bradgrantham/other-m68k/emu/README.md

# other-m68k emulator

`m68k-emu` runs the board's ROM on a Musashi 68000 core with a model of the two CPLDs and the
peripherals: 1 MB RAM, the 1 MB ROM window (two SST39SF040 flash chips, in-system
programmable) with the reset overlay, the CPLD2 registers, the soft
switches, the 320x240 RGB332 framebuffer in an SDL2 window, the 68681 DUART (channel A is the
host's stdin/stdout: the BIOS's POST and banner, then whatever a program sends to `/dev/ttya`), the PS/2 keyboard, an SDHC card on the native 4-bit SD bus (spec rev 7), the 8-bit PDM audio shifter (spec rev 5)
and the NMI/reset buttons.
Addresses, bits and timing constants come from `generated/hw.h` / `generated/emu_map.h`; nothing
is hard-coded that the spec defines.

## Building and running

```
make -C emu            # emu/build/m68k-emu  (needs sdl2-config, host cc)
make -C emu test       # build emu/test/test.S with the m68k cross toolchain and run it headless
make -C emu clean
make emu / make run    # from the top level
```

```
m68k-emu --rom fw/build/flash.img [options]      # or --rom fw/build/rom.bin: BIOS only, C: unformatted

  --rom FILE          ROM window image (<= 1 MB, padded with 0xFF): flash.img = BIOS + C: volume    --sd FILE        SD card image, any multiple of 512 bytes (read/write)
  --rom-save FILE     write the flash contents to FILE at exit if a program/erase changed them (`make run` passes flash.img itself, so C: persists)
  --scale N           window scale (default 3, nearest-neighbour)    --pal            fit the PAL jumper (INTSTAT.PALJMP = 1)
  --fast              no real-time pacing (audio off)                --headless       no window, no audio (works without a display)
  --frames N          exit after N frames                            --trace          disassemble each instruction to stderr
  --trace-from ADDR   start tracing when PC first reaches ADDR       --break ADDR     dump registers and exit when PC reaches ADDR
  --serial-log FILE   copy of the serial (DUART channel A) output     --duart-b-log FILE  DUART channel B output (dropped otherwise)
  --type STR          type STR on the PS/2 keyboard (\n = Enter)     --type-delay N   ... starting after N frames (default 120)
  --serial-type STR   feed STR into the serial port (\n = CR)         --serial-type-delay N  ... after N frames (default 120)
  --joy LIST          hold joystick switches: up,down,left,right,fire       --paddle A,B|pad  paddles at A,B (0..1023) or from a game controller's triggers
  --sd-trace          log SD commands to stderr                      --exit-on-berr   exit with status 2 on the first bus error
  --sd-sdsc           emulate a byte-addressed SDSC card (CSD v1)
  --io-trace          log CPLD2 and DUART register accesses, soft switches and serial RX arrivals with cycle stamps
  --dump-regs-on-exit                                                --dump-mem ADDR LEN   hex dump at exit (repeatable)
  --text-dump FILE    the 40x30 console text decoded from page 0 at exit (- = stdout); the BIOS console is video only after the POST
  --no-audio          disable audio                                  --no-stdin       do not read serial RX from stdin
  --audio-wav FILE    write the rendered audio to a 48 kHz 16-bit mono WAV (also with --headless / --fast)
  --audio-edge-log FILE  log every audio pin edge as 'cycle level' (timing checks)
```

Numbers accept `0x` prefixes. Exit status: 0 normal (frame count reached, window closed,
breakpoint, Ctrl-C), 1 usage/file error, 2 `--exit-on-berr`, 3 CPU halted by a double bus fault
in headless mode.

**stdout carries only the serial output** (unbuffered), so `m68k-emu ... | tee log` or a
terminal program can be attached to it. Everything else (bus errors, SD trace, breakpoints,
dumps, the end-of-run summary) goes to stderr.

Keys in the window: **F11** = reset button (CPU and glue, overlay re-armed), **F12** or
**Pause** = NMI button (INTSTAT.NMIBTN while held, level 7 edge), every other key goes to the
PS/2 keyboard as scan code set 2 (letters, digits, punctuation, space, Enter, Backspace, Tab,
Escape, Shift/Ctrl/Alt/GUI, Caps Lock, arrows, F1-F10, Home/End/PgUp/PgDn/Insert/Delete, keypad).
F11/F12 never reach the keyboard. Window title shows the standard and LED0/LED1.

Serial RX comes from stdin (and from `--serial-type`): when stdin is a tty it is switched to a
raw-ish mode (no echo, no line editing, Ctrl-C still works) for the duration and restored at
exit; a pipe or file works too. Bytes arrive on the DUART's channel A at the console rate
(`SERIAL_BAUD`, one byte per ten bit times) whatever the firmware programmed, so, as on the real
board, bytes that arrive while the receiver is disabled are lost and a burst longer than the
3-byte FIFO plus the shift register sets OE. Piping input in at start-up therefore loses most of
it during the firmware's POST; `--io-trace` shows each arrival. If channel A is enabled at a
rate other than `SERIAL_BAUD` the emulator says so once on stderr (data still flows).

## Timing model

* One Musashi slice per scanline: `line_clocks` CPU clocks (764 NTSC / 768 PAL). The slice
  begins at the HSYNC leading edge, where CPLD1's V counter advances: INTSTAT.HSYNC is set
  there, and INTSTAT.VBLANK at the start of line `v_active + v_bottom` (243 NTSC, 270 PAL),
  the leading edge of VSYNC. The instruction that overruns the budget is charged to the next
  line, so a frame is exactly 764*262 = 200,168 (NTSC) or 768*312 = 239,616 (PAL) clocks and
  the cycle counter stays exact over any interval.
* Live pins in INTSTAT are computed from the position inside the slice: HSYNCPIN during the
  first `h_sync` clocks, DEPIN during `[h_sync + h_back, + h_active)` on active lines,
  VSYNCPIN on the `v_sync` lines.
* The soft switches (PAGE0/1, NTSC/PAL) are latched at the start of line 0 of the next frame,
  as CPLD1 reloads VA. Reset selects NTSC; `--pal` only fits the jumper (PALJMP); firmware
  picks the PAL table with SW_PAL.
* Interrupt priority is recomputed after every flag or enable change: the highest level among
  pending-and-enabled sources (VBLANK 1, PS2 2, DUART 3, HSYNC 4), 7 while the NMI button is
  held. The DUART source is level sensitive: level 3 is requested while the DUART's IRQ output
  ((ISR & IMR) != 0) is asserted and INTEN.DUART is set. All vectors are autovectors (CPLD1 asserts VPA on IACK). Musashi samples IPL only at
  the start of a slice and on SR writes, so a memory handler that changes the level ends the
  slice and the CPU sees it after the current instruction.
* The framebuffer is converted from the displayed page at the end of the last active line (239)
  and presented at the end of the frame, paced to 59.95 Hz (NTSC) or 50.08 Hz (PAL) unless
  `--fast`. `--headless` runs flat out with no SDL at all.
* Memory accesses cost Musashi's nominal cycle counts. The slot alignment penalty of RAM
  accesses on the real board (0 or 2 extra clocks, see `docs/architecture.md` section 2) is not
  modelled, so RAM-heavy code runs 10-25% faster in emulation than on hardware.

## Memory and bus behaviour

* RAM at `RAM_BASE`, ROM at `ROM_BASE` (padded to the 1 MB window with 0xFF; images larger than
  the window are rejected). The window is two SST39SF040 flash chips (`bus.c`, "flash"): a write
  in the ROM region (ROMWE) is fed to a per-byte-lane JEDEC command decoder: unlock
  (AA@5555, 55@2AAA in chip byte addresses, i.e. `FLASH_CMD1`/`FLASH_CMD2` as word writes), byte
  program (A0; bits can only be cleared), sector erase (80 AA 55, 30@sector; 4 KB per chip =
  `FLASH_SECTOR_BYTES` in the CPU view), chip erase (.. 10), software ID (90: `FLASH_MFR_ID`,
  `FLASH_DEV_ID` at chip addresses 0/1) and F0 (exit ID mode). Writes outside a sequence are
  ignored. After a program or erase the lane answers the next few reads with the status bits
  (DQ7 inverted, DQ6 toggling) and then the array data, so the firmware's polling is exercised;
  code fetched from a busy chip is garbage, as on hardware. `--rom-save FILE` writes the window
  back at exit when it was changed (the firmware's `flash` command is tested this way, see
  `fw/README.md`).
* Overlay: set at reset; while set, reads in the RAM region return ROM and writes are dropped.
  It clears at the end of any access whose address is in the ROM region, so the fetch of the
  first instruction at the reset PC clears it.
* IO region: the eight 16-bit registers repeat every 16 bytes (A1..A3 select). CPLD2 has no
  UDS/LDS, so byte accesses are undefined on hardware; here a byte read returns its half of
  the word (with the register's read side effects) and a byte write updates only that half of
  the emulator's shadow. INTEN, GPIO and AUDIO are write-only and read as 0. SDIO (spec rev 7)
  stores six open-drain drive bits for the card lines (1 = released) and reads back the line
  levels, the AND of the host's drive and the card's; offset 12 (the old USERIO) has no
  register (reads 0, writes ignored); ID reads `IO_ID_RESET`.
  32-bit accesses are two word accesses, high word first.
* SWITCHES region: a write at offsets 0/2/4/6 performs PAGE0/PAGE1/NTSC/PAL; reads return
  0xFFFF.
* DUART region: the 68681 is on D0..D7 with RS4..RS1 = A4..A1, so its registers are the odd
  bytes 0xF20001, 0xF20003, ... 0xF2001F, mirrored every 32 bytes through the region. Byte
  accesses at odd addresses are the real thing. A word access completes (DTACK comes from the
  chip) and behaves as the odd byte with 0xFF in the upper half; an even-byte access completes,
  reads 0xFF and reaches no register. Both are reported once on stderr (what the chip makes of
  them on hardware is undefined).
* Anything else raises BERR with the 68000's 7-word group-0 frame: access info word
  (R/W bit 4 = 1 for read, I/N bit 3, FC bits 2..0), fault address, IR, SR, PC. The emulator
  logs `bus error: read 400000 at PC=E00500 (FC=5, ...)` to stderr, at most 10 lines per
  emulated second. Addresses 0xFFFFF0..0xFFFFFF (the IACK pattern) never BERR. A bus error
  while the frame is being written halts the CPU (double fault); headless runs exit with
  status 3, a windowed run says so and waits for F11.
* The RESET instruction does not reset the glue (architecture.md section 6).

### Musashi patch

Stock Musashi always pushes the 68010 format-8 frame on a bus error. `musashi-berr-frame.patch`
(applied to `musashi/m68kcpu.h`) makes `m68ki_exception_bus_error()` push the 68000 frame via
`m68ki_stack_frame_buserr()` when the CPU type is 68000; `bus.c` fills `m68ki_aerr_address`,
`m68ki_aerr_write_mode` and `m68ki_aerr_fc` before calling `m68k_pulse_bus_error()`. The
function code comes from the zero-cost `M68K_SET_FC_CALLBACK` macro in `m68kconf.h`
(`emu_fc`). If Musashi is ever re-vendored, re-apply the patch.

## Peripherals

* **DUART** (`duart.c`): register-level MC68681. Per channel: MR1/MR2 behind the mode-register
  pointer (reset by the CR command), CSR, CR (enable/disable RX and TX, reset MR pointer, reset
  RX, reset TX, reset error status; break commands accepted and ignored), SR (RXRDY, FFULL,
  TXRDY, TXEMT, OE; PE/FE/RB always 0), a 3-byte receive FIFO with the shift register behind
  it (a fourth byte waits there, a fifth sets OE and replaces it), transmit holding + shift
  registers. Shared: ISR (TXRDYA/B, RXRDYA/B or FFULLA/B per MR1[6], CTR, IPC from the
  input-change detector; DBA/DBB always 0), IMR, IVR (stored, reset 0x0F), ACR, IP (the joystick
  port, see below), IPCR (delta bits per ACR[3:0], cleared by the read), OPCR, OPR set/reset
  (OP0 drives the paddle discharge). The
  counter/timer works in counter mode (START loads the preload and counts, terminal count sets
  CTR and rolls over, STOP stops and clears CTR, CUR/CLR read the count) and timer mode (runs
  continuously, CTR every 2*N source clocks, START restarts the phase, STOP only clears CTR)
  from the crystal (X1) or X1/16; the IP2 sources never tick; TxCA/TxCB 1X sources count at
  the channel's bit rate. Bit times come from the data-sheet CSR table (set 1 with ACR[7] = 0,
  set 2 with ACR[7] = 1; code 0xD from the timer; 0xE/0xF external = console rate) and the
  frame length from MR1/MR2, converted to CPU clocks. A byte written to TBA goes straight into
  the shift register if that is idle (TXRDY stays set, TXEMT clears) or waits in the holding
  register (TXRDY clears); it reaches stdout/`--serial-log` when its stop bit ends, and
  back-to-back bytes keep the line busy. Channel B transmits into `--duart-b-log` (or nowhere)
  and never receives. IRQ = (ISR & IMR) != 0 feeds INTSTAT.DUARTIRQ and the level-3 request.
  Reset per the data sheet: both channels disabled, IMR/ISR/OPR/OPCR 0, MR pointers at MR1.
  Not modelled: parity/framing/break detection, CTS/RTS, loopback and multidrop modes,
  1X/16X clock outputs on OP pins, the "do not access" test
  registers (they read 0xFF with a one-time warning).
* **Serial** (`serial.c`): the host side of channel A (stdout, `--serial-log`, stdin raw
  mode, `--serial-type` injection) and channel B's log file; no timing of its own. The BIOS
  mirrors only the POST and banner there, so `--text-dump` (video.c) decodes the 40x30
  console text from page 0 by matching 8x8 cells against the BIOS font.
* **PS/2** (`ps2.c`): make/break sequences queued and delivered one byte per 1 ms of emulated
  time, only while PS2RDY is clear (the register is a single holding latch). Host-to-device
  traffic on GPIO.PS2CLK/PS2DAT is not emulated; the lines read back as the GPIO drives them
  (pulled up when released).
* **SD card** (`sdcard.c`): a card on the native SD bus (not SPI), clocked by the host's
  writes to SDIO.CLK: it samples CMD and DAT0..3 on the rising edge and changes its own outputs
  after the falling edge, so a host that lowers CLK, reads SDIO, then raises CLK sees the card's
  bits at the right time. Every line is open drain: the card drives 0 or releases, and SDIO reads
  the AND of both sides. Commands are 48-bit frames with CRC7, which the card checks (bad CRC: no
  response, COM_CRC_ERROR in the next one; unknown command or wrong state: no response,
  ILLEGAL_COMMAND in the next one). Supported: CMD0 (no response), CMD2 (CID), CMD3 (RCA 0x1234,
  R6), CMD7, CMD8 (R7 echo), CMD9 (CSD v2 sized from the image, v1 with `--sd-sdsc`), CMD10,
  CMD12, CMD13, CMD16 (512 only), CMD17, CMD18, CMD24, CMD25, CMD55, ACMD6 (bus width 1 or 4),
  ACMD41 (busy on the first poll, ready on the second; an SDHC card needs CMD8 first and HCS set,
  as real cards do; OCR then has CCS), ACMD51 (SCR). Timing: response start bit 8 clocks after
  the command's end bit (Ncr), read data start bit 8 clocks after the response (Nac), CRC status
  token 2 clocks after a written block's end bit, then DAT0 busy for 16 clocks. Data blocks are
  512 bytes: 1 bit per clock on DAT0, or after ACMD6 a nibble per clock on DAT3..0 (DAT3 = MSB,
  high nibble of a byte first), each line followed by its own CRC16-CCITT and an end bit; a write
  reaches the image only when every CRC is right (token 010), otherwise token 101. Block
  addressing (SDHC) by default; `--sd-sdsc` makes a byte-addressed SDSC card. `--sd-trace` logs
  every command, state change and block transfer.
* **Audio** (`io.c`, `audio.c`): the AUDIO register (byte offset 10, write-only) loads an 8-bit
  rotating shift register whose bit 7 is the audio pin. It rotates left at each line start (the
  HSYNC leading edge) and then every 24 slots = 96 CPU clocks, 8 slots per line; the slot
  counter restarts at HSYNC, so the 8th timed rotation never happens and the HSYNC rotation
  takes its place. A write replaces the register at once (a rotation due in the same cycle is
  suppressed) and a line without a write repeats the previous byte, as on the CPLD. Note that
  the byte streams out bit 7 first only if it is written in the first slot (within 96 clocks of
  HSYNC); a write in slot k leaves the pattern rotated right by k at the next line start, which
  changes bit order but not density. The shifter is evaluated lazily in time order (rotations
  are applied up to each write, each line start and the end of each frame) and every change of
  bit 7 goes to the renderer as a cycle-stamped edge. The renderer runs the board's RC low-pass
  (`AUDIO_LP_R_OHM` / `AUDIO_LP_C_NF` from the spec, 1 k / 33 nF = 4.8 kHz) over the pin waveform
  exactly, integrates its output over 240 kHz sub-samples, low-passes at 20 kHz with a 95-tap
  windowed-sinc FIR (the anti-alias filter of the sound card the jack would feed) and decimates
  to 48 kHz mono, then a one-pole high-pass stands in for the DC-blocking capacitor. (Up to
  2026-10-22 it box-averaged the pin straight into 48 kHz samples, which let the 63 kHz idle
  tone and the sigma-delta noise above 24 kHz alias into the audio band at about -14 dB:
  the emulator hissed and whined even at idle, which the board does not.) The result is
  queued to SDL (not with `--headless`) and/or written to `--audio-wav FILE`, which works in every mode and receives
  every sample from cycle 0. GPIO bit 2 (the rev 4 audio bit) is stored but does nothing.

* **Joystick port** (spec rev 11): `joy.c` models the Atari port on the DUART's IP/OP pins.
  `--joy` holds switches (active low on IP0..IP4); a game controller, if SDL finds one when a
  window is open, drives them live (d-pad or left stick, any face button = fire). `--paddle A,B`
  puts paddles on the port: once the BIOS releases the discharge (OPR bit 0 set = OP0 low) the
  up and down lines fall A/1023 and B/1023 of `PADDLE_FULL_SCALE_US` (12 ms) later, and rise as
  soon as the capacitors are shorted again; `--paddle pad` takes the positions from the
  controller's triggers. The DUART model gained the input-change detector: the lines are
  compared on every tick (once per video line, so the emulated paddle resolution is about 64 us)
  and on every port read, `IPCR` returns the delta bits and clears them, `ISR.IPC` follows the
  ACR enables, and `OPR_SET`/`OPR_RESET` drive the discharge. Without `--paddle` the lines never
  fall, as with a real joystick.

## Test

`make -C emu test` assembles `test/test.S` (vectors with SSP = SYS_STACK_TOP and PC in ROM),
runs it with `--headless --fast --frames 120 --serial-type ABCDEF --serial-type-delay 1
--serial-log ... --dump-mem 0x800 96` plus an SD image whose block 0 carries a signature, and
`test/check.sh` verifies (57 checks of the ROM run, plus `test/sdtest`, a host-side unit test of the card model: CRC7 and CRC16, 1-bit and 4-bit reads and writes, the CRC status token and busy, bad-CRC and illegal commands, out-of-range and CMD18/CMD12; 50 checks): RAM pattern, ID register, the gradient fill runs, the
DUART init sequence from the spec (IVR 0x0F at reset, MR1A/MR2A read back through the pointer,
SRA = TXRDY+TXEMT after enable), "HELLO\n" sent by polling TXRDY appears on stdout and in the
serial log (and SRA reads 0 while a byte shifts with another in the holding register), a word
read of SRA gives 0xFF in the upper byte and one warning, six bytes injected while the interrupt
is masked leave SRA = RXRDY+FFULL+OE with A B C in the FIFO and F in the shift register (D and E
overrun), the IRQ pin shows in INTSTAT.DUARTIRQ but no interrupt is taken until INTEN.DUART is
set, then exactly one level-3 autovector interrupt drains B C F, reset-error-status clears OE,
counter mode (X1/16, preload 64) reaches terminal count under polling and STOP_CTR clears CTR
and leaves a rolled-over count, timer mode (preload 72, 625 us) delivers 40..100 CTR interrupts
during the three-frame VBLANK wait, VBLANK autovector interrupts are counted (and INTSTAT inside
the handler shows VSYNCPIN without DEPIN), lines per frame measured by counting HSYNC flags
between VBLANKs are 262/312/262 across SW_PAL and SW_NTSC, a read of 0x400000 produces exactly
one bus error whose frame carries fault address 0x400000 and access info 0x0015 (read,
supervisor data), the SD card (native bus, 1-bit) gives CMD0 no response, answers CMD8 with the R7 echo, ACMD41
twice (ready with CCS on the second poll), CMD2, CMD3 (RCA 0x1234), CMD7 and CMD17, and block 0
matches, stdout equals the serial log, the end-of-run summary counts 6 bytes
in with 2 overruns, and the total cycle count is a whole number of frames. The PDM shifter is
checked from `--audio-edge-log`: after one write of 0xB1 every line produces 4 edges, alternating,
three of the four gaps per line are exactly 96/192/288 clocks and the one spanning the line start
is a 1..3 slot run plus the line-start jitter; the `--audio-wav` file has a consistent RIFF header,
48 kHz, one sample per 250 clocks of the run, and is not silent.

## Layout

| file | contents |
|---|---|
| `main.c` | options, Musashi setup, per-line loop, pacing, SDL events, dumps |
| `bus.c/h` | decode, RAM/ROM, overlay, BERR frame, side-effect-free peeks, hex dump |
| `io.c/h` | CPLD2 registers, W1C flags, write-only shadows, PDM audio shifter, IPL, soft-switch latches, `--io-trace` |
| `video.c/h` | NTSC/PAL timing, live pins, RGB332 -> ARGB8888, SDL window |
| `duart.c/h` | MC68681 model: channels, FIFOs, ISR/IMR, counter/timer, bit timing |
| `serial.c/h` | DUART channel A host side: stdout, logs, stdin raw mode, `--serial-type` |
| `ps2.c/h` | scan code set 2 keyboard, `--type` |
| `sdcard.c/h` | native-bus SD card (1- and 4-bit data, CRC7/CRC16, state machine) |
| `audio.c/h` | audio pin renderer: edges -> 48 kHz, SDL queue, `--audio-wav`, `--audio-edge-log` |
| `m68kconf.h` | Musashi configuration (68000 only, INT_ACK, FC macro) |
| `musashi/` | vendored Musashi core (+ `musashi-berr-frame.patch`) |
| `test/` | self-test ROM, linker script, `check.sh` |
