bradgrantham/other-m68k/kicad/release/README.md

# other-m68k release snapshot

Generated by `make -C kicad board route fab release` from the commit that last touched this directory.

- `other-m68k.kicad_pro` + `*.kicad_sch`: the schematic (open the .kicad_pro in KiCad 9; libraries resolve via ../lib)
- `other-m68k.kicad_pcb`: the **routed** board (DRC clean, 0 unrouted)
- `other-m68k-schematic.pdf`, `other-m68k-placement.svg`, `other-m68k-routed.svg`: for review without KiCad
- `fab/`: what PCBWay gets: `other-m68k-gerbers.zip`, `other-m68k-pcbway-bom.csv`, `other-m68k-pcbway-centroid.csv`;
  plus `other-m68k-customer-parts.csv` (what we fit), `other-m68k-bom-check.txt`, generic/JLCPCB BOMs

See ../ORDER.md for the order parameters.
