bradgrantham/other-m68k/generated/HARDWARE.md

<!-- Generated from spec/board.json by tools/gen.py -- DO NOT EDIT; edit the spec and run `make gen`. -->
# other-m68k hardware reference

68000 SBC: 1 MB SRAM, 1 MB flash ROM window (256 KB BIOS image + 768 KB FAT12 volume), memory-mapped 320x240x8 composite and S-video colour framebuffer that time-slices the SRAM with the CPU, PS/2 keyboard, Atari joystick/paddle port on the DUART's I/O pins, bit-banged SD, 68681 DUART serial (two FTDI headers), 8-bit PDM audio (one byte per video line shifted out by CPLD2).

CPU clock 12.000 MHz from a 24 MHz oscillator; one slot = 4 CPU clocks.

## Memory map

| Region | Start | End | Size | Kind | Notes |
|---|---|---|---|---|---|
| RAM | 0x000000 | 0x0FFFFF | 1024 KB | ram | 1 MB SRAM. Time-sliced with the video fetch; CPU accesses are phase-aligned by DTACK (0 or 2 wait clocks). CPLD1 drives MA0..MA16 (CPU A1..A17 or the video counter); CPLD2 drives MA17..MA18 (CPU A18..A19 in the CPU half of a slot, the framebuffer pages' fixed bits 19..18 during the video fetch). At reset the ROM is overlaid here until the first access to the ROM region. |
| ROM | 0xE00000 | 0xEFFFFF | 1024 KB | rom | 1 MB flash window. The BIOS image occupies the first 256 KB (ROM_IMAGE_SIZE, checksum in its last word); the remaining 768 KB (FLASH_VOL_OFFSET..) hold a FAT12 volume that the BIOS mounts as drive C: (see "flash" volume_desc). Reads: zero wait states, not subject to slot alignment. Writes get DTACK and reach the chips (ROMWE), so the firmware can reprogram itself in place and write the volume with the JEDEC command sequence (see "flash"). Vectors at offset 0 (overlaid at 0x000000 at reset). |
| IO | 0xF00000 | 0xF0FFFF | 64 KB | io | CPLD2 peripheral registers. 16-bit word access only; address bits A4..A15 are not decoded, so the 16-byte register block repeats through the region. INTEN, GPIO and AUDIO are write-only (read as 0): the fitter budget does not allow read-back; software keeps shadows. SDIO reads back the six card lines. |
| SWITCHES | 0xF10000 | 0xF1FFFF | 64 KB | io | CPLD1 soft switches. Write-only; writing any value to the address performs the action. Reads return garbage. |
| DUART | 0xF20000 | 0xF2FFFF | 64 KB | io | 68681 DUART. Byte registers on D7..D0 at ODD addresses (A1..A4 -> RS1..RS4); A5..A15 ignored. Use odd-address byte accesses only: an even-byte or word cycle still selects the chip (undefined data; a read pops the FIFO into the wrong lane). DTACK comes from the DUART (open drain, shared with CPLD1); accesses are not slot aligned. |

BERR asserted (bus error exception) for any access outside the regions above, except the interrupt-acknowledge pattern A23..A4 all ones, which is autovectored via VPA.

## Flash ROM

SST39SF040-70-4C-PHE, one per byte lane (U4 = D15..D8 even bytes, U5 = D7..D0 odd bytes). Chip 512 KB, sectors 4096 bytes per chip (8192 bytes in the CPU's word view).

Both chips see the same command sequence because every command is issued as a WORD write with the byte repeated in both halves: chip byte address N is CPU address ROM_BASE + 2N, so the JEDEC unlock addresses 0x5555/0x2AAA become FLASH_CMD1 = ROM_BASE + 0xAAAA and FLASH_CMD2 = ROM_BASE + 0x5554. Program a word: 0xAAAA->CMD1, 0x5555->CMD2, 0xA0A0->CMD1, data->address, then poll until a read returns the data (each byte shows toggling DQ6 / inverted DQ7 while busy; at most 20 us). Erase the 8 KB (CPU view) sector holding address X: 0xAAAA->CMD1, 0x5555->CMD2, 0x8080->CMD1, 0xAAAA->CMD1, 0x5555->CMD2, 0x3030->X, poll until 0xFFFF (at most 25 ms). ID: 0xAAAA->CMD1, 0x5555->CMD2, 0x9090->CMD1; read ROM_BASE -> 0xBFBF, ROM_BASE+2 -> 0xB7B7; 0xF0F0 anywhere exits. Programming only clears bits: erase first. The chips cannot be read (code cannot run from them) while an operation is in progress, so the routine that issues commands runs from RAM with interrupts masked; the NMI button must not be pressed meanwhile. Only word writes are used; a byte write would present the same byte to both chips (the 68000 duplicates write data on both bus halves) and is not part of the protocol.

Drive C: is a FAT12 volume (512-byte sectors, 1536 of them, 4 KB clusters, two FATs, 224 root entries, data aligned to the 8 KB erase sector) in the window at ROM_BASE + FLASH_VOL_OFFSET. The BIOS reads it directly from the flash and writes it through an 8 KB erase-sector cache: a sector write loads the enclosing erase sector into RAM, patches it and, when the cache must move or the file is synced/closed, erases and reprograms the whole 8 KB from a RAM-resident routine with interrupts masked (about 100 ms by the data sheet: erase up to 25 ms plus 4096 word programs of up to 20 us; the emulator's model takes about 150 ms; the routine counts the VBLANK flags it sees meanwhile so the tick counter and the clock stay right, but serial receive bytes beyond the DUART's 3-byte FIFO are lost and audio repeats its last pattern). The volume lives in its own erase sectors, so the monitor's `flash` command, which rewrites only the first ROM_IMAGE_SIZE bytes, leaves it intact, and programming the chips in the TL866 from rom_even.bin/rom_odd.bin (built from fw/build/flash.img = BIOS image + volume image) installs both. The emulator's --rom-save keeps writes across runs. The monitor's `format C:` recreates an empty volume.

| Constant | Value |
|---|---|
| FLASH_CHIP_SIZE | 0x080000UL |
| FLASH_SECTOR_BYTES | 0x002000UL |
| FLASH_VOL_OFFSET | 0x040000UL |
| FLASH_VOL_SIZE | 0x0C0000UL |
| FLASH_CMD1 | 0xE0AAAAUL |
| FLASH_CMD2 | 0xE05554UL |
| FLASH_MFR_ID | 0xBF |
| FLASH_DEV_ID | 0xB7 |
| FLASH_T_BYTE_PROGRAM_US | 20 |
| FLASH_T_SECTOR_ERASE_MS | 25 |
| FLASH_T_CHIP_ERASE_MS | 100 |

## RAM layout

| Area | Start | End | Size | Purpose |
|---|---|---|---|---|
| VECTORS | 0x000000 | 0x0003FF | 1024 bytes | Exception vector table (RAM after overlay clears). |
| SYSDATA | 0x000400 | 0x007FFF | 31744 bytes | BIOS .data/.bss (31 KB: file tables for two volumes, the 8 KB flash erase-sector cache, the flash RAM routine, the script stack); supervisor stack grows down from the top (0x008000). |
| USER | 0x008000 | 0x0DA7FF | 862208 bytes | User program load region (ELF link address 0x008000). User stack grows down from the top (0x0DA800). Extends to 0x0ED400 if page 1 of the framebuffer is not used. |
| FB1 | 0x0DA800 | 0x0ED3FF | 76800 bytes | Framebuffer page 1 (optional double buffer). |
| FB0 | 0x0ED400 | 0x0FFFFF | 76800 bytes | Framebuffer page 0 (default, displayed after reset). |

## Video

320x240, 8 bpp RGB332. bits 7..5 red, 4..2 green, 1..0 blue. Byte at the even (upper, D15..D8) address is the left pixel of the word.

Pages: page 0 at 0x0ED400, page 1 at 0x0DA800

Encoder: AD724 (RGB in, composite out). Standard (NTSC/PAL) fixed by two pull resistors (STND, PALJMP) plus the matching subcarrier crystal; the CPLD timing table is selected by soft switch; jumper state readable in INTSTAT.PALJMP. Board rev C2 also brings the AD724's LUMA and CRMA outputs, each through 220 uF and 75 ohm like the composite output, to an S-video mini-DIN 4 (J10: 1 GND, 2 GND, 3 Y, 4 C); the three outputs are driven at once.

| Standard | Line clocks | H active/front/sync/back | Lines | V active/bottom/sync/top | Rates |
|---|---|---|---|---|---|
| NTSC | 764 | 640/16/56/52 | 262 | 240/3/3/16 | 15.707 kHz, 59.95 Hz |
| PAL | 768 | 640/16/56/56 | 312 | 240/30/3/39 | 15.625 kHz, 50.08 Hz |

All horizontal quantities are CPU clocks and are multiples of the 4-clock slot, so the active region never jitters against the slot grid. Video fetches one 16-bit word (two pixels) per slot during the active region.

Horizontal count 0 = first active pixel; vertical count 0 = first active line. The VBLANK interrupt flag sets at the leading edge of vertical sync (line v_active + v_bottom), not at the end of active video.

## IO registers (base 0xF00000, 16-bit)

CPLD2 peripheral registers. 16-bit word access only; address bits A4..A15 are not decoded, so the 16-byte register block repeats through the region. INTEN, GPIO and AUDIO are write-only (read as 0): the fitter budget does not allow read-back; software keeps shadows. SDIO reads back the six card lines.

### INTSTAT @ 0xF00000 (RW)

Interrupt and pin status. Reading returns flags and live pin levels; bits not listed read 0. Writing 1 to a clearable bit clears it.

| Bit | Name | Description |
|---|---|---|
| 0 | VBLANK | Set at the leading edge of vertical sync (3 lines after the last active line on NTSC). W1C. |
| 1 | HSYNC | Set at start of each horizontal sync. W1C. |
| 2 | PS2RDY | PS/2 byte received; cleared by reading PS2DATA. |
| 3 | DUARTIRQ | Live level of the DUART IRQ pin, inverted (1 = DUART requesting). Read the DUART ISR for the cause. |
| 5 | PS2ERR | PS/2 framing/parity error on last byte. W1C. |
| 7 | NMIBTN | Live level of the NMI/break pushbutton (1 = pressed). |
| 9 | PS2CLK | Live level of PS/2 clock line. |
| 10 | PS2DAT | Live level of PS/2 data line. |
| 12 | PALJMP | 1 = board built for PAL (PALJMP pulled high); rev B pulls it low (NTSC). |
| 13 | VSYNCPIN | Live vertical sync (1 during vsync lines). |
| 14 | DEPIN | Live display enable (1 during active video). |
| 15 | HSYNCPIN | Live horizontal sync (1 during sync). |

### INTEN @ 0xF00002 (W) reset 0x0000

Interrupt enables (write-only, reads 0). A pending flag with its enable set drives IPL at the level listed in interrupts[].

| Bit | Name | Description |
|---|---|---|
| 0 | VBLANK | Enable level-1 interrupt on VBLANK flag. |
| 1 | HSYNC | Enable level-4 interrupt on HSYNC flag. |
| 2 | PS2 | Enable level-2 interrupt on PS2RDY. |
| 3 | DUART | Enable level-3 interrupt while the DUART IRQ pin is asserted. |

### SDIO @ 0xF00004 (RW) reset 0x003F

SD card lines, native 4-bit SD bus bit-banged by the CPU (revision 7). Each bit is an open-drain driver: writing 0 drives the line low, writing 1 releases it to the 10 k pull-up (3.3 V). Reading returns the LEVEL of each line in the same bit position (the card drives CMD during responses and DAT0..3 during reads), so no shadow is needed: read-modify-write works, but the usual loop writes a precomputed word per clock phase. The card samples CMD/DAT on the rising edge of CLK and drives them after the falling edge; the CPU drives CLK low (bit 1 = 0), sets CMD/DAT, then releases CLK (bit 1 = 1). Reset 0x003F: everything released, bus idle with CLK high. SPI mode is no longer wired: CMD has no divider and the card's responses come back on CMD.

| Bit | Name | Description |
|---|---|---|
| 0 | DAT3 | DAT3 (the SPI-mode CS pin). Data line in 4-bit mode; drive low = 0, release = 1. |
| 1 | CLK | Card clock, host driven: 0 drives low, 1 releases high. Idle high. |
| 2 | CMD | Command line, bidirectional: host commands (with CRC7), card responses. |
| 3 | DAT0 | Data line 0 (the only data line in 1-bit mode; busy signal after a write). |
| 4 | DAT1 | Data line 1. |
| 5 | DAT2 | Data line 2. |

### GPIO @ 0xF00006 (W) reset 0x0003

Misc outputs (write-only, reads 0). PS/2 lines are open-drain: 1 releases the line (read it via INTSTAT), 0 pulls it low. Bit 2 is unused since revision 5 (audio moved to the AUDIO register) and must be written 0.

| Bit | Name | Description |
|---|---|---|
| 0 | PS2CLK | PS/2 clock drive (1 = release). |
| 1 | PS2DAT | PS/2 data drive (1 = release). |
| 3 | LED0 | Diagnostic LED 0 (1 = on). |
| 4 | LED1 | Diagnostic LED 1 (1 = on). |

### PS2DATA @ 0xF00008 (R)

Last PS/2 byte received (bits 7..0). Reading clears INTSTAT.PS2RDY.

| Bit | Name | Description |
|---|---|---|
| 7..0 | DATA | Received scan code byte. |

### AUDIO @ 0xF0000A (W) reset 0x0000

PDM audio shifter (write-only, reads 0). The low byte is loaded into an 8-bit rotating shift register whose bit 7 drives the audio pin. CPLD2 rotates it left one place at the leading edge of HSYNC and then every 24 bus slots (192 CLK24 cycles = 96 CPU clocks), i.e. 8 bits per video line, bit 7 first, ~126 kHz PDM; the rotation is resynchronised to HSYNC so it never drifts. Because the register rotates rather than shifting in zeros, a line without a write repeats the previous byte. Write once per line from the HSYNC interrupt, as early in the line as possible; the write replaces the register immediately. The bit pattern is a pulse-density code: the fraction of 1 bits sets the output level (0x00 silence/low, 0xAA or 0x55 mid-level, 0xFF high). The BIOS encodes 8-bit unsigned samples into patterns with a first-order sigma-delta table (the SDK's pdm_encode; the BIOS streams them with audio_start/audio_next/audio_last); a program may also write patterns directly. Writing 0x00 or 0xFF for whole lines and toggling between them gives the old 1-bit behaviour.

| Bit | Name | Description |
|---|---|---|
| 7..0 | PATTERN | PDM bit pattern, bit 7 is shifted out first. |

### ID @ 0xF0000E (R) reset 0x6802

Board/glue identification: 0x68 in the upper byte, CPLD2 logic revision in the lower byte (2 = DUART board).

| Bit | Name | Description |
|---|---|---|
| 7..0 | REV | Glue logic revision. |
| 15..8 | MAGIC | Always 0x68. |

## SWITCHES registers (base 0xF10000, 16-bit)

### PAGE0 @ 0xF10000 (W)

Display framebuffer page 0 (0x0ED400) starting next frame.

### PAGE1 @ 0xF10002 (W)

Display framebuffer page 1 (0x0DA800) starting next frame.

### NTSC @ 0xF10004 (W)

Select NTSC (262-line) timing table. Default at reset.

### PAL @ 0xF10006 (W)

Select PAL (312-line) timing table.

## DUART registers (base 0xF20000, 8-bit, byte access at odd addresses)

MC68681 registers; one name per direction where read and write differ at the same offset. Offsets 5 and 21 must not be READ (factory test locations: CRA/CRB are write-only). Even-address bytes and word accesses in this region do hit the chip (DUARTCS is asserted for any cycle in the region) with undefined data: do not use them.

### MRA @ 0xF20001 (RW)

Mode register: first access after reset or a 'reset MR pointer' command is MR1 (bits: 1..0 bits per char 00=5..11=8, 2 parity mode, 4..3 parity type, 5 error mode, 6 RX interrupt select, 7 RX RTS control), the next is MR2 (bits: 3..0 stop bits (0x7 = 1 stop), 4 CTS enable TX, 5 RTS control, 7..6 channel mode 00 = normal).

### SRA @ 0xF20003 (R)

Status register A.

| Bit | Name | Description |
|---|---|---|
| 0 | RXRDY | Receiver ready: a character is in the FIFO. |
| 1 | FFULL | Receiver FIFO full (3 characters). |
| 2 | TXRDY | Transmitter ready to accept a character. |
| 3 | TXEMT | Transmitter empty. |
| 4 | OE | Overrun error. |
| 5 | PE | Parity error (of the character at the FIFO top). |
| 6 | FE | Framing error. |
| 7 | RB | Received break. |

### CSRA @ 0xF20003 (W)

Clock select: bits 7..4 receiver, 3..0 transmitter baud code from the data-sheet table (set 1, ACR[7]=0: 0xC = 38.4k, 0xB = 9600, 0x8 = 2400; set 2 swaps some rows, e.g. 0xC = 19.2k).

### CRA @ 0xF20005 (W)

Command register: bits 1..0 RX enable/disable (01 enable, 10 disable), 3..2 TX enable/disable, 7..4 misc command (0001 reset MR pointer, 0010 reset RX, 0011 reset TX, 0100 reset error status, 0101 reset break-change interrupt).

### RBA @ 0xF20007 (R)

Receiver buffer A (FIFO top); reading pops the FIFO.

### TBA @ 0xF20007 (W)

Transmitter buffer A.

### IPCR @ 0xF20009 (R)

Input port change register: bits 3..0 the current levels of IP3..IP0, bits 7..4 set when that input changed since the last read (reading clears them and ISR.IPC). Change detection on an input is enabled by its ACR bit 3..0.

| Bit | Name | Description |
|---|---|---|
| 0 | IP0 | level of IP0 |
| 1 | IP1 | level of IP1 |
| 2 | IP2 | level of IP2 |
| 3 | IP3 | level of IP3 |
| 4 | DIP0 | IP0 changed since the last read |
| 5 | DIP1 | IP1 changed since the last read |
| 6 | DIP2 | IP2 changed since the last read |
| 7 | DIP3 | IP3 changed since the last read |

### ACR @ 0xF20009 (W)

Auxiliary control: bit 7 baud-rate set (0 = set 1, used here: 0xC = 38.4k), bits 6..4 counter/timer mode and source, bits 3..0 IP change interrupt enables.

| Bit | Name | Description |
|---|---|---|
| 0 | IPC0_EN | interrupt (ISR.IPC) on a change of IP0 |
| 1 | IPC1_EN | interrupt (ISR.IPC) on a change of IP1 |
| 2 | IPC2_EN | interrupt (ISR.IPC) on a change of IP2 |
| 3 | IPC3_EN | interrupt (ISR.IPC) on a change of IP3 |
| 4 | CT_MODE0 | counter/timer mode and source, bits 6..4: 000 counter IP2, 001 counter TxCA, 010 counter TxCB, 011 counter X1/16, 100 timer IP2, 101 timer IP2/16, 110 timer X1, 111 timer X1/16 |
| 5 | CT_MODE1 | see CT_MODE0 |
| 6 | CT_MODE2 | see CT_MODE0 |
| 7 | BRG_SET | baud-rate generator set (0 = set 1, used: 0xC = 38.4k) |

### ISR @ 0xF2000B (R)

Interrupt status register.

| Bit | Name | Description |
|---|---|---|
| 0 | TXRDYA | TxRDY A |
| 1 | RXRDYA | RxRDY/FFULL A |
| 2 | DBA | Change in break A |
| 3 | CTR | Counter/timer ready |
| 4 | TXRDYB | TxRDY B |
| 5 | RXRDYB | RxRDY/FFULL B |
| 6 | DBB | Change in break B |
| 7 | IPC | Input port change |

### IMR @ 0xF2000B (W)

Interrupt mask register (same bits as ISR).

| Bit | Name | Description |
|---|---|---|
| 0 | TXRDYA | TxRDY A |
| 1 | RXRDYA | RxRDY/FFULL A |
| 2 | DBA | Change in break A |
| 3 | CTR | Counter/timer ready |
| 4 | TXRDYB | TxRDY B |
| 5 | RXRDYB | RxRDY/FFULL B |
| 6 | DBB | Change in break B |
| 7 | IPC | Input port change |

### CUR @ 0xF2000D (R)

Counter upper byte.

### CTUR @ 0xF2000D (W)

Counter/timer upper preset.

### CLR @ 0xF2000F (R)

Counter lower byte.

### CTLR @ 0xF2000F (W)

Counter/timer lower preset.

### MRB @ 0xF20011 (RW)

Mode register: first access after reset or a 'reset MR pointer' command is MR1B (bits: 1..0 bits per char 00=5..11=8, 2 parity mode, 4..3 parity type, 5 error mode, 6 RX interrupt select, 7 RX RTS control), the next is MR2B (bits: 3..0 stop bits (0x7 = 1 stop), 4 CTS enable TX, 5 RTS control, 7..6 channel mode 00 = normal).

### SRB @ 0xF20013 (R)

Status register B.

| Bit | Name | Description |
|---|---|---|
| 0 | RXRDY | Receiver ready: a character is in the FIFO. |
| 1 | FFULL | Receiver FIFO full (3 characters). |
| 2 | TXRDY | Transmitter ready to accept a character. |
| 3 | TXEMT | Transmitter empty. |
| 4 | OE | Overrun error. |
| 5 | PE | Parity error (of the character at the FIFO top). |
| 6 | FE | Framing error. |
| 7 | RB | Received break. |

### CSRB @ 0xF20013 (W)

Clock select: bits 7..4 receiver, 3..0 transmitter baud code from the data-sheet table (set 1, ACR[7]=0: 0xC = 38.4k, 0xB = 9600, 0x8 = 2400; set 2 swaps some rows, e.g. 0xC = 19.2k).

### CRB @ 0xF20015 (W)

Command register: bits 1..0 RX enable/disable (01 enable, 10 disable), 3..2 TX enable/disable, 7..4 misc command (0001 reset MR pointer, 0010 reset RX, 0011 reset TX, 0100 reset error status, 0101 reset break-change interrupt).

### RBB @ 0xF20017 (R)

Receiver buffer B.

### TBB @ 0xF20017 (W)

Transmitter buffer B.

### IVR @ 0xF20019 (RW)

Interrupt vector register. Unused: IACK is tied high and interrupts are autovectored.

### IP @ 0xF2001B (R)

Input port IP0..IP5 (unlatched; bits 6 and 7 read 1). On this board the pins carry the joystick port (see "joystick"): a pressed switch reads 0.

| Bit | Name | Description |
|---|---|---|
| 0 | IP0 | joystick up / paddle A end-of-charge (Schmitt output through a diode) |
| 1 | IP1 | joystick down / paddle B end-of-charge |
| 2 | IP2 | joystick left / paddle button |
| 3 | IP3 | joystick right / paddle button |
| 4 | IP4 | joystick fire |
| 5 | IP5 | spare, pulled up |

### OPCR @ 0xF2001B (W)

Output port configuration register.

### START_CTR @ 0xF2001D (R)

Address-triggered command: start counter/timer.

### OPR_SET @ 0xF2001D (W)

Output port register: set the bits written as 1. The OP pins carry the complement of the register bits (reset: register 0, pins high). OP0 drives the paddle discharge transistors: bit 0 set = pin low = transistors off = the paddle capacitors charge; bit 0 clear = discharging (the reset state). OP1 goes to serial header J11 pin 6 (RTS) for the mouse adapter's power control; the other OP pins are unconnected.

### STOP_CTR @ 0xF2001F (R)

Address-triggered command: stop counter/timer.

### OPR_RESET @ 0xF2001F (W)

Output port register: clear the bits written as 1.

## Interrupts

autovector (VPA asserted by CPLD1 on every IACK; the DUART's IACK pin is tied inactive); vector = 24 + level

| Level | Name | Vector | Source | Description |
|---|---|---|---|---|
| 1 | VBLANK | 25 (0x064) | INTSTAT.VBLANK & INTEN.VBLANK | Leading edge of vertical sync, ~60 Hz (NTSC) / 50 Hz (PAL). |
| 2 | PS2 | 26 (0x068) | INTSTAT.PS2RDY & INTEN.PS2 | PS/2 byte available. |
| 3 | DUART | 27 (0x06C) | DUART IRQ pin & INTEN.DUART | 68681 interrupt (receiver ready, transmitter ready, counter/timer, ...): read the DUART ISR. Level sensitive; the DUART IACK pin is tied high, so this is autovectored like the others. |
| 4 | HSYNC | 28 (0x070) | INTSTAT.HSYNC & INTEN.HSYNC | Line tick, 15.7 kHz; audio sample timer. |
| 7 | NMI | 31 (0x07C) | pushbutton | Break into monitor. Edge-triggered by the 68000. |

## Peripherals

**serial**: device: MC68681 DUART channel A on the FTDI header J2 (serial A); channel B on the identical FTDI header J11 (serial B, board rev C2; rev B/C1 brought it to the expansion header); baud: 38400; format: 8N1; xtal_hz: 3686400; csr: 0xCC; acr_brg_set: 0; mr1: 0x13; mr2: 0x07; cr_commands: OrderedDict({'RESET_MR': '0x10', 'RESET_RX': '0x20', 'RESET_TX': '0x30', 'RESET_ERR': '0x40', 'RESET_BRK': '0x50', 'ENABLE': '0x05'}); init: MR1A=0x13 (8 bits, no parity), MR2A=0x07 (1 stop), ACR=0x00 (baud-rate set 1), CSRA=0xCC (38.4k RX and TX), CRA=0x05 (enable RX+TX); IMR bit 1 (RXRDYA) for receive interrupts; note: 38400 is the highest rate in the 68681's fixed tables: CSR code 0xC is 38.4k in set 1 (ACR[7]=0) and 19.2k in set 2 (ACR[7]=1), data sheet Table 4-5. The counter/timer or an external 16x clock could give more but are not used.; connector: two 6-pin FTDI headers, J2 channel A and J11 channel B (GND, CTS, VCC, TXD, RXD, RTS); on J11 (board rev C3) pin 3 carries 5 V through a 200 mA polyfuse and a Schottky diode to power a device such as the serial-mouse MAX232 adapter (the diode keeps a 5 V FTDI cable from back-feeding the board), and pin 6 (RTS) is DUART OP1, so firmware can switch a mouse's RTS/DTR power and provoke its identification byte; J2 keeps only GND, TXD and RXD; 5V TTL levels, FT232H inputs are 5V tolerant; CTS/RTS not connected; console: Channel A carries the power-on self test report and the BIOS banner. After the banner the BIOS releases it: console output (monitor, exceptions, putchar/puts/write to fd 1 and 2) goes to the video console only and console input (getchar/pollchar, read from fd 0) comes from the PS/2 keyboard only. The receive interrupt keeps filling the 512-byte ring, which serial_getc and reads of /dev/ttya drain; the BIOS itself never touches the port again except for the monitor's `srec` command while it runs, and the `flash` command's RAM routine, which reports its progress and result there because the ROM holding the video console code is being rewritten.; devices: `/dev/ttya` (DUART channel A as a byte stream: open(O_RDONLY/O_WRONLY/O_RDWR; O_CREAT, O_TRUNC and O_APPEND are ignored) needs no card. write sends raw bytes (no newline translation, blocks on the transmitter). read blocks for the first byte and then returns what else is already in the receive ring, up to len. lseek is E_INVAL. Unknown /dev/ names are E_NOENT. An operating system personality that wants a serial terminal opens this and uses it as its console; the BIOS's own console stays on video.)

**ps2**: rx: hardware 11-bit frame receiver in CPLD2 (start, 8 data, odd parity, stop) -> PS2DATA + PS2RDY; tx: software bit-bang via GPIO.PS2CLK/PS2DAT open-drain bits; connector: 6-pin mini-DIN, 5V

**sd**: mode: Native SD bus (not SPI), 4-bit data, bit-banged through SDIO. All six lines (CLK, CMD, DAT0..3) are open-drain from the 5 V CPLD2 with 10 k pull-ups to 3.3 V; the CPU drives a line low or releases it and reads every line back from SDIO. Commands carry CRC7 (48-bit frames on CMD, responses R1/R2/R3/R6/R7 read back on CMD). Data blocks are 512 bytes sent as 1024 nibbles on DAT3..0 (MSB nibble first), start bit (all four lines low), then 16 CRC16-CCITT bits per line, end bit; the BIOS ignores the CRC on reads and computes the four CRC16s on writes. Initialisation: 74+ clocks, CMD0, CMD8 (SDHC), ACMD41 until ready (HCS set), CMD2 (CID), CMD3 (RCA), CMD7 (select), ACMD6 (4-bit bus), CMD16 512 (SDSC); block I/O with CMD17 / CMD24 (single block), busy on DAT0 after a write. Speed: two clock pulses per byte of data (a nibble per pulse) instead of eight in SPI mode.; connector: microSD push-push socket; power: 3.3V LDO; CLK, CMD, DAT0..3 open-drain from CPLD2 (drive low / release) with 10 k pull-ups to 3.3 V; no level dividers.; filesystem: Drive D:. FAT12/16/32 via FatFs (long file names on, see "filesystem"). A FAT32 volume needs >= 65525 clusters: use cards/images of 64 MB or more for FAT32 (smaller ones are FAT16, also fine). The socket has no card-detect line: the card is treated as fixed media; removing it while powered is unsupported (an open file loses its data and the FAT may be left inconsistent).

**filesystem**: drives: Two FatFs volumes with DOS-style letters: C: is the 768 KB FAT12 volume in the flash (always present, see flash.volume_desc), D: is the SD card. Each has its own current directory and there is a current drive, C: after reset. Both are mounted lazily on first use; a card error drops D: and the next access re-initialises it.; paths: A path is [X:][/]dir/.../name. Without a drive letter it refers to the current drive; without a leading slash it is relative to that drive's current directory. "X:" alone names that drive's current directory. Names are VFAT long file names of up to 63 characters (ASCII; case preserved, matched case-insensitively), 8.3 aliases included; a longer or malformed name is E_NAMETOOLONG. Subdirectories, rename, delete and mkdir work on both volumes. Paths that start with /dev/ are devices (serial.devices), not files.; timestamps: Files carry FAT modification dates from the BIOS clock (see "clock"); readdir reports them as dirent.mtime, seconds since 1970-01-01 00:00 local time, 0 when the volume stored none.; search_path: A monitor command word that is not built in is looked up as NAME, NAME.ELF, then NAME.CMD, in the current directory, then C:/, then D:/ (DOS: current directory first, then the path). A word with a drive or directory in it is tried as given, plus .ELF and .CMD. So `D:` then `bmpview foo.bmp` runs C:/BMPVIEW.ELF on D:'s FOO.BMP.; scripts: A .CMD file is a script: its lines are executed as if typed (comments start with # or ;, `echo` prints). A line that runs a program resumes the script when the program exits, so scripts chain programs. ESC aborts a script between lines. C:/AUTOEXEC.CMD runs at boot unless ESC is pressed during the POST.; clock: The BIOS keeps a wall clock as seconds since 1970-01-01 00:00 (local time, no zone) advanced from the VBLANK interrupt using the exact frame length (200,168 or 239,616 CPU clocks). There is no battery: it reads 0 until set with the monitor's `date` command (or sys_set_time), typically from AUTOEXEC.CMD; files written before that get the fixed date 2026-01-01 00:00.

**audio**: enabled: True; lowpass_r_ohm: 1000; lowpass_c_nf: 33; lowpass_desc: First-order RC after the PDM pin (R 1 k, C 33 nF since board rev C1: 4.8 kHz corner; rev B4 had 10 nF). The emulator models exactly this RC on the pin waveform before it samples the result at 48 kHz, so what it plays and writes to --audio-wav is what the jack carries before the divider; without the filter the 63 kHz idle tone and the sigma-delta noise above 24 kHz would alias into the audio band.; desc: AUDIO register -> 8-bit rotating PDM shifter in CPLD2 (8 bits per video line, ~126 kHz) -> 1 k / 33 nF RC low-pass (board rev C1; rev B4 has 10 nF) -> 10 k : 2.2 k divider -> 10 uF DC-blocking cap -> 3.5mm jack. Sampled audio: the program hands the BIOS buffers of PDM pattern bytes (audio_start / audio_next / audio_last, AUDIO_NBUF buffers of up to AUDIO_BUF_MAX bytes, producer/consumer, optionally blocking so the program is paced to the line rate); the BIOS HSYNC interrupt writes one byte per line (15.7 kHz NTSC, 15.6 kHz PAL) and does no other per-sample work. Encoding 8-bit unsigned samples (128 = silence) into patterns is the program's job, normally through the SDK's pdm_init/pdm_encode (first-order sigma-delta, 8-bit accumulator x 7-bit sample table built in RAM). The pattern of a line is repeated by the hardware if no new byte arrives. Beeps: write 0x00/0xFF patterns at the tone rate. Idle level: the mid pattern 0xAA (50 % density) so starting and stopping playback does not click.

**joystick**: connector: J12, DE-9 male (board rev C3), Atari pinout: 1 up, 2 down, 3 left, 4 right, 5 paddle B pot, 6 fire, 7 +5 V (200 mA polyfuse), 8 GND, 9 paddle A pot. Shell to GND. Atari paddle buttons: paddle A's on pin 4 (right), paddle B's on pin 3 (left).; ip_up: 0; ip_down: 1; ip_left: 2; ip_right: 3; ip_fire: 4; ip_spare: 5; op_discharge: 0; pot_c_nf: 15; pot_full_scale_us: 12000; acr_paddles: 0x73; desc: The five switches go through 1 k series resistors to DUART inputs IP0..IP4, which the board already pulls up with 10 k, so a pressed switch reads 0 (sys_joystick inverts and masks them). Paddles: each 1 M pot (pins 9 and 5) charges, through a 1 k series resistor that limits the current when the pot sits at its end stop, a 15 nF capacitor to ground; a 74HC14 Schmitt inverter watches each capacitor and its output pulls the up (paddle A) or down (paddle B) line low through a Schottky diode once the capacitor passes the threshold, so the two lines double as the paddle end-of-charge signals (a joystick never has pots, so its up/down lines are never pulled by the gates; paddles never have the up/down switches). Both capacitors are shorted by a dual NPN driven from OP0 through 4.7 k; OP0 high (the reset state, OPR bit 0 clear) discharges, low releases. Measuring: the BIOS runs the DUART counter/timer in timer mode from X1/16 (230.4 kHz, free-running 16 bits from 0xFFFF, 284 ms wrap) and enables change-of-state interrupts on IP0 and IP1 (ACR = 0x73, IMR.IPC); every VBLANK interrupt it shorts the capacitors; the lines of the paddles that had charged rise, and when the DUART (which samples its inputs at 38.4 kHz) reports that rise through the change interrupt, the level-3 handler releases the capacitors and notes the counter, so the release happens only after the DUART has registered the step and the following fall is always seen, however fast a paddle at zero charges; when a line falls the handler reads IPCR and the counter and stores the elapsed count. If no line rose during a frame (no paddle charged last frame, or none is plugged in) the next VBLANK handler releases directly. IMR is written only when measuring starts and stops. sys_paddles reports each paddle scaled so that 1023 = pot_full_scale_us (12 ms, 2764 counts), clamped, with a valid bit when the line fell during the frame (a paddle at the end stop or no paddle leaves it clear). Paddle measuring is off until the first sys_paddles call and off again at program exit, which also returns the counter/timer and ACR to the serial defaults. The DUART samples its inputs at 38.4 kHz, so a fall is detected 26..52 us after it happens, which together with the interrupt latency behind the level-4 line handler bounds the resolution at about 8 bits. A joystick held up or down while paddles are being measured keeps that line low, so it reads as no paddle (valid clear, 1023) except in the frame the switch closes. Cost (measured in the emulator): about 430 CPU clocks a frame with no paddle plugged in (0.2 %), about 3,500 with two paddles (1.8 %: the rise and the two falls each cost a level-3 interrupt with its DUART register accesses).

**power**: input: USB-C receptacle, 5V only (5.1k CC pull-downs); rails: 5V, 3.3V (SD card only)

**reset**: supervisor: open-drain voltage supervisor + pushbutton -> SYSRESET; diodes to 68000 RESET and HALT; SYSRESET also resets both CPLDs. The RESET instruction does not reset the glue (so the ROM overlay is not re-armed by software).

## System calls

TRAP #15 with the call number in D0.W. Integer args in D1..D3, pointer args in A0..A1 in the order listed. Result in D0.L. All other registers preserved.

| # | Name | Prototype | Description |
|---|---|---|---|
| 0 | exit | `void sys_exit(int code)` | Terminate the program and return to the monitor. |
| 1 | putchar | `int sys_putchar(int c)` | Write a character to the video console. |
| 2 | getchar | `int sys_getchar(void)` | Blocking read of one character from the keyboard. |
| 3 | pollchar | `int sys_pollchar(void)` | Non-blocking keyboard read; -1 if no character is available. |
| 4 | puts | `int sys_puts(const char * s)` | Write a NUL-terminated string to the video console (no newline added). |
| 5 | serial_putc | `int sys_serial_putc(int c)` | Write a byte to serial port A (free for programs after the POST; see also /dev/ttya). |
| 6 | serial_getc | `int sys_serial_getc(void)` | Non-blocking read from serial port A's receive ring; -1 if none. |
| 7 | ticks | `uint32_t sys_ticks(void)` | Frames since boot (VBLANK counter, ~60 Hz). |
| 8 | wait_vblank | `void sys_wait_vblank(void)` | Block until the next vertical blanking interval. |
| 9 | video_info | `int sys_video_info(struct video_info * info)` | Fill in framebuffer geometry, page addresses and current page. |
| 10 | video_set_page | `int sys_video_set_page(int page)` | Select displayed framebuffer page (0 or 1); takes effect at next frame. |
| 11 | open | `int sys_open(int flags, const char * path)` | Open a file (path syntax and names: "filesystem"; O_* flags from the ABI; O_CREAT/O_TRUNC/O_APPEND values differ from newlib's, the SDK shim translates). Returns fd >= 3 or a negative error; fds 0..2 are the console. Paths starting with /dev/ open a device instead (serial.devices); /dev/ttya needs no card. |
| 12 | close | `int sys_close(int fd)` | Close a file. |
| 13 | read | `int sys_read(int fd, unsigned len, void * buf)` | Read up to len bytes. Returns count or negative error. fd 0 is the keyboard (blocks for the first byte, then returns what is queued); /dev/ttya behaves the same on the serial ring. The destination must be in user RAM, or inside a BIOS audio buffer the program currently holds (audio_start/audio_next) so a file can stream straight into it. |
| 14 | write | `int sys_write(int fd, unsigned len, const void * buf)` | Write len bytes. Returns count or negative error. fd 1 and 2 are the video console; a /dev/ttya descriptor sends raw bytes to serial port A. |
| 15 | lseek | `int sys_lseek(int fd, int offset, int whence)` | Reposition; returns new offset or negative error. |
| 16 | opendir | `int sys_opendir(const char * path)` | Open a directory ("" or "." is the current directory); returns handle or negative error. |
| 17 | readdir | `int sys_readdir(int handle, struct dirent * ent)` | Next entry; 1 if filled, 0 at end, negative error. dirent.name is the long name (the 8.3 name if there is no long one), mtime the modification time (seconds since 1970, 0 if none). |
| 18 | closedir | `int sys_closedir(int handle)` | Close a directory handle. |
| 19 | sd_read_block | `int sys_sd_read_block(uint32_t lba, void * buf)` | Raw 512-byte block read. |
| 20 | sd_write_block | `int sys_sd_write_block(uint32_t lba, const void * buf)` | Raw 512-byte block write. |
| 21 | set_irq_handler | `void * sys_set_irq_handler(int level, void * handler)` | Install a user interrupt handler for level 1..4 (called from the BIOS ISR in supervisor mode at that interrupt's own priority, so higher levels can still interrupt it); returns the previous one. NULL restores default. |
| 22 | mem_info | `int sys_mem_info(struct mem_info * info)` | Report the user RAM region available to the program. |
| 23 | con_set_cursor | `int sys_con_set_cursor(int x, int y)` | Move the console text cursor. |
| 24 | con_clear | `int sys_con_clear(void)` | Clear the console. |
| 25 | con_info | `int sys_con_info(struct con_info * info)` | Console columns, rows, cursor position. |
| 26 | exec | `int sys_exec(const char * path, const char * args)` | Load and run another ELF executable (path syntax as for open; no search path) with argument string `args` (passed as given: no wildcard expansion; words split on blanks, double quotes group). Returns a negative error only if the file cannot be opened or does not fit user RAM, before any user memory is overwritten; otherwise the new program replaces the caller and its exit returns to the monitor. |
| 27 | key_event | `int sys_key_event(void)` | Next raw keyboard event: bit 8 = release, bits 7..0 = PS/2 set-2 scan code (E0-prefixed codes have bit 9 set); -1 if none. |
| 28 | sleep_ms | `void sys_sleep_ms(uint32_t ms)` | Delay for approximately ms milliseconds. |
| 29 | set_audio_cb | `int sys_set_audio_cb(void * cb)` | Install a function called from the HSYNC interrupt once per video line (15.7 kHz NTSC) in supervisor mode; it takes over the AUDIO register (the buffer stream of audio_start/next/last is not serviced while a callback is installed, and audio_start fails while one is) and should write one PDM pattern per call. NULL disables. |
| 30 | audio_start | `uint8_t * sys_audio_start(unsigned bufsize)` | Begin streaming PDM pattern bytes to the AUDIO register, one byte per video line (15.7 kHz NTSC, 15.6 kHz PAL). The BIOS owns AUDIO_NBUF buffers of AUDIO_BUF_MAX bytes; bufsize (1..AUDIO_BUF_MAX) is how many bytes of each the program will fill and the hardware will play. Resets the stream (anything queued is dropped, the output goes to the idle pattern) and returns the first buffer to fill. Non-blocking. Returns NULL if bufsize is out of range or an audio callback is installed. The bytes are raw hardware patterns: encode samples with the SDK's pdm_encode (first-order sigma-delta) or write patterns directly. Playback starts at the first audio_next. The buffer is BIOS RAM below user RAM; sys_read may still write into it while the stream is open. |
| 31 | audio_next | `uint8_t * sys_audio_next(const uint8_t * filled, int block)` | Hand the BIOS a buffer the program has filled (one obtained from audio_start or a previous audio_next) and get the next buffer to fill. Buffers play in the order handed in; the HSYNC interrupt is enabled while any are queued. If no buffer is free: block != 0 waits (interrupts enabled) until the one being played finishes, which paces the program to the audio rate; block == 0 returns NULL at once and the program retries later (the handed buffer is still accepted). filled == NULL hands nothing in and only tries to obtain a free buffer. Returns NULL also when the stream is not started, or when filled is not one of the BIOS buffers. |
| 32 | audio_last | `int sys_audio_last(const uint8_t * filled, int block)` | Hand in the final buffer (filled may be NULL for none) and end the stream. block != 0 waits until everything queued has played; block == 0 returns at once and the queued buffers finish playing on their own. When the last byte has played the handler writes the idle pattern 0xAA and disables the HSYNC interrupt, so idle audio costs no CPU. Returns 0, or E_INVAL if the stream was not started. Exiting the program stops the stream at once instead: queued buffers are dropped, the idle pattern is written and the interrupt is disabled. |
| 33 | unlink | `int sys_unlink(const char * path)` | Delete a file or an empty directory. E_NOENT if missing, E_EXIST if the directory is not empty, E_ACCES if the entry is read-only. |
| 34 | rename | `int sys_rename(const char * old, const char * new)` | Rename or move a file or directory within one volume: `new` is resolved against the current directory of the volume `old` is on (a drive letter in `new` is ignored), so give a directory in `new` to move the entry and a bare name to rename it in place when that volume's current directory is the one it lives in. E_EXIST if `new` exists. |
| 35 | mkdir | `int sys_mkdir(const char * path)` | Create a directory. E_EXIST if the name is taken. |
| 36 | chdir | `int sys_chdir(const char * path)` | Change the current directory of a volume, or with a bare "X:" the current drive (DOS semantics: `chdir("D:/GAMES")` sets D:'s directory without switching to it). The setting is global and survives program exit. |
| 37 | getcwd | `int sys_getcwd(unsigned len, char * buf)` | Current drive and directory as "X:/dir/sub" into buf (len bytes, NUL included). Returns the length, E_INVAL if len is 0 or it does not fit, E_NODEV if the current volume is not mounted. |
| 38 | time | `uint32_t sys_time(void)` | BIOS clock: seconds since 1970-01-01 00:00 local time; 0 if it has not been set since power-on ("filesystem" clock). |
| 39 | set_time | `int sys_set_time(uint32_t secs)` | Set the BIOS clock (seconds since 1970-01-01 00:00 local time). Used by the monitor's `date` command; a program may set it too. |
| 40 | joystick | `int sys_joystick(void)` | Joystick switches as a bit mask (JOY_UP, JOY_DOWN, JOY_LEFT, JOY_RIGHT, JOY_FIRE; 1 = pressed), read directly from the DUART input port. With paddles plugged in, left and right are the paddle buttons and up/down are the pot lines (meaningless). |
| 41 | paddles | `int sys_paddles(struct paddles * p)` | Paddle positions: a and b are 0..PADDLE_FULL (1023 = the nominal 12 ms full scale), valid has PADDLE_A_VALID/PADDLE_B_VALID for the lines that fell during the measured frame (clear: no paddle, or at the end stop; the value is then 1023), frame is the ticks value of the measurement. The first call switches measuring on (that call returns valid 0; data follows a frame later); p == NULL switches it off and leaves the capacitors discharged so up/down read as a joystick again. Off at program exit. |

### ABI constants

| Name | Value |
|---|---|
| O_RDONLY | 0 |
| O_WRONLY | 1 |
| O_RDWR | 2 |
| O_CREAT | 256 |
| O_TRUNC | 512 |
| O_APPEND | 1024 |
| SEEK_SET | 0 |
| SEEK_CUR | 1 |
| SEEK_END | 2 |
| ATTR_DIR | 1 |
| ATTR_READONLY | 2 |
| ATTR_HIDDEN | 4 |
| VIDEO_STD_NTSC | 0 |
| VIDEO_STD_PAL | 1 |
| E_NOENT | -2 |
| E_ACCES | -13 |
| E_FAULT | -14 |
| E_IO | -5 |
| E_NOEXEC | -8 |
| E_BADF | -9 |
| E_NOMEM | -12 |
| E_EXIST | -17 |
| E_NOTDIR | -20 |
| E_NODEV | -19 |
| E_ISDIR | -21 |
| E_INVAL | -22 |
| E_NFILE | -23 |
| E_NOSPC | -28 |
| E_ROFS | -30 |
| E_NAMETOOLONG | -36 |
| E_NOSYS | -38 |
| KEY_RELEASE | 256 |
| KEY_EXTENDED | 512 |
| AUDIO_BUF_MAX | 512 |
| AUDIO_NBUF | 3 |
| JOY_UP | 1 |
| JOY_DOWN | 2 |
| JOY_LEFT | 4 |
| JOY_RIGHT | 8 |
| JOY_FIRE | 16 |
| PADDLE_FULL | 1023 |
| PADDLE_A_VALID | 1 |
| PADDLE_B_VALID | 2 |

### ABI structures

`struct video_info { uint32_t width; uint32_t height; uint32_t bpp; uint32_t bytes_per_line; uint32_t page_addr[2]; uint32_t current_page; uint32_t standard; }`

`struct mem_info { uint32_t user_start; uint32_t user_end; uint32_t user_end_without_fb1; }`

`struct con_info { uint32_t cols; uint32_t rows; uint32_t cursor_x; uint32_t cursor_y; }`

`struct dirent { char name[64]; uint32_t size; uint32_t attr; uint32_t mtime; }`

`struct paddles { uint32_t a; uint32_t b; uint32_t valid; uint32_t frame; }`

## Glue logic

**CPLD1** (ATF1508AS-7JX84): MMU: CPU clock divider, address decode, ROM overlay, flash read/write strobes, DTACK/BERR/VPA, SRAM address mux and strobes, video address counter, H/V timing, soft switches, DUART chip select (DTACK released during DUART cycles)

* inputs: CLK24, SYSRESET, A1..A23, AS, UDS, LDS, RW
* outputs: CPUCLK, MA0..MA16, DTACK, BERR, VPA, RAMOE, WEU, WEL, ROMOE, ROMWE, IOCS, BUFEN, LATCH, DE, HSYNC, VSYNC, DUARTCS

**CPLD2** (ATF1508AS-7JX84): I/O and shifter: video word latch and RGB332 pixel output, interrupt controller (incl. DUART IRQ), PS/2 receiver, 4-bit SD card lines (open drain, read back), GPIO bits, 8-bit PDM audio shifter, registers, upper SRAM address bits MA17..MA18 (CPU A18..A19 in the CPU half of each slot, the framebuffer page bits during the video fetch)

* inputs: CLK24, SYSRESET, A1..A3, A18, A19, IOCS, RW, LATCH, DE, HSYNC, VSYNC, PALJMP, NMIBTN, DUART_IRQ
* bidir: D0..D15 (SRAM-side bus), PS2_CLK, PS2_DAT, SD_CLK, SD_CMD, SD_DAT0..SD_DAT3
* outputs: IPL0, IPL1, IPL2, R2, R1, R0, G2, G1, G0, B1, B0, AUDIO, LED0, LED1, MA17, MA18

2x 74AHCT245 between the CPU data bus (CPU, flash, DUART on D0..D7) and the SRAM-side data bus (SRAMs, CPLD2). Enabled only during the CPU half of each slot for RAM and IO cycles; direction from R/W.

DTACK is an open-drain bus with a 4.7k pull-up: CPLD1 drives it low (and high again) for RAM, ROM, IO and SWITCHES cycles and releases it (high-Z) whenever AS is low in the DUART region; the DUART's open-drain DTACK answers those cycles. The DUART IRQ (open drain, pull-up) is an input of CPLD2; its IACK pin is tied high.
