bradgrantham/other-m68k/kicad/release/fab/other-m68k-bom-check.txt

assembled: 161 placements, 51 BOM lines; assembler-supplied chips inserted into sockets: 0; fitted by us: 9

Part numbers written from memory, not yet checked against a distributor listing:

Assembled parts without an MPN: none
Assembled parts without an LCSC number (JLCPCB matches basic passives itself): 52
  C37, C38, C39, C46, C47, C51, D3, D4, D5, F1, F2, F3, FB1, J1, J2, J3, J4, J5, J6, J7, J9, J10, J11, J12, R24, R25, R26, R27, R28, R29, R30, R31, R32, R33, R34, R38, R39, R40, RN1, RN2, RN3, RN4, RN5, RN6, SW1, SW2, U8, U9, U13, X1, Y1, Y2
