bradgrantham/other-m68k/kicad/release/fab/other-m68k-bom.csv

Refs | Value | Footprint | Qty | DNP | Manufacturer | MPN | LCSC | Assembly | Socket MPN | Description | Note | Socket Note
C1,C2,C4-C18,C20-C27,C29,C30,C33-C35,C40,C42,C48-C50 | 100nF | Capacitor_SMD:C_0603_1608Metric | 35 |  | Samsung | CL10B104KB8NNNC | C1591 | pcba |  | 100 nF 50 V X7R 0603
C3,C19,C28,C32,C41,C43,C52 | 10uF | Capacitor_SMD:C_0805_2012Metric | 7 |  | Samsung | CL21A106KAYNNNE | C15850 | pcba |  | 10 uF 25 V X5R 0805
C31 | 33nF | Capacitor_SMD:C_0603_1608Metric | 1 |  | Samsung | CL10B333KB8NFNC | C307488 | pcba |  | 33 nF 50 V X7R 0603
C36 | 10pF | Capacitor_SMD:C_0603_1608Metric | 1 |  | Samsung | CL10C100JB8NNNC | C32949 | pcba |  | 10 pF 50 V C0G 0603
C37-C39 | 220uF | Capacitor_THT:CP_Radial_D6.3mm_P2.50mm | 3 |  | Rubycon | 16ZLH220MEFC6.3X11 |  | pcba |  | 220 uF 16 V electrolytic, 6.3 mm dia, 2.5 mm pitch
C44 | 15pF | Capacitor_SMD:C_0603_1608Metric | 1 |  | Samsung | CL10C150JB8NNNC | C1644 | pcba |  | 15 pF 50 V C0G 0603
C45 | DNP (0-5pF) | Capacitor_SMD:C_0603_1608Metric | 1 | DNP |  |  |  | dnp |  | not fitted (crystal trim)
C46,C47 | 15nF | Capacitor_SMD:C_0603_1608Metric | 2 |  | Samsung | CL10B153KB8NNNC |  | pcba |  | 15 nF 50 V X7R 0603; any 0603 X7R 15 nF 50 V is acceptable | Avnet/Future stock the Samsung part
C51 | 100uF | Capacitor_THT:CP_Radial_D6.3mm_P2.50mm | 1 |  | Rubycon | 35ZLH100MEFC6.3X11 |  | pcba |  | 100 uF 35 V electrolytic, 6.3 mm dia, 2.5 mm pitch | 35 V part chosen for the can size: the 16 V ZLH 100 uF is a 5 mm can
C53,C54 | 1uF | Capacitor_SMD:C_0603_1608Metric | 2 |  | Samsung | CL10A105KB8NNNC | C15849 | pcba |  | 1 uF 50 V X5R 0603
D1,D2 | 1N4148W | Diode_SMD:D_SOD-123 | 2 |  | Diodes Inc | 1N4148W-7-F | C81598 | pcba |  | 1N4148W SOD-123
D3,D4 | LED green | LED_SMD:LED_0805_2012Metric | 2 |  | Lite-On | LTST-C171GKT |  | pcba |  | green LED 0805, 2.1 V
D5 | LED red (power) | LED_SMD:LED_0805_2012Metric | 1 |  | Lite-On | LTST-C171KRKT |  | pcba |  | red LED 0805, 2.0 V
D6-D8 | BAT54W | Package_TO_SOT_SMD:SOT-323_SC-70 | 3 |  | Nexperia | BAT54W,115 | C8657 | pcba |  | Schottky diode 30 V 200 mA, SOT-323 | DigiKey/Mouser/LCSC stocked
F1 | 2A | Fuse:Fuse_1206_3216Metric | 1 |  | Littelfuse | 1206L200PR |  | pcba |  | PTC resettable fuse 2 A hold / 3.5 A trip, 6 V, 1206
F2,F3 | 200mA | Fuse:Fuse_1206_3216Metric | 2 |  | Littelfuse | 1206L020YR |  | pcba |  | PTC resettable fuse 0.2 A hold / 0.42 A trip, 24 V, 1206 | DigiKey/Element14
FB1 | 600R@100MHz | Inductor_SMD:L_0603_1608Metric | 1 |  | Murata | BLM18PG601SN1D |  | pcba |  | ferrite bead 600 ohm @ 100 MHz 0603
H1-H4 | M3 | MountingHole:MountingHole_3.2mm_M3_Pad | 4 | DNP |  |  |  | dnp |  | mounting hole
J1 | USB-C power | Connector_USB:USB_C_Receptacle_GCT_USB4125-xx-x_6P_TopMnt_Horizontal | 1 |  | GCT | USB4125-GF-A-0190 |  | pcba |  | USB-C receptacle, 6 pin, power only, right angle | DigiKey/Farnell/Future list it; stock varies
J2 | FTDI (GND CTS VCC TXD RXD RTS) | Connector_PinHeader_2.54mm:PinHeader_1x06_P2.54mm_Vertical | 1 |  | Sullins | PRPC006SAAN-RC |  | pcba |  | pin header 1x6 2.54 mm
J3 | PS/2 | other-m68k:MiniDIN-6_CUI_MD-60SM_Horizontal | 1 |  | CUI Devices | MD-60SM |  | pcba |  | mini-DIN 6 jack, right angle
J4 | microSD DM3AT-SF-PEJM5 | Connector_Card:microSD_HC_Hirose_DM3AT-SF-PEJM5 | 1 |  | Hirose | DM3AT-SF-PEJM5 |  | pcba |  | microSD socket, push-push, card detect
J5 | RCA composite | other-m68k:RCA_CUI_RCJ-041_Horizontal | 1 |  | CUI Devices | RCJ-041 |  | pcba |  | RCA jack, right angle, yellow
J6 | 3.5mm audio | Connector_Audio:Jack_3.5mm_CUI_SJ1-3523N_Horizontal | 1 |  | CUI Devices | SJ1-3523N |  | pcba |  | 3.5 mm stereo jack, right angle
J7 | JTAG (ByteBlaster) | Connector_PinHeader_2.54mm:PinHeader_2x05_P2.54mm_Vertical | 1 |  | Sullins | PRPC005DAAN-RC |  | pcba |  | pin header 2x5 2.54 mm
J9 | Logic analyzer (gusmanb 2x15) | Connector_PinHeader_2.54mm:PinHeader_2x15_P2.54mm_Vertical | 1 |  | Sullins | PRPC015DAAN-RC |  | pcba |  | pin header 2x15 2.54 mm (logic analyzer channels)
J10 | S-video | other-m68k:MiniDIN-4_CUI_MD-40SM_Horizontal | 1 |  | CUI Devices | MD-40SM |  | pcba |  | mini-DIN 4 jack (S-video), right angle
J11 | FTDI B (GND CTS VCC TXD RXD RTS) | Connector_PinHeader_2.54mm:PinHeader_1x06_P2.54mm_Vertical | 1 |  | Sullins | PRPC006SAAN-RC |  | pcba |  | pin header 1x6 2.54 mm
J12 | Joystick (Atari DE-9) | Connector_Dsub:DSUB-9_Pins_Horizontal_P2.77x2.84mm_EdgePinOffset7.70mm_Housed_MountingHolesOffset9.12mm | 1 |  | Amphenol ICC | L717SDE09PA4CH4F |  | pcba |  | DE-9 male (plug), right angle, housed, 4-40 boardlocks, .318 in (8.08 mm) backset; any L717SDE09PA4CH4x is the same connector | The .318 in backset is KiCad's EdgePinOffset7.70/MountingHolesOffset9.12 footprint. DigiKey stocks it as L717SDE09PA4CH4FA610, Farnell as L717SDE09PA4CH4F
Q1 | MMDT3904 | Package_TO_SOT_SMD:SOT-363_SC-70-6 | 1 |  | Diodes Incorporated | MMDT3904-7-F | C8706 | pcba |  | dual NPN, SOT-363
R1-R5,R9,R10,R14,R41,R55,R56 | 4.7k | Resistor_SMD:R_0603_1608Metric | 11 |  | Yageo | RC0603FR-074K7L | C23162 | pcba |  | 4.7 k 1% 0603
R6-R8,R11,R15-R20,R22,R35-R37,R42-R47,R57 | 10k | Resistor_SMD:R_0603_1608Metric | 21 |  | Yageo | RC0603FR-0710KL | C25804 | pcba |  | 10 k 1% 0603
R12,R13,R21,R48-R54,R60 | 1k | Resistor_SMD:R_0603_1608Metric | 11 |  | Yageo | RC0603FR-071KL | C21190 | pcba |  | 1 k 1% 0603
R23 | 2.2k | Resistor_SMD:R_0603_1608Metric | 1 |  | Yageo | RC0603FR-072K2L | C4190 | pcba |  | 2.2 k 1% 0603
R24,R28 | 787 1% | Resistor_SMD:R_0603_1608Metric | 2 |  | Yageo | RC0603FR-07787RL |  | pcba |  | 787 ohm 1% 0603 (DAC)
R25,R29 | 1.58k 1% | Resistor_SMD:R_0603_1608Metric | 2 |  | Yageo | RC0603FR-071K58L |  | pcba |  | 1.58 k 1% 0603 (DAC)
R26,R30 | 3.16k 1% | Resistor_SMD:R_0603_1608Metric | 2 |  | Yageo | RC0603FR-073K16L |  | pcba |  | 3.16 k 1% 0603 (DAC)
R27,R31,R34,R38-R40 | 75 | Resistor_SMD:R_0603_1608Metric | 6 |  | Yageo | RC0603FR-0775RL |  | pcba |  | 75 ohm 1% 0603
R32 | 681 1% | Resistor_SMD:R_0603_1608Metric | 1 |  | Yageo | RC0603FR-07681RL |  | pcba |  | 681 ohm 1% 0603 (DAC)
R33 | 1.37k 1% | Resistor_SMD:R_0603_1608Metric | 1 |  | Yageo | RC0603FR-071K37L |  | pcba |  | 1.37 k 1% 0603 (DAC)
R58,R59 | 5.1k | Resistor_SMD:R_0603_1608Metric | 2 |  | Yageo | RC0603FR-075K1L | C23186 | pcba |  | 5.1 k 1% 0603 (USB-C CC pull-downs)
RN1-RN6 | 4x100 | Resistor_SMD:R_Array_Convex_4x0603 | 6 |  | Yageo | YC164-JR-07100RL |  | pcba |  | 4 x 100 ohm resistor array, 4x0603 convex (1206 size); alt Panasonic EXB-38V101JV
SW1 | RESET | Button_Switch_THT:SW_PUSH_6mm | 1 |  | Omron | B3F-1000 |  | pcba |  | tactile switch 6 mm THT
SW2 | NMI | Button_Switch_THT:SW_PUSH_6mm | 1 |  | Omron | B3F-1000 |  | pcba |  | tactile switch 6 mm THT
TP1 | VIDEO | TestPoint:TestPoint_Pad_D1.5mm | 1 | DNP |  |  |  | dnp |  | test pad, composite video
TP2 | +3V3 | TestPoint:TestPoint_Pad_D1.5mm | 1 | DNP |  |  |  | dnp |  | test pad, +3.3 V
TP3 | VCC | TestPoint:TestPoint_Pad_D1.5mm | 1 | DNP |  |  |  | dnp |  | test pad, +5 V
TP4 | GND | TestPoint:TestPoint_Pad_D1.5mm | 1 | DNP |  |  |  | dnp |  | test pad, GND
U1 | MC68000P12 | Package_DIP:DIP-64_W22.86mm_Socket | 1 |  | Motorola | MC68000P12 |  | socket | DIP-64 socket, 0.9 in rows, dual-wipe | 68000 CPU 12 MHz DIP-64 |  | Named generically so the assembler looks for a stamped socket first. PCBWay quoted the Mill-Max at $38 (2026-10); DigiKey sells it for about $15. No stamped 0.9 in DIP-64 found at DigiKey/Mouser
U2 | AS6C4008-55PCN (upper, D15..D8) | Package_DIP:DIP-32_W15.24mm_Socket | 1 |  | Alliance Memory | AS6C4008-55PCN |  | socket | A 32-LC-TT | 512K x 8 SRAM 55 ns DIP-32, 2.7-5.5 V (upper byte, D15..D8) |  | RS 674-2463; A 32-LC-TR is the same socket at DigiKey
U3 | AS6C4008-55PCN (lower, D7..D0) | Package_DIP:DIP-32_W15.24mm_Socket | 1 |  | Alliance Memory | AS6C4008-55PCN |  | socket | A 32-LC-TT | 512K x 8 SRAM 55 ns DIP-32, 2.7-5.5 V (lower byte, D7..D0) |  | RS 674-2463; A 32-LC-TR is the same socket at DigiKey
U4 | SST39SF040-70 (even, D15..D8) | Package_DIP:DIP-32_W15.24mm_Socket | 1 |  | Microchip | SST39SF040-70-4C-PHE |  | socket | A 32-LC-TT | 512K x 8 flash DIP-32 (even byte, D15..D8) |  | RS 674-2463; A 32-LC-TR is the same socket at DigiKey
U5 | SST39SF040-70 (odd, D7..D0) | Package_DIP:DIP-32_W15.24mm_Socket | 1 |  | Microchip | SST39SF040-70-4C-PHE |  | socket | A 32-LC-TT | 512K x 8 flash DIP-32 (odd byte, D7..D0) |  | RS 674-2463; A 32-LC-TR is the same socket at DigiKey
U6 | ATF1508AS-7JX84 (MMU) | Package_LCC:PLCC-84_THT-Socket | 1 |  | Microchip | ATF1508AS-7JX84 |  | socket | A-CCS-084-Z-T | CPLD PLCC-84 (MMU) |  | DigiKey 5023770 / AE11110-ND, RS 674-2555. Replaces the Preci-dip PCBWay could not source (2026-10)
U7 | ATF1508AS-7JX84 (I/O) | Package_LCC:PLCC-84_THT-Socket | 1 |  | Microchip | ATF1508AS-7JX84 |  | socket | A-CCS-084-Z-T | CPLD PLCC-84 (I/O) |  | DigiKey 5023770 / AE11110-ND, RS 674-2555. Replaces the Preci-dip PCBWay could not source (2026-10)
U8 | 74AHCT245 (hi) | Package_SO:SOIC-20W_7.5x12.8mm_P1.27mm | 1 |  | Texas Instruments | SN74AHCT245DW |  | pcba |  | octal bus transceiver SOIC-20 wide
U9 | 74AHCT245 (lo) | Package_SO:SOIC-20W_7.5x12.8mm_P1.27mm | 1 |  | Texas Instruments | SN74AHCT245DW |  | pcba |  | octal bus transceiver SOIC-20 wide
U10 | MC68681P | Package_DIP:DIP-40_W15.24mm_Socket | 1 |  | Motorola | MC68681P |  | socket | A 40-LC-TT | DUART DIP-40 |  | Same family as the DIP-32 sockets; A 40-LC-TR at DigiKey. Replaces the Mill-Max PCBWay quoted at $22
U11 | AD724JR | Package_SO:SOIC-16W_7.5x10.3mm_P1.27mm | 1 |  | Analog Devices | AD724JRZ |  | customer |  | RGB to NTSC/PAL encoder, SOIC-16W | Not in the assembly BOM: we buy and hand-solder it. LAST TIME BUY, DigiKey LTB 2027-07-29, about $25 there against $77 quoted by PCBWay (2026-10); buy spares for the bare boards
U12 | AP2112K-3.3 | Package_TO_SOT_SMD:SOT-23-5 | 1 |  | Diodes Inc | AP2112K-3.3TRG1 | C51118 | pcba |  | 3.3 V 600 mA LDO SOT-23-5
U13 | MCP130T-450I/TT | Package_TO_SOT_SMD:SOT-23 | 1 |  | Microchip | MCP130T-450I/TT |  | pcba |  | 4.50 V reset supervisor, open drain, SOT-23
U14 | 74HC14 | Package_SO:SOIC-14_3.9x8.7mm_P1.27mm | 1 |  | Nexperia | 74HC14D,653 | C5612 | pcba |  | hex Schmitt inverter, SOIC-14
X1 | 24MHz | Oscillator:Oscillator_DIP-8 | 1 |  | ECS | ECS-2200B-240 |  | pcba |  | 24 MHz 5 V HCMOS oscillator, half-size DIP-8; any 24 MHz 5 V half-size DIP-8 oscillator is acceptable | Pin 1 is tied to VCC, so any part with pin 1 NC or an active-high enable fits; the ECS-2200B-240 has a tri-state pin 1 with internal pull-up. DigiKey in stock 2026-10; the ECS-2100A-240 of the B4 BOM was 18 weeks
Y1 | 3.6864MHz | Crystal:Crystal_HC49-U_Vertical | 1 |  | ECS | ECS-36-20-4XDN |  | pcba |  | 3.6864 MHz crystal HC-49/US, 20 pF | -40..85 C grade; the commercial ECS-36-20-4DN is NRND
Y2 | 3.579545MHz | Crystal:Crystal_HC49-U_Vertical | 1 |  | ECS | ECS-35-17-4X |  | pcba |  | 3.579545 MHz crystal HC-49/US (NTSC subcarrier)
