bradgrantham/other-m68k/kicad/release/other-m68k-schematic.pdf

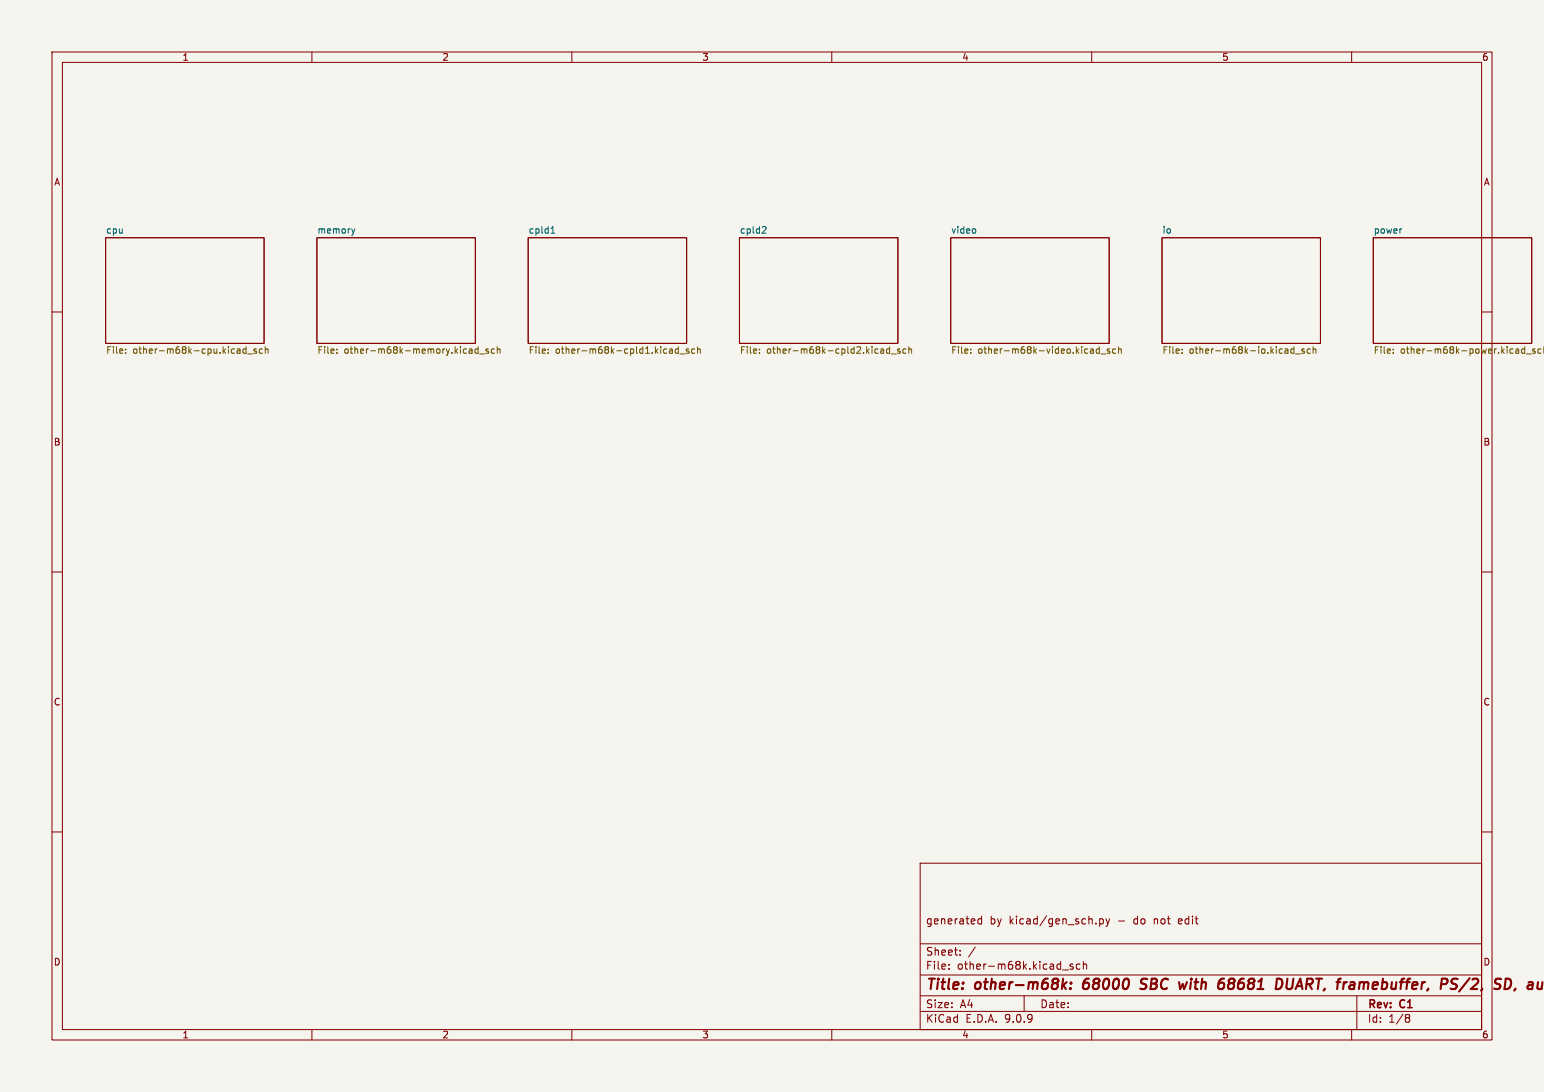
[picture p1: page 1]

video File: other-m68k-video.kicad_sch

power File: other-m68k-power.kicad_sch

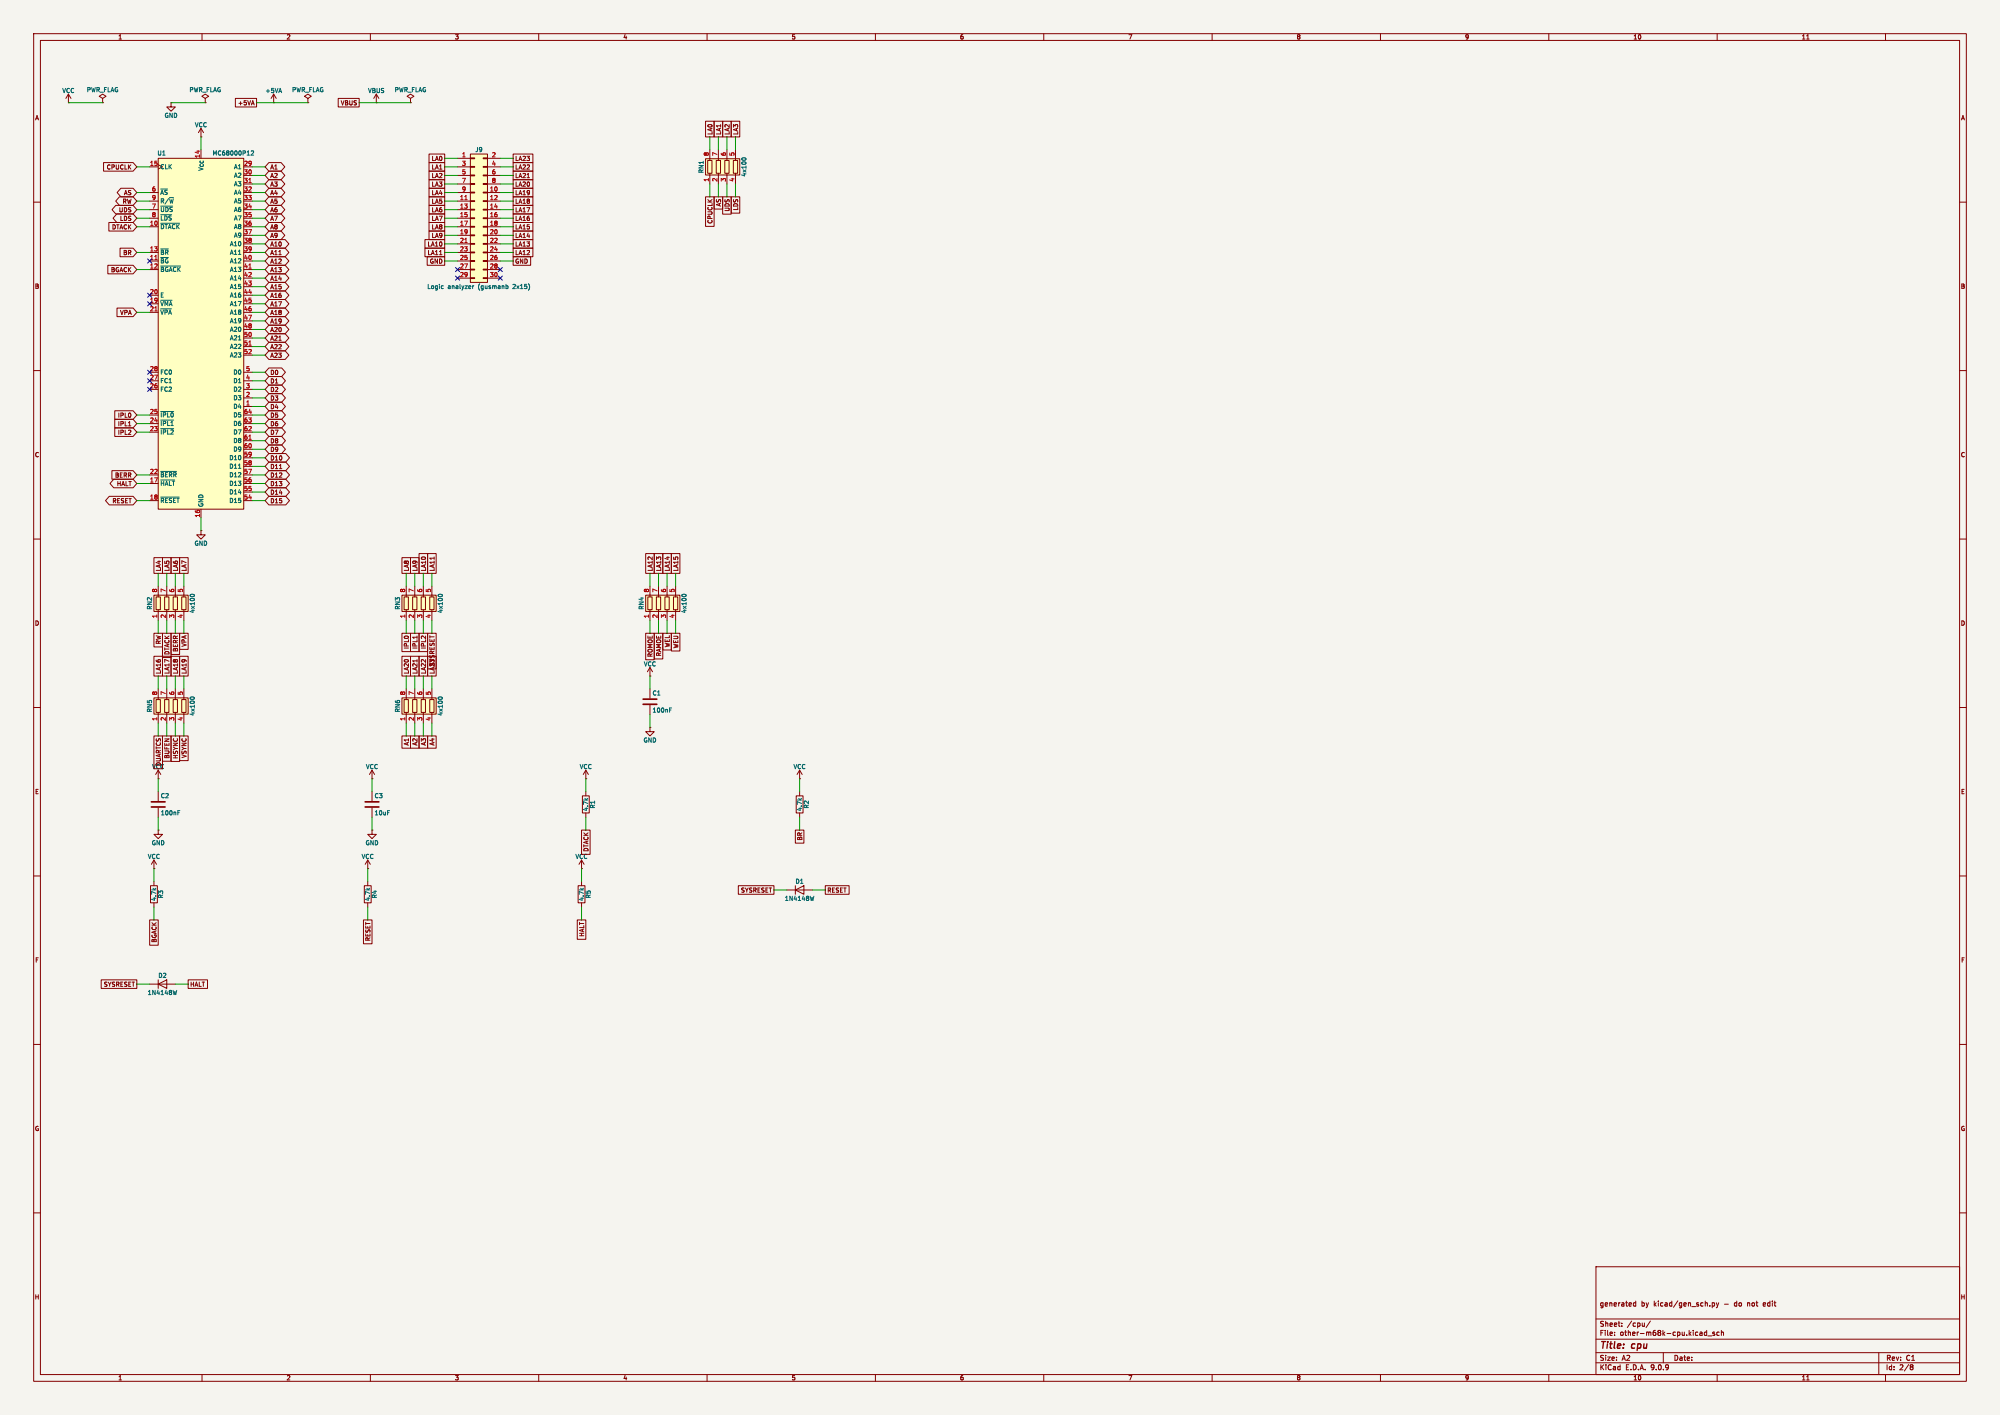
[picture p2: page 2]

File: other-m68k-cpu.kicad_sch Sheet: /cpu/

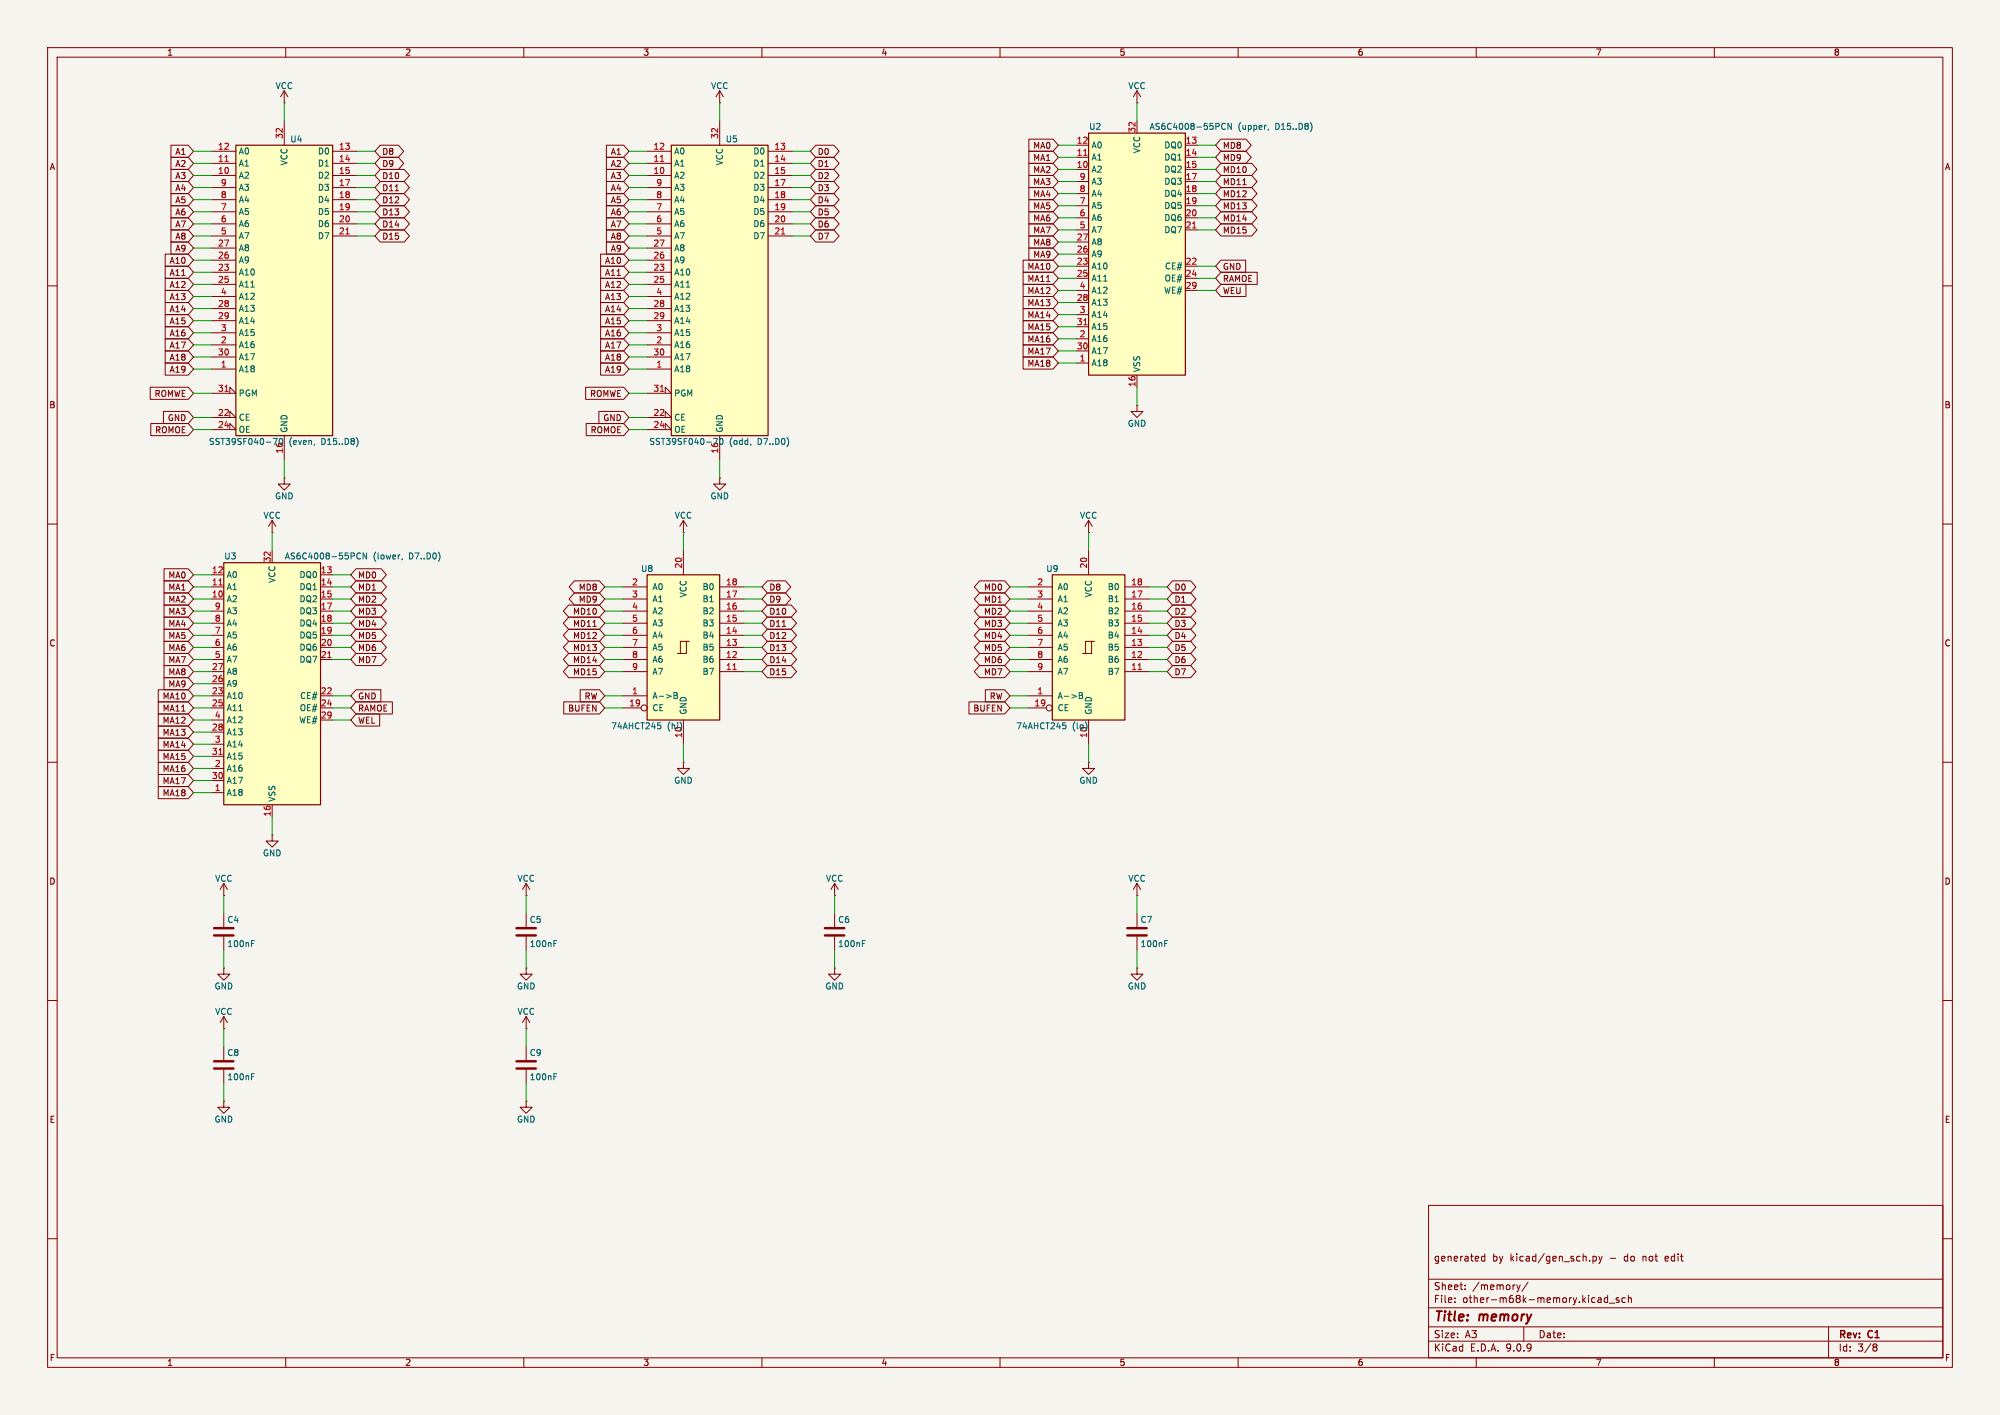
[picture p3: page 3]

File: other-m68k-memory.kicad_sch Sheet: /memory/
Id: 3/8 Title: memory

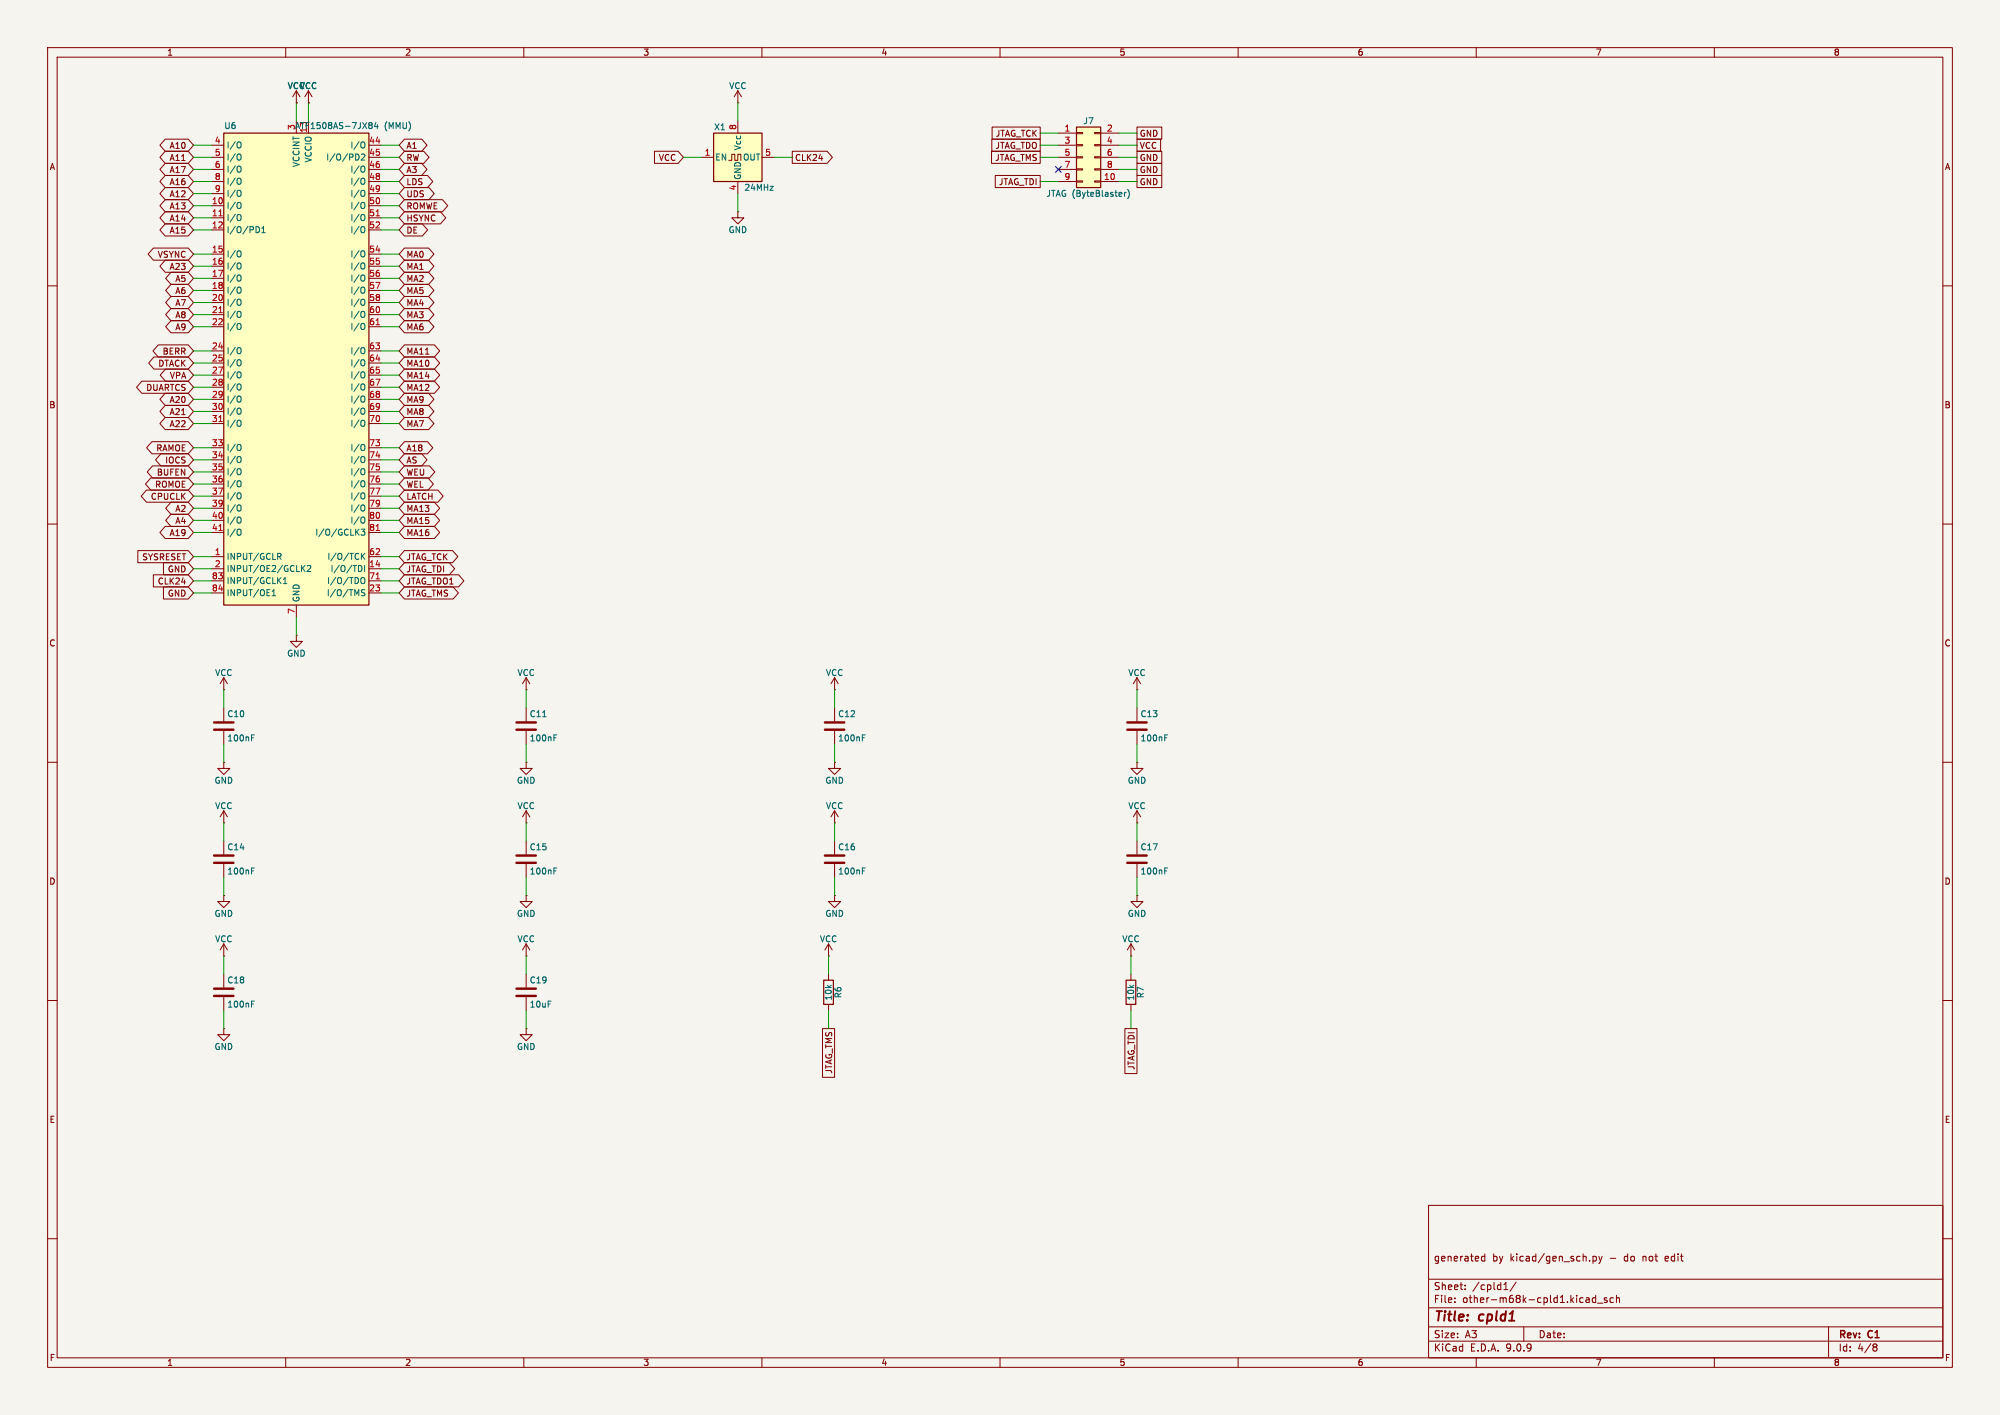
[picture p4: page 4]

LDS MA16 MA15 MA13
LATCH WEL ROMWE WEU
HSYNC

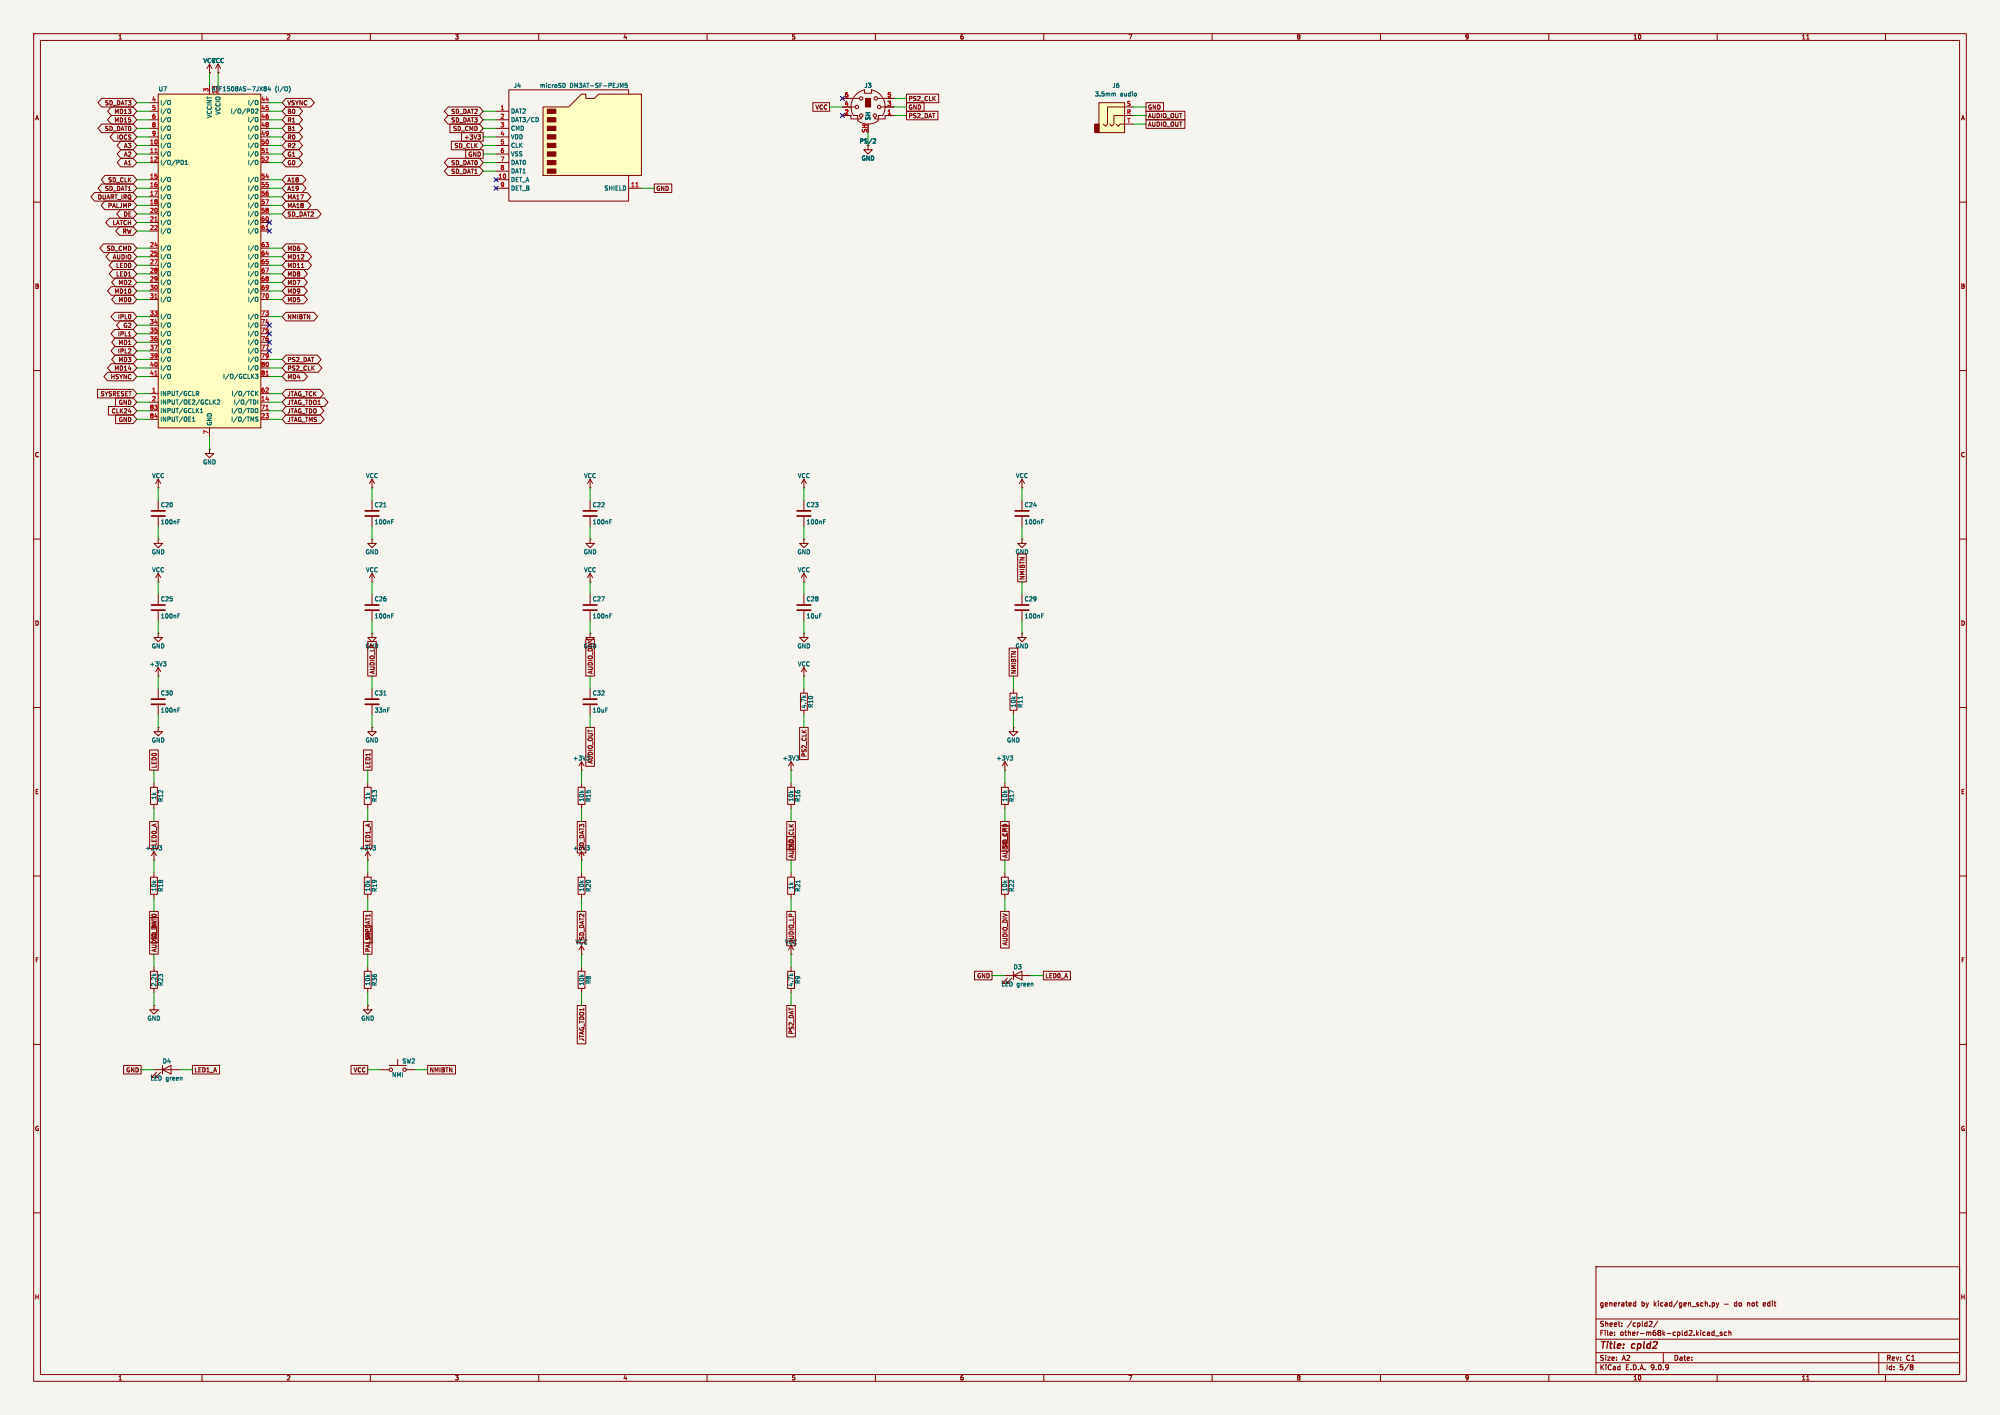
[picture p5: page 5]

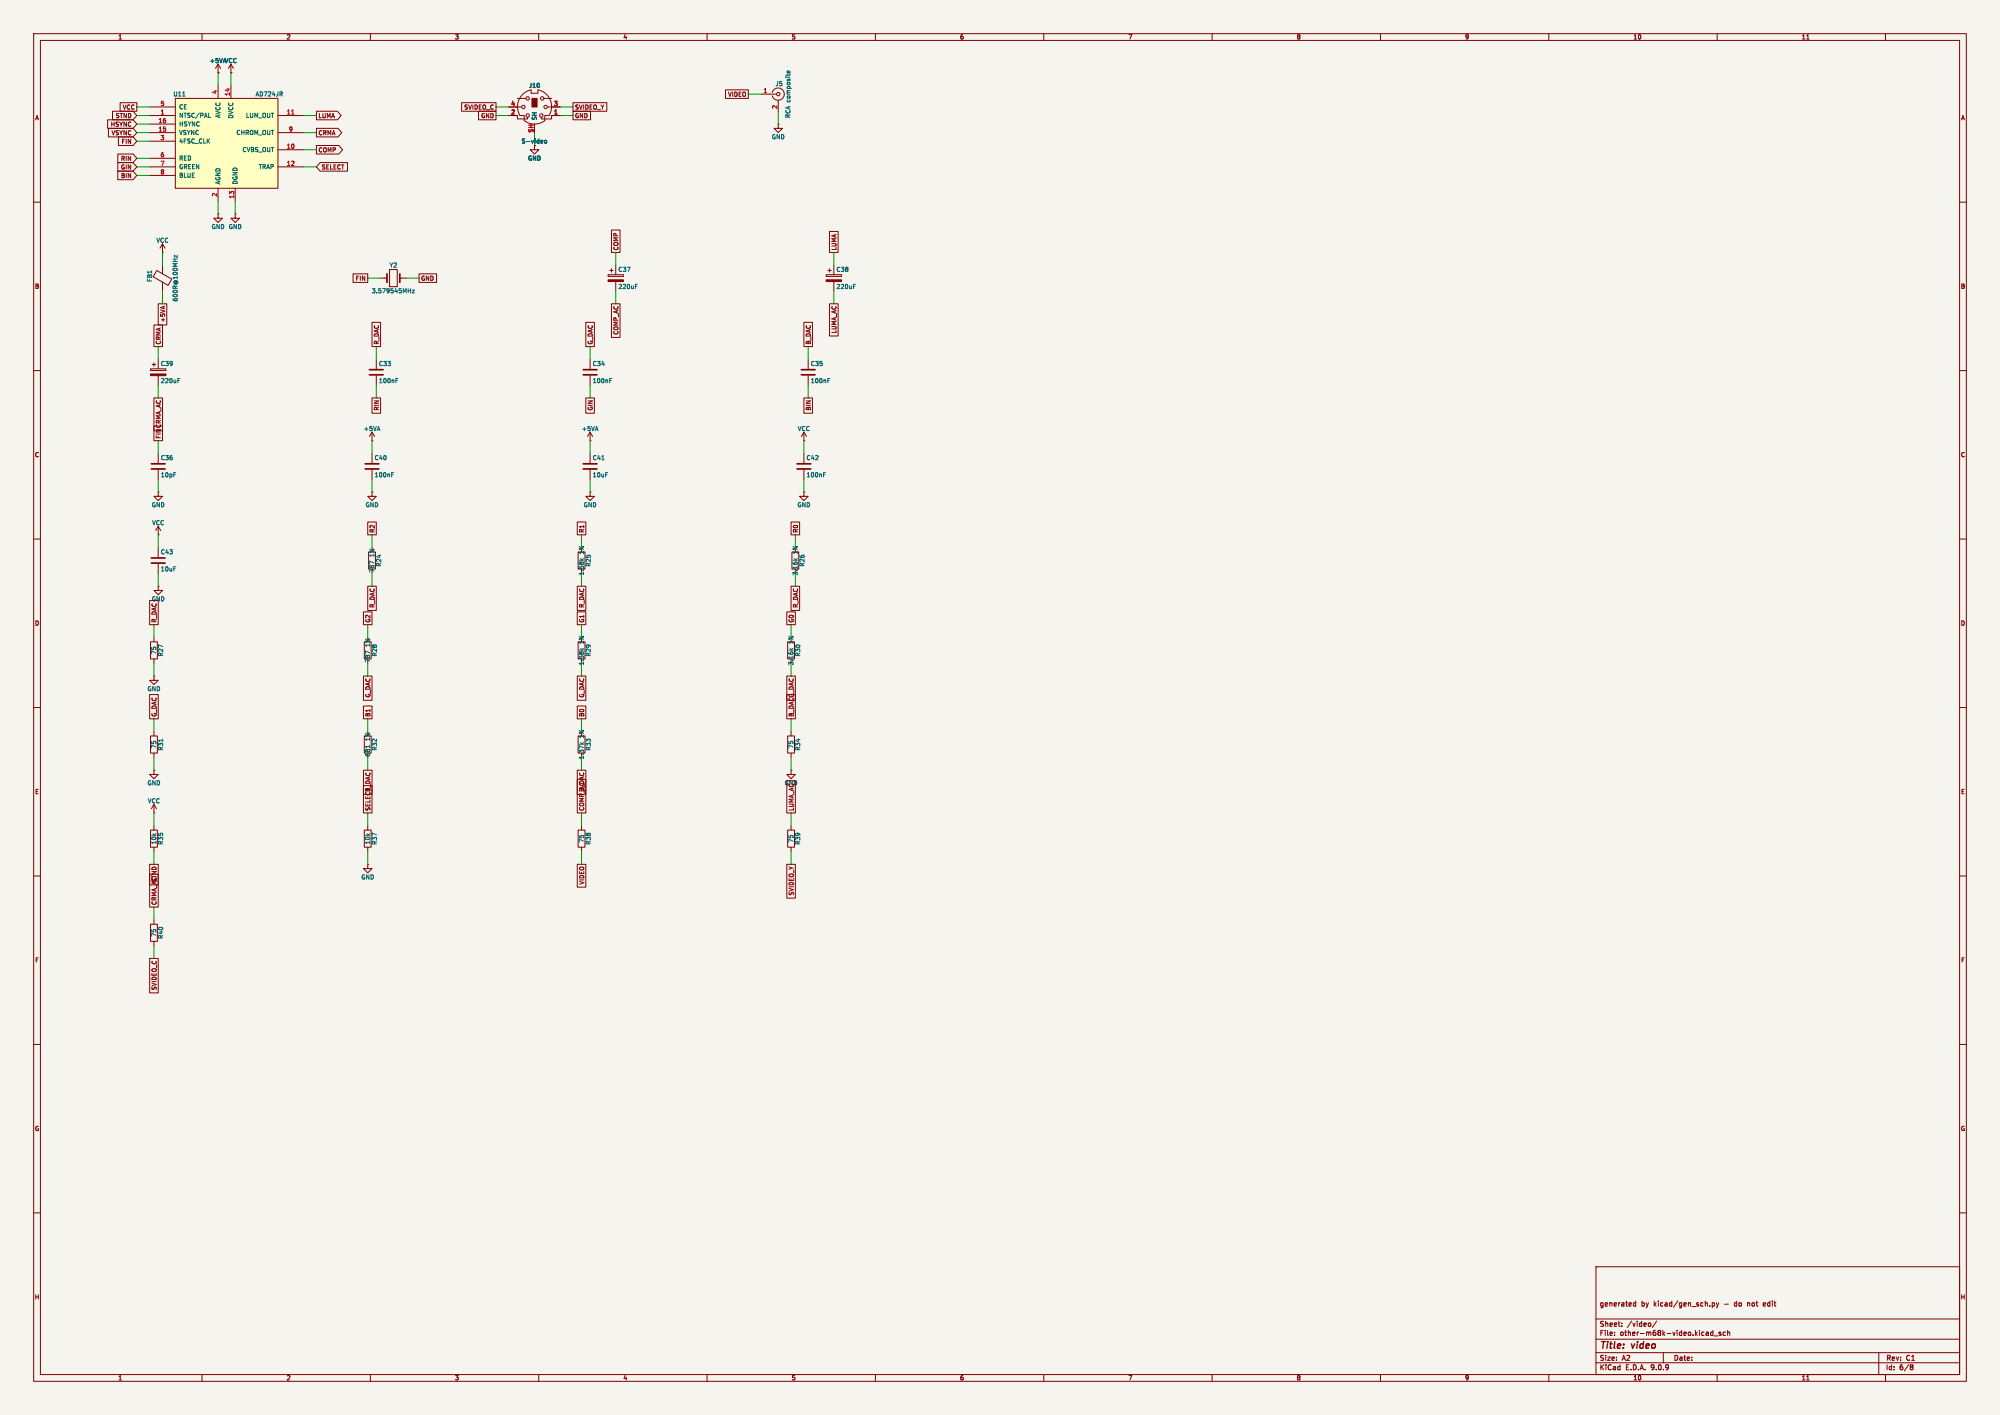
[picture p6: page 6]

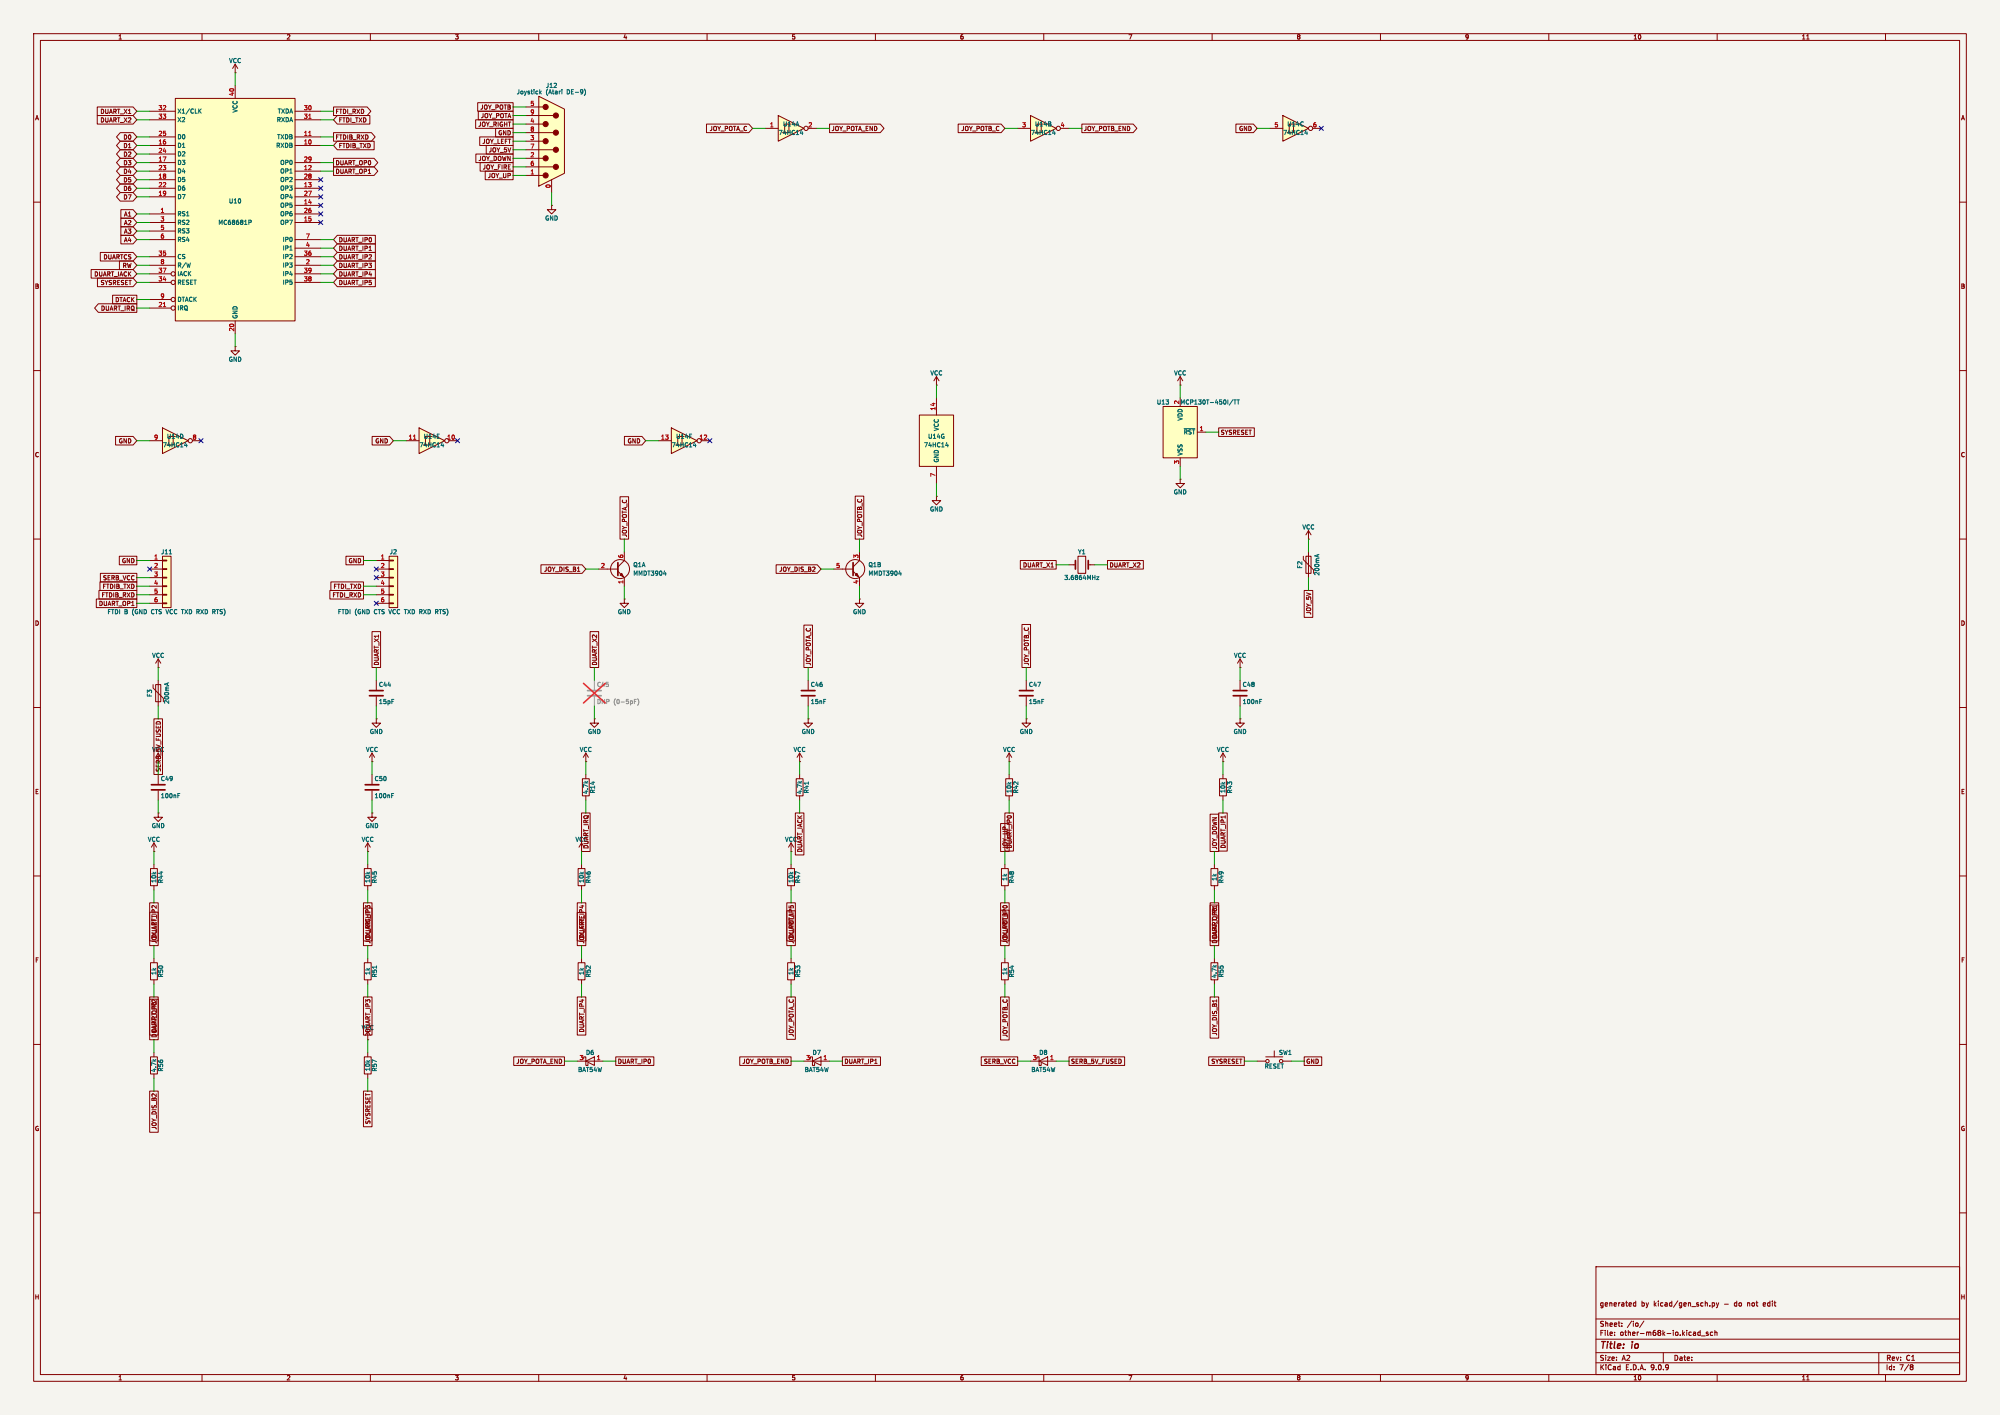
[picture p7: page 7]

J2 FTDI (GND CTS VCC TXD RXD RTS)

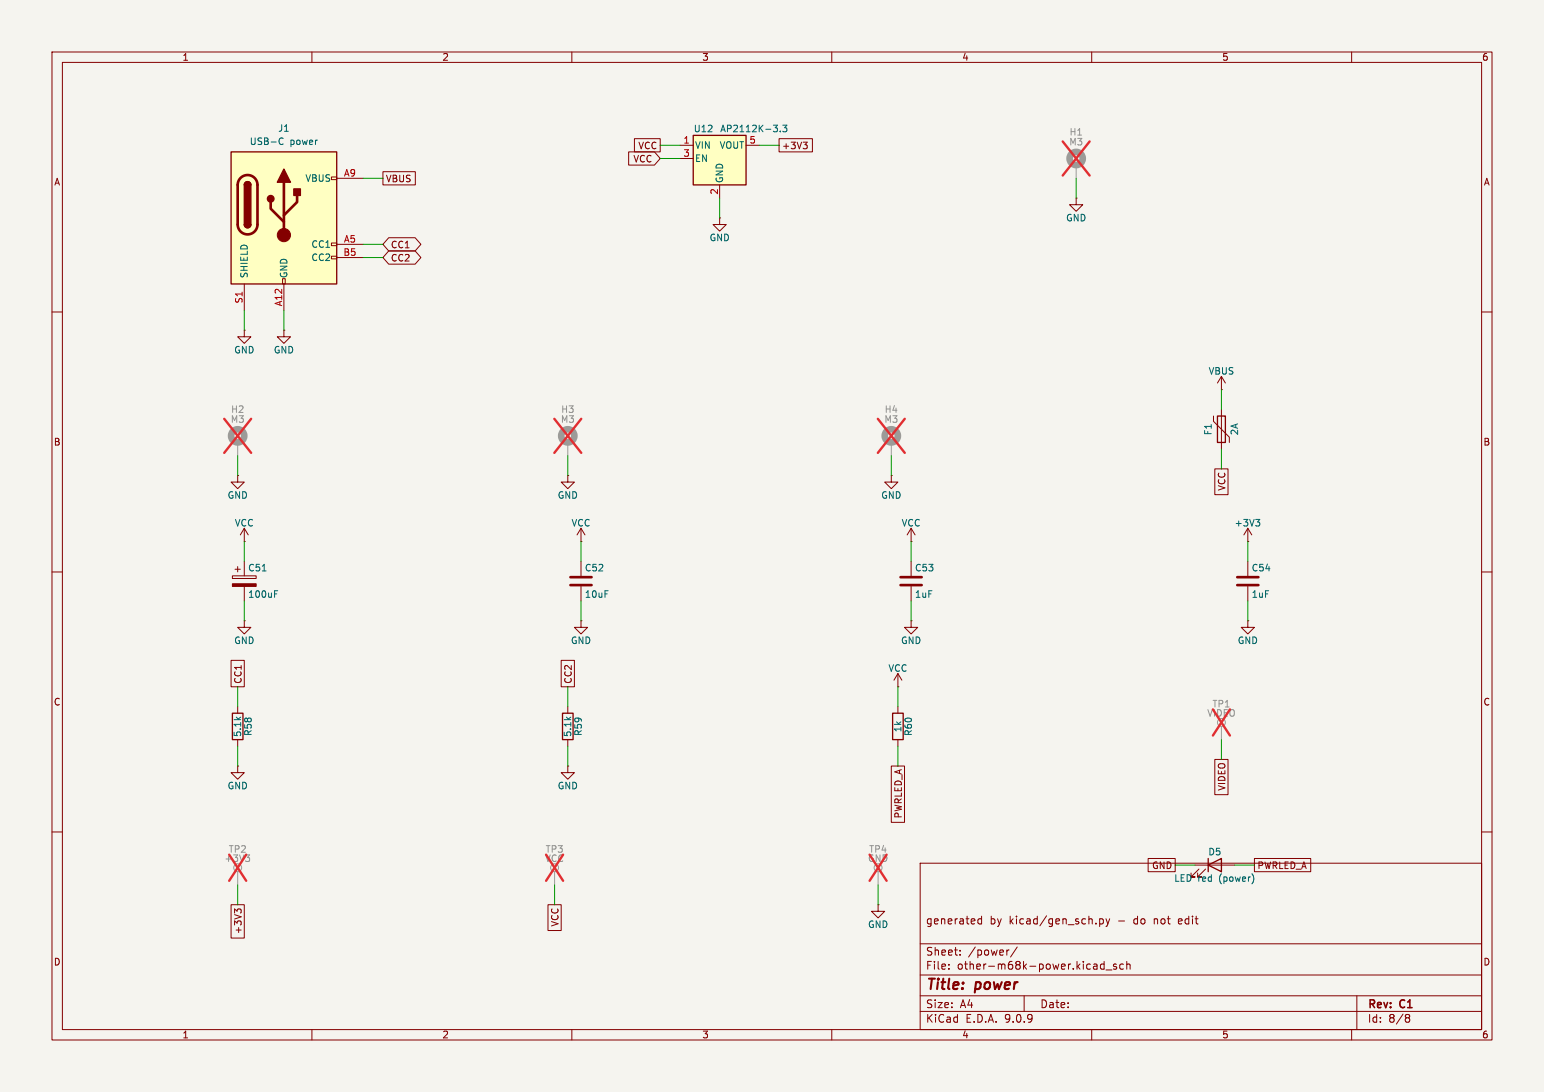
[picture p8: page 8]

Id: 8/8 Title: power File: other-m68k-power.kicad_sch Sheet: /power/
