bradgrantham/other-m68k/kicad/release/other-m68k.kicad_pcb

## KiCad design kicad/release/other-m68k.kicad_pcb (2026-10-23)

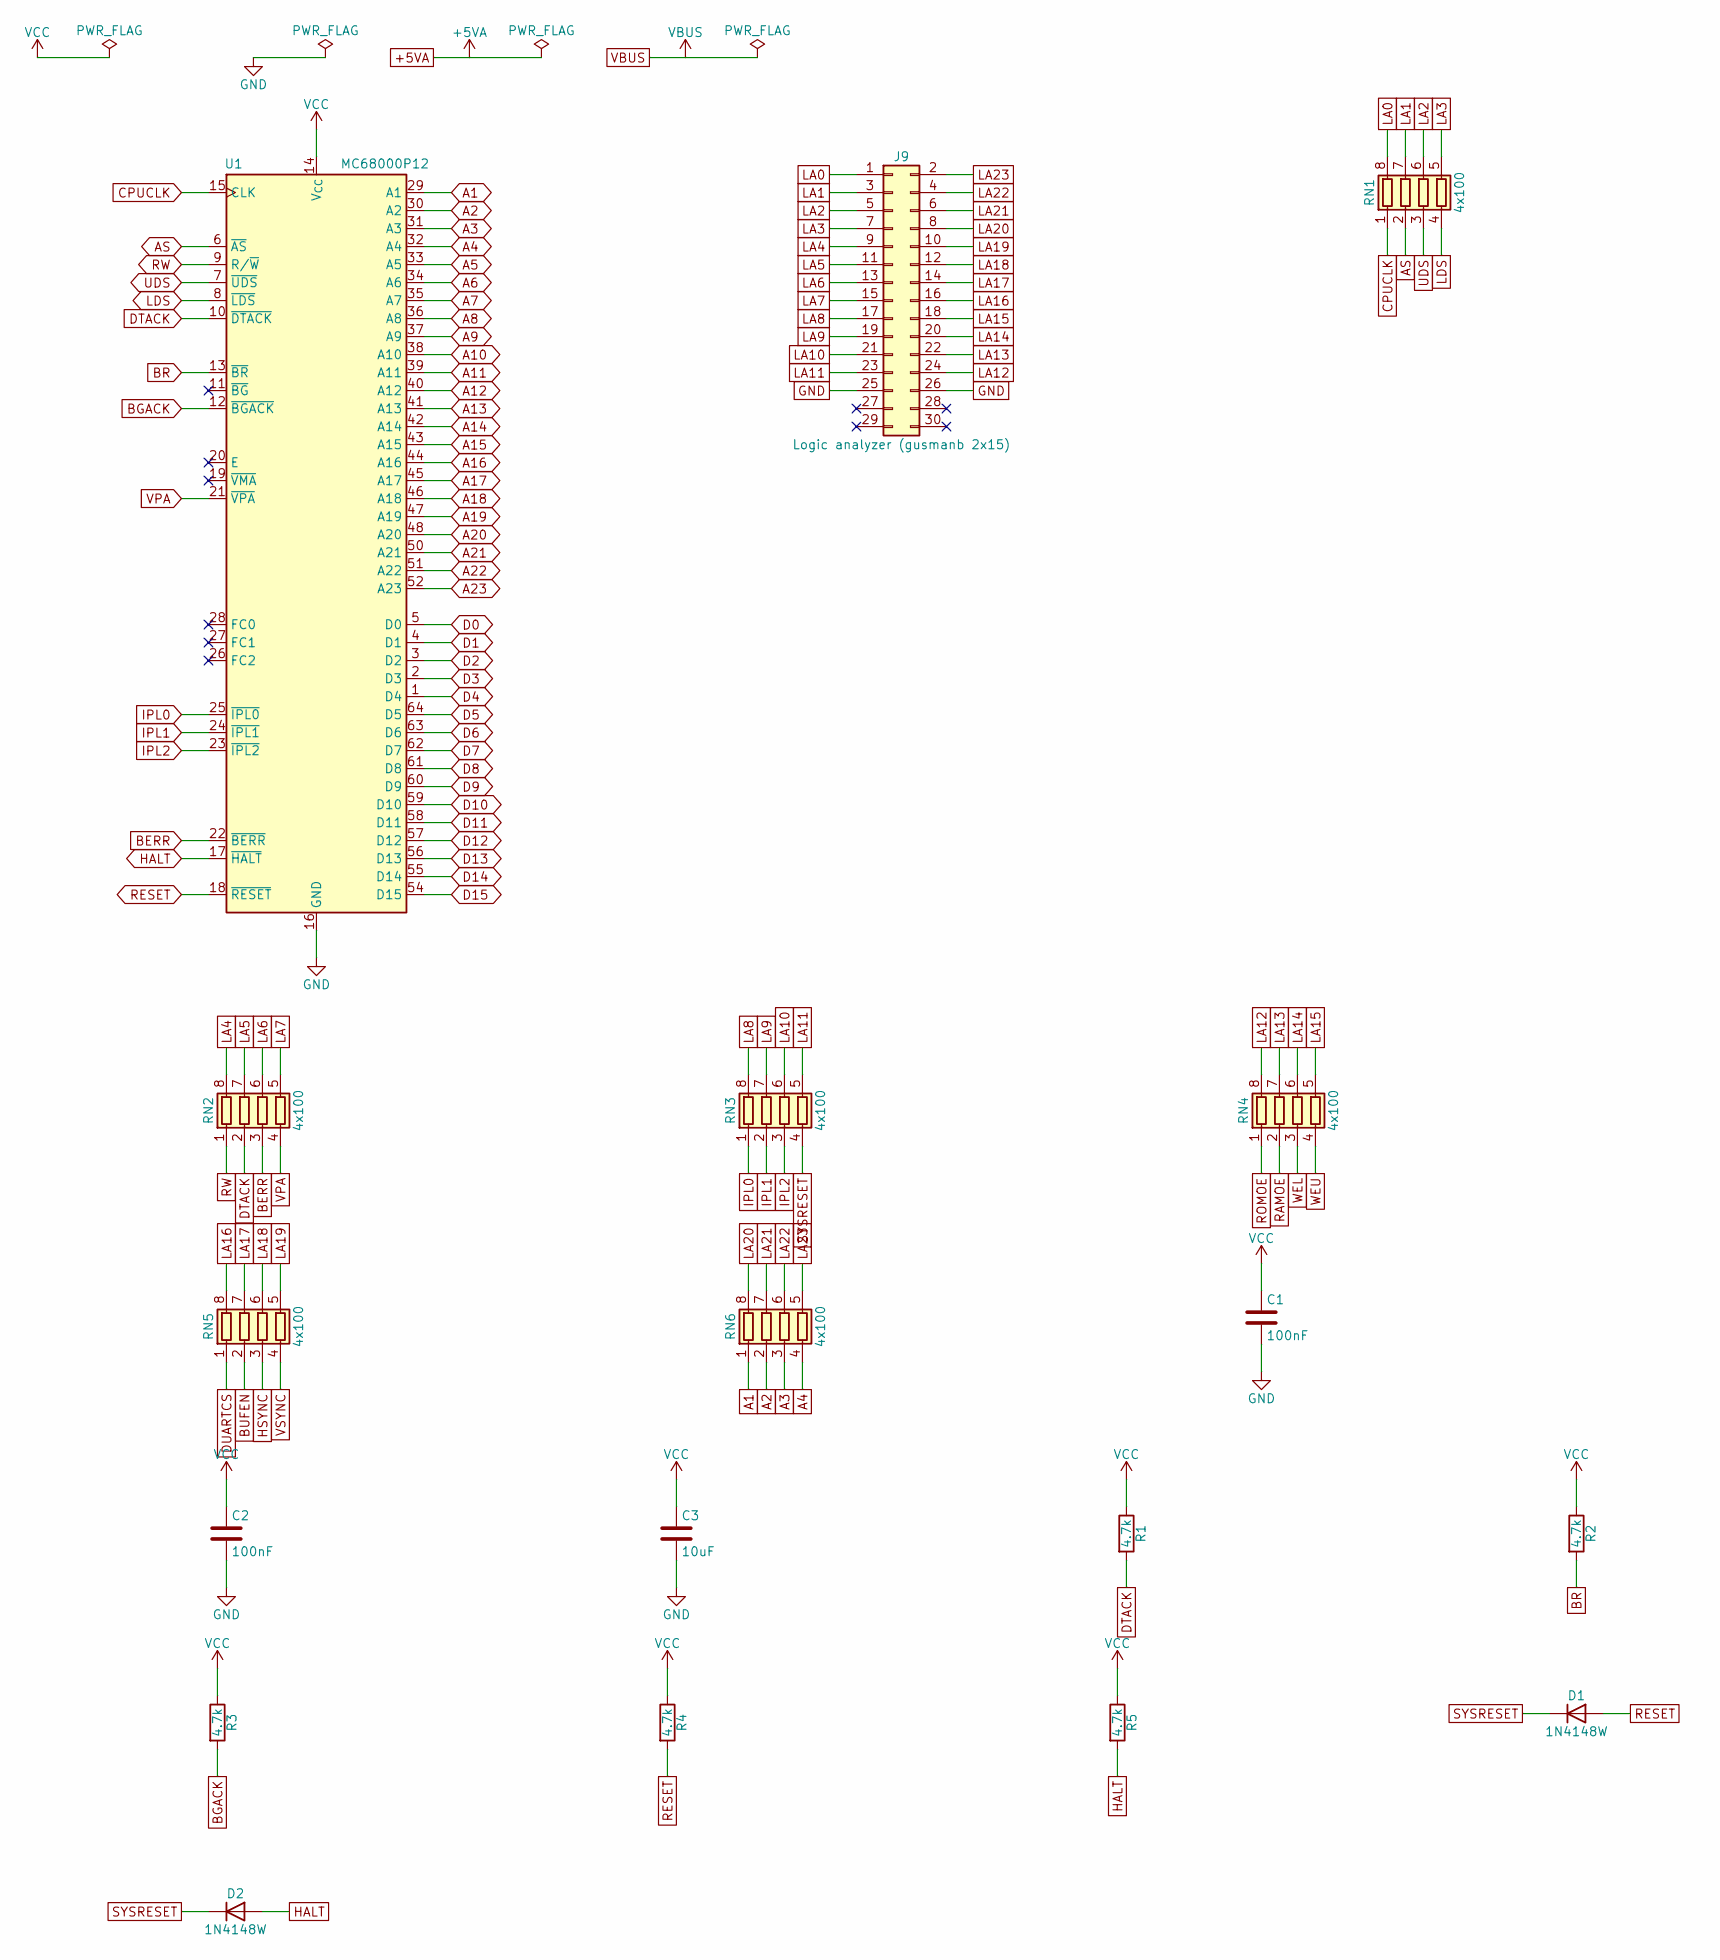
[picture p9: schematic other-m68k-cpu.kicad_sch, cpu]

Parts:
C1, C2: 100nF; C_0603_1608Metric; MPN CL10B104KB8NNNC; LCSC C1591
C3: 10uF; C_0805_2012Metric; MPN CL21A106KAYNNNE; LCSC C15850
D1, D2: 1N4148W; D_SOD-123; MPN 1N4148W-7-F; LCSC C81598
J9: Logic analyzer (gusmanb 2x15); PinHeader_2x15_P2.54mm_Vertical; MPN PRPC015DAAN-RC
R1, R2, R3, R4, R5: 4.7k; R_0603_1608Metric; MPN RC0603FR-074K7L; LCSC C23162
RN1, RN2, RN3, RN4, RN5, RN6: 4x100; R_Array_Convex_4x0603; MPN YC164-JR-07100RL
U1: MC68000P12; DIP-64_W22.86mm_Socket; MPN MC68000P12

Connections:
A1: RN6.1 (R1.1), U1.29 (A1); also elsewhere on the board
A2: RN6.2 (R2.1), U1.30 (A2); also elsewhere on the board
A3: RN6.3 (R3.1), U1.31 (A3); also elsewhere on the board
A4: RN6.4 (R4.1), U1.32 (A4); also elsewhere on the board
A5: U1.33 (A5); also elsewhere on the board
A6: U1.34 (A6); also elsewhere on the board
A7: U1.35 (A7); also elsewhere on the board
A8: U1.36 (A8); also elsewhere on the board
A9: U1.37 (A9); also elsewhere on the board
A10: U1.38 (A10); also elsewhere on the board
A11: U1.39 (A11); also elsewhere on the board
A12: U1.40 (A12); also elsewhere on the board
A13: U1.41 (A13); also elsewhere on the board
A14: U1.42 (A14); also elsewhere on the board
A15: U1.43 (A15); also elsewhere on the board
A16: U1.44 (A16); also elsewhere on the board
A17: U1.45 (A17); also elsewhere on the board
A18: U1.46 (A18); also elsewhere on the board
A19: U1.47 (A19); also elsewhere on the board
A20: U1.48 (A20); also elsewhere on the board
A21: U1.50 (A21); also elsewhere on the board
A22: U1.51 (A22); also elsewhere on the board
A23: U1.52 (A23); also elsewhere on the board
AS: RN1.2 (R2.1), U1.6 (~AS); also elsewhere on the board
BERR: RN2.3 (R3.1), U1.22 (~BERR); also elsewhere on the board
BGACK: R3.2, U1.12 (~BGACK)
BR: R2.2, U1.13 (~BR)
BUFEN: RN5.2 (R2.1); also elsewhere on the board
CPUCLK: RN1.1 (R1.1), U1.15 (CLK); also elsewhere on the board
D0: U1.5 (D0); also elsewhere on the board
D1: U1.4 (D1); also elsewhere on the board
D2: U1.3 (D2); also elsewhere on the board
D3: U1.2 (D3); also elsewhere on the board
D4: U1.1 (D4); also elsewhere on the board
D5: U1.64 (D5); also elsewhere on the board
D6: U1.63 (D6); also elsewhere on the board
D7: U1.62 (D7); also elsewhere on the board
D8: U1.61 (D8); also elsewhere on the board
D9: U1.60 (D9); also elsewhere on the board
D10: U1.59 (D10); also elsewhere on the board
D11: U1.58 (D11); also elsewhere on the board
D12: U1.57 (D12); also elsewhere on the board
D13: U1.56 (D13); also elsewhere on the board
D14: U1.55 (D14); also elsewhere on the board
D15: U1.54 (D15); also elsewhere on the board
DTACK: R1.2, RN2.2 (R2.1), U1.10 (~DTACK); also elsewhere on the board
DUARTCS: RN5.1 (R1.1); also elsewhere on the board
GND: C1.2, C2.2, C3.2, J9.25, J9.26, U1.16 (GND), U1.53 (GND); also elsewhere on the board
HALT: D2.2 (A), R5.2, U1.17 (~HALT)
HSYNC: RN5.3 (R3.1); also elsewhere on the board
IPL0: RN3.1 (R1.1), U1.25 (~IPL0); also elsewhere on the board
IPL1: RN3.2 (R2.1), U1.24 (~IPL1); also elsewhere on the board
IPL2: RN3.3 (R3.1), U1.23 (~IPL2); also elsewhere on the board
LA0: J9.1, RN1.8 (R1.2)
LA1: J9.3, RN1.7 (R2.2)
LA2: J9.5, RN1.6 (R3.2)
LA3: J9.7, RN1.5 (R4.2)
LA4: J9.9, RN2.8 (R1.2)
LA5: J9.11, RN2.7 (R2.2)
LA6: J9.13, RN2.6 (R3.2)
LA7: J9.15, RN2.5 (R4.2)
LA8: J9.17, RN3.8 (R1.2)
LA9: J9.19, RN3.7 (R2.2)
LA10: J9.21, RN3.6 (R3.2)
LA11: J9.23, RN3.5 (R4.2)
LA12: J9.24, RN4.8 (R1.2)
LA13: J9.22, RN4.7 (R2.2)
LA14: J9.20, RN4.6 (R3.2)
LA15: J9.18, RN4.5 (R4.2)
LA16: J9.16, RN5.8 (R1.2)
LA17: J9.14, RN5.7 (R2.2)
LA18: J9.12, RN5.6 (R3.2)
LA19: J9.10, RN5.5 (R4.2)
LA20: J9.8, RN6.8 (R1.2)
LA21: J9.6, RN6.7 (R2.2)
LA22: J9.4, RN6.6 (R3.2)
LA23: J9.2, RN6.5 (R4.2)
LDS: RN1.4 (R4.1), U1.8 (~LDS); also elsewhere on the board
RAMOE: RN4.2 (R2.1); also elsewhere on the board
RESET: D1.2 (A), R4.2, U1.18 (~RESET)
ROMOE: RN4.1 (R1.1); also elsewhere on the board
RW: RN2.1 (R1.1), U1.9 (R/~W); also elsewhere on the board
SYSRESET: D1.1 (K), D2.1 (K), RN3.4 (R4.1); also elsewhere on the board
UDS: RN1.3 (R3.1), U1.7 (~UDS); also elsewhere on the board
VCC: C1.1, C2.1, C3.1, R1.1, R2.1, R3.1, R4.1, R5.1, U1.14 (V_{CC}), U1.49 (V_{CC}); also elsewhere on the board
VPA: RN2.4 (R4.1), U1.21 (~VPA); also elsewhere on the board
VSYNC: RN5.4 (R4.1); also elsewhere on the board
WEL: RN4.3 (R3.1); also elsewhere on the board
WEU: RN4.4 (R4.1); also elsewhere on the board

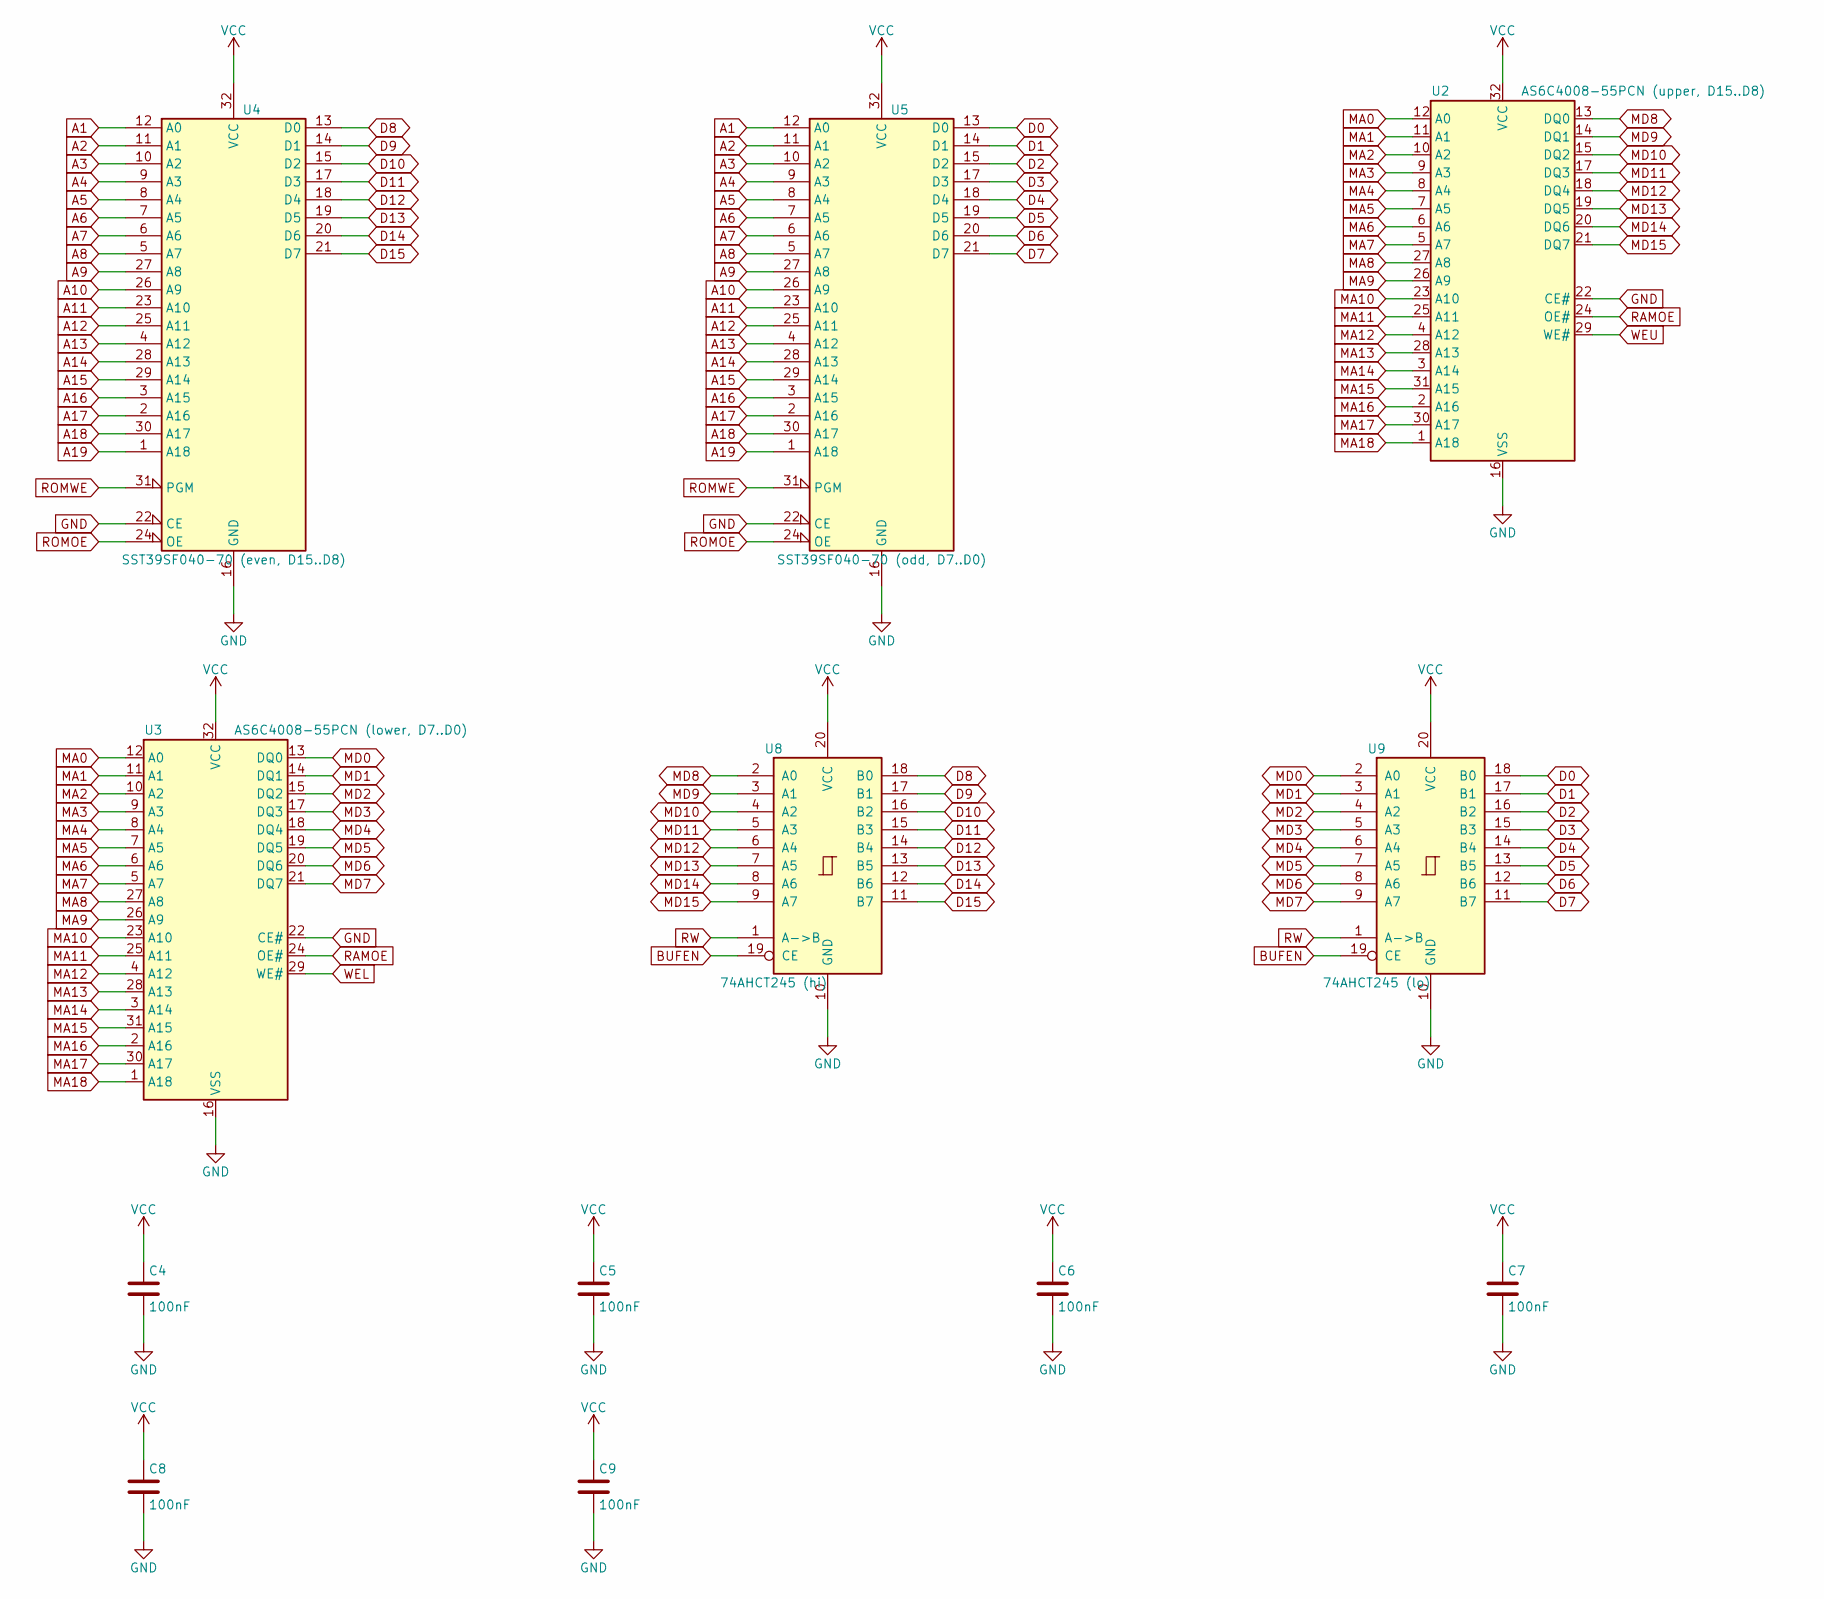
[picture p10: schematic other-m68k-memory.kicad_sch, memory]

Parts:
C4, C5, C6, C7, C8, C9: 100nF; C_0603_1608Metric; MPN CL10B104KB8NNNC; LCSC C1591
U2: AS6C4008-55PCN (upper, D15..D8); DIP-32_W15.24mm_Socket; MPN AS6C4008-55PCN
U3: AS6C4008-55PCN (lower, D7..D0); DIP-32_W15.24mm_Socket; MPN AS6C4008-55PCN
U4: SST39SF040-70 (even, D15..D8); DIP-32_W15.24mm_Socket; MPN SST39SF040-70-4C-PHE
U5: SST39SF040-70 (odd, D7..D0); DIP-32_W15.24mm_Socket; MPN SST39SF040-70-4C-PHE
U8: 74AHCT245 (hi); SOIC-20W_7.5x12.8mm_P1.27mm; MPN SN74AHCT245DW
U9: 74AHCT245 (lo); SOIC-20W_7.5x12.8mm_P1.27mm; MPN SN74AHCT245DW

Connections:
A1: U4.12 (A0), U5.12 (A0); also elsewhere on the board
A2: U4.11 (A1), U5.11 (A1); also elsewhere on the board
A3: U4.10 (A2), U5.10 (A2); also elsewhere on the board
A4: U4.9 (A3), U5.9 (A3); also elsewhere on the board
A5: U4.8 (A4), U5.8 (A4); also elsewhere on the board
A6: U4.7 (A5), U5.7 (A5); also elsewhere on the board
A7: U4.6 (A6), U5.6 (A6); also elsewhere on the board
A8: U4.5 (A7), U5.5 (A7); also elsewhere on the board
A9: U4.27 (A8), U5.27 (A8); also elsewhere on the board
A10: U4.26 (A9), U5.26 (A9); also elsewhere on the board
A11: U4.23 (A10), U5.23 (A10); also elsewhere on the board
A12: U4.25 (A11), U5.25 (A11); also elsewhere on the board
A13: U4.4 (A12), U5.4 (A12); also elsewhere on the board
A14: U4.28 (A13), U5.28 (A13); also elsewhere on the board
A15: U4.29 (A14), U5.29 (A14); also elsewhere on the board
A16: U4.3 (A15), U5.3 (A15); also elsewhere on the board
A17: U4.2 (A16), U5.2 (A16); also elsewhere on the board
A18: U4.30 (A17), U5.30 (A17); also elsewhere on the board
A19: U4.1 (A18), U5.1 (A18); also elsewhere on the board
BUFEN: U8.19 (CE), U9.19 (CE); also elsewhere on the board
D0: U5.13 (D0), U9.18 (B0); also elsewhere on the board
D1: U5.14 (D1), U9.17 (B1); also elsewhere on the board
D2: U5.15 (D2), U9.16 (B2); also elsewhere on the board
D3: U5.17 (D3), U9.15 (B3); also elsewhere on the board
D4: U5.18 (D4), U9.14 (B4); also elsewhere on the board
D5: U5.19 (D5), U9.13 (B5); also elsewhere on the board
D6: U5.20 (D6), U9.12 (B6); also elsewhere on the board
D7: U5.21 (D7), U9.11 (B7); also elsewhere on the board
D8: U4.13 (D0), U8.18 (B0); also elsewhere on the board
D9: U4.14 (D1), U8.17 (B1); also elsewhere on the board
D10: U4.15 (D2), U8.16 (B2); also elsewhere on the board
D11: U4.17 (D3), U8.15 (B3); also elsewhere on the board
D12: U4.18 (D4), U8.14 (B4); also elsewhere on the board
D13: U4.19 (D5), U8.13 (B5); also elsewhere on the board
D14: U4.20 (D6), U8.12 (B6); also elsewhere on the board
D15: U4.21 (D7), U8.11 (B7); also elsewhere on the board
GND: C4.2, C5.2, C6.2, C7.2, C8.2, C9.2, U2.16 (VSS), U2.22 (CE#), U3.16 (VSS), U3.22 (CE#), U4.16 (GND), U4.22 (CE), U5.16 (GND), U5.22 (CE), U8.10 (GND), U9.10 (GND); also elsewhere on the board
MA0: U2.12 (A0), U3.12 (A0); also elsewhere on the board
MA1: U2.11 (A1), U3.11 (A1); also elsewhere on the board
MA2: U2.10 (A2), U3.10 (A2); also elsewhere on the board
MA3: U2.9 (A3), U3.9 (A3); also elsewhere on the board
MA4: U2.8 (A4), U3.8 (A4); also elsewhere on the board
MA5: U2.7 (A5), U3.7 (A5); also elsewhere on the board
MA6: U2.6 (A6), U3.6 (A6); also elsewhere on the board
MA7: U2.5 (A7), U3.5 (A7); also elsewhere on the board
MA8: U2.27 (A8), U3.27 (A8); also elsewhere on the board
MA9: U2.26 (A9), U3.26 (A9); also elsewhere on the board
MA10: U2.23 (A10), U3.23 (A10); also elsewhere on the board
MA11: U2.25 (A11), U3.25 (A11); also elsewhere on the board
MA12: U2.4 (A12), U3.4 (A12); also elsewhere on the board
MA13: U2.28 (A13), U3.28 (A13); also elsewhere on the board
MA14: U2.3 (A14), U3.3 (A14); also elsewhere on the board
MA15: U2.31 (A15), U3.31 (A15); also elsewhere on the board
MA16: U2.2 (A16), U3.2 (A16); also elsewhere on the board
MA17: U2.30 (A17), U3.30 (A17); also elsewhere on the board
MA18: U2.1 (A18), U3.1 (A18); also elsewhere on the board
MD0: U3.13 (DQ0), U9.2 (A0); also elsewhere on the board
MD1: U3.14 (DQ1), U9.3 (A1); also elsewhere on the board
MD2: U3.15 (DQ2), U9.4 (A2); also elsewhere on the board
MD3: U3.17 (DQ3), U9.5 (A3); also elsewhere on the board
MD4: U3.18 (DQ4), U9.6 (A4); also elsewhere on the board
MD5: U3.19 (DQ5), U9.7 (A5); also elsewhere on the board
MD6: U3.20 (DQ6), U9.8 (A6); also elsewhere on the board
MD7: U3.21 (DQ7), U9.9 (A7); also elsewhere on the board
MD8: U2.13 (DQ0), U8.2 (A0); also elsewhere on the board
MD9: U2.14 (DQ1), U8.3 (A1); also elsewhere on the board
MD10: U2.15 (DQ2), U8.4 (A2); also elsewhere on the board
MD11: U2.17 (DQ3), U8.5 (A3); also elsewhere on the board
MD12: U2.18 (DQ4), U8.6 (A4); also elsewhere on the board
MD13: U2.19 (DQ5), U8.7 (A5); also elsewhere on the board
MD14: U2.20 (DQ6), U8.8 (A6); also elsewhere on the board
MD15: U2.21 (DQ7), U8.9 (A7); also elsewhere on the board
RAMOE: U2.24 (OE#), U3.24 (OE#); also elsewhere on the board
ROMOE: U4.24 (OE), U5.24 (OE); also elsewhere on the board
ROMWE: U4.31 (PGM), U5.31 (PGM); also elsewhere on the board
RW: U8.1 (A->B), U9.1 (A->B); also elsewhere on the board
VCC: C4.1, C5.1, C6.1, C7.1, C8.1, C9.1, U2.32 (VCC), U3.32 (VCC), U4.32 (VCC), U5.32 (VCC), U8.20 (VCC), U9.20 (VCC); also elsewhere on the board
WEL: U3.29 (WE#); also elsewhere on the board
WEU: U2.29 (WE#); also elsewhere on the board

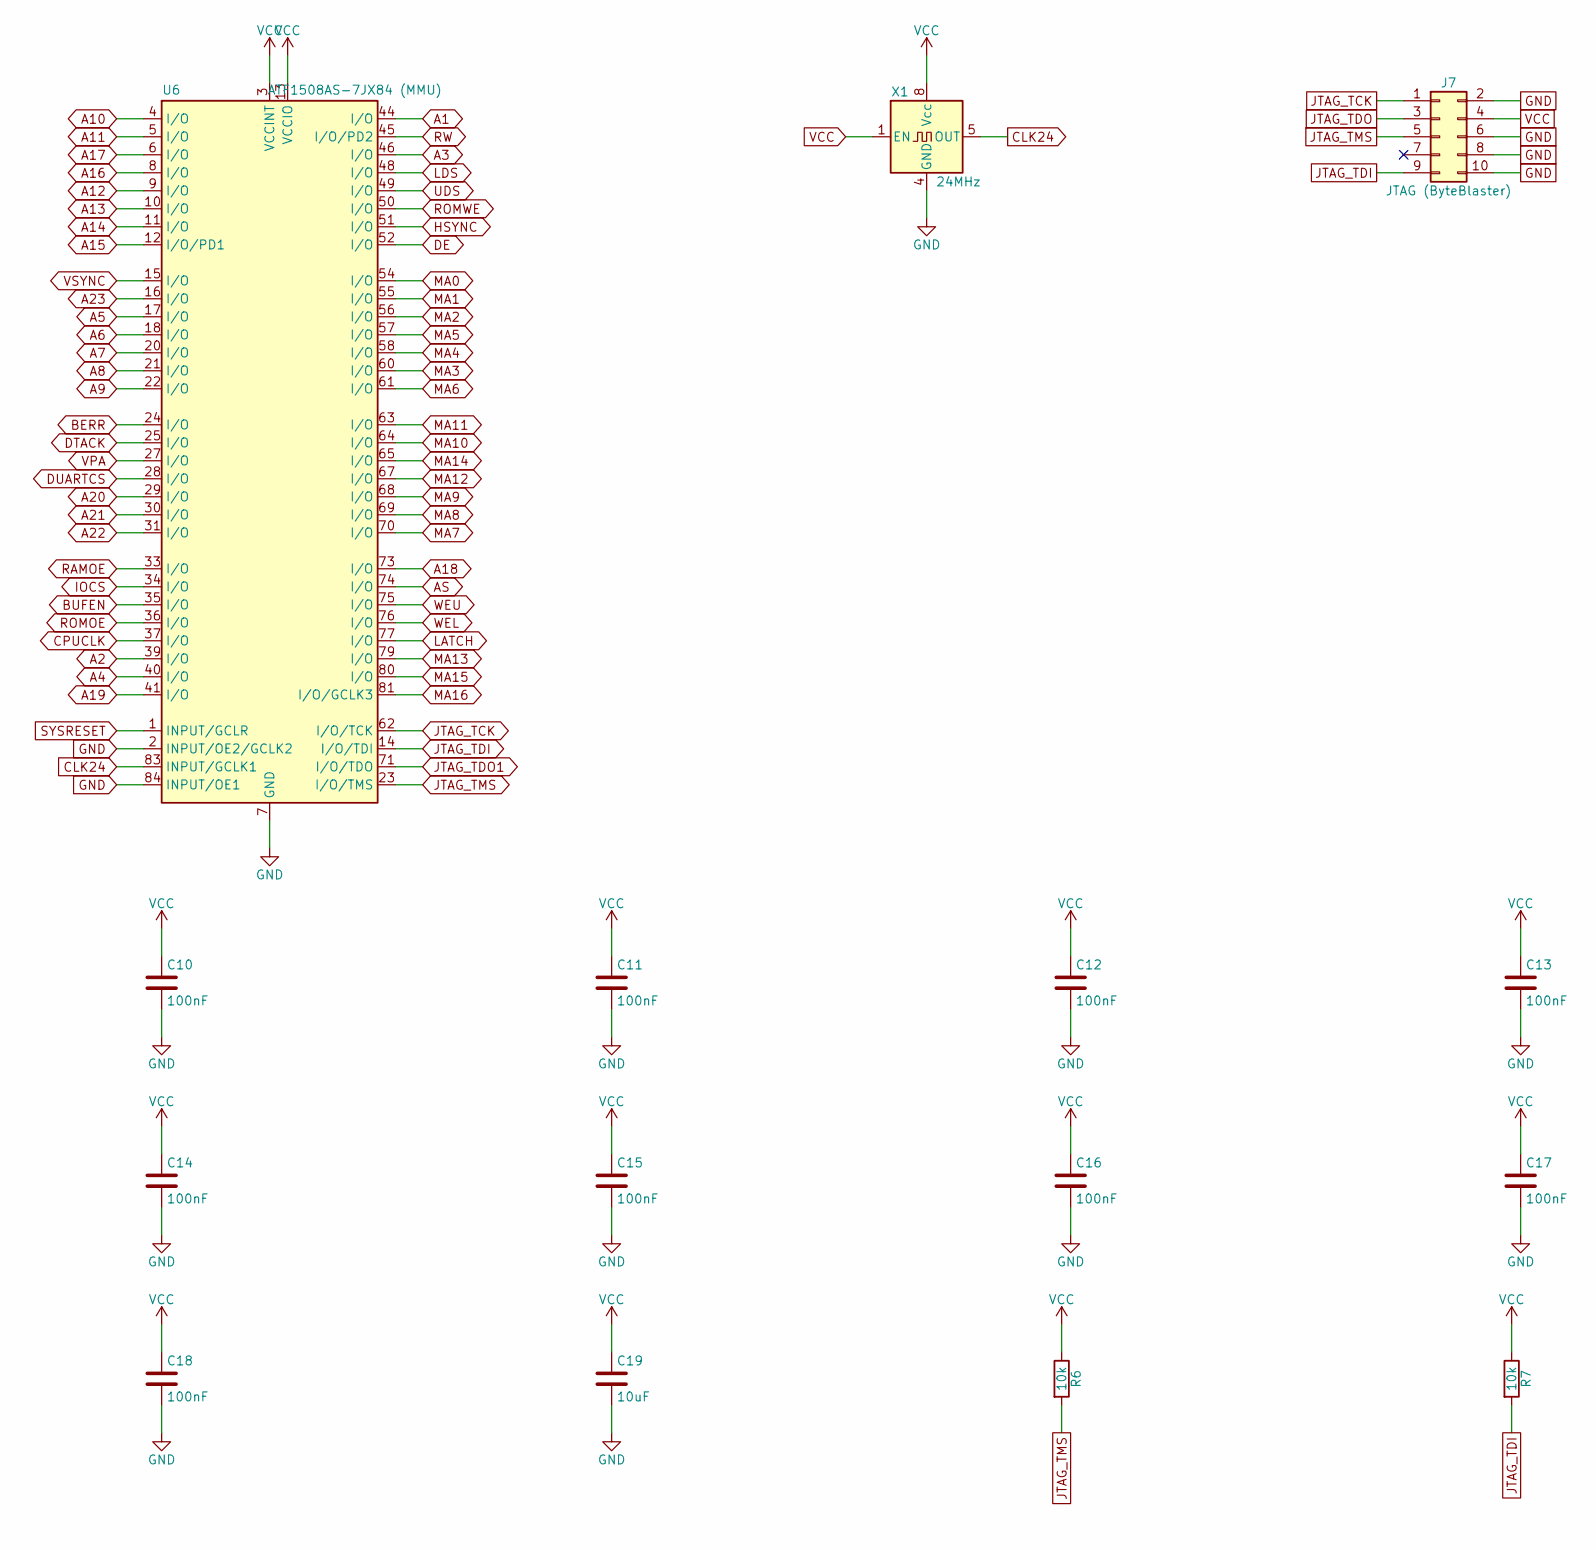
[picture p11: schematic other-m68k-cpld1.kicad_sch, cpld1]

Parts:
C10, C11, C12, C13, C14, C15, C16, C17, C18: 100nF; C_0603_1608Metric; MPN CL10B104KB8NNNC; LCSC C1591
C19: 10uF; C_0805_2012Metric; MPN CL21A106KAYNNNE; LCSC C15850
J7: JTAG (ByteBlaster); PinHeader_2x05_P2.54mm_Vertical; MPN PRPC005DAAN-RC
R6, R7: 10k; R_0603_1608Metric; MPN RC0603FR-0710KL; LCSC C25804
U6: ATF1508AS-7JX84 (MMU); PLCC-84_THT-Socket; MPN ATF1508AS-7JX84
X1: 24MHz; Oscillator_DIP-8; MPN ECS-2200B-240

Connections:
A1: U6.44 (I/O); also elsewhere on the board
A2: U6.39 (I/O); also elsewhere on the board
A3: U6.46 (I/O); also elsewhere on the board
A4: U6.40 (I/O); also elsewhere on the board
A5: U6.17 (I/O); also elsewhere on the board
A6: U6.18 (I/O); also elsewhere on the board
A7: U6.20 (I/O); also elsewhere on the board
A8: U6.21 (I/O); also elsewhere on the board
A9: U6.22 (I/O); also elsewhere on the board
A10: U6.4 (I/O); also elsewhere on the board
A11: U6.5 (I/O); also elsewhere on the board
A12: U6.9 (I/O); also elsewhere on the board
A13: U6.10 (I/O); also elsewhere on the board
A14: U6.11 (I/O); also elsewhere on the board
A15: U6.12 (I/O/PD1); also elsewhere on the board
A16: U6.8 (I/O); also elsewhere on the board
A17: U6.6 (I/O); also elsewhere on the board
A18: U6.73 (I/O); also elsewhere on the board
A19: U6.41 (I/O); also elsewhere on the board
A20: U6.29 (I/O); also elsewhere on the board
A21: U6.30 (I/O); also elsewhere on the board
A22: U6.31 (I/O); also elsewhere on the board
A23: U6.16 (I/O); also elsewhere on the board
AS: U6.74 (I/O); also elsewhere on the board
BERR: U6.24 (I/O); also elsewhere on the board
BUFEN: U6.35 (I/O); also elsewhere on the board
CLK24: U6.83 (INPUT/GCLK1), X1.5 (OUT); also elsewhere on the board
CPUCLK: U6.37 (I/O); also elsewhere on the board
DE: U6.52 (I/O); also elsewhere on the board
DTACK: U6.25 (I/O); also elsewhere on the board
DUARTCS: U6.28 (I/O); also elsewhere on the board
GND: C10.2, C11.2, C12.2, C13.2, C14.2, C15.2, C16.2, C17.2, C18.2, C19.2, J7.2, J7.6, J7.8, J7.10, U6.2 (INPUT/OE2/GCLK2), U6.7 (GND), U6.19 (GND), U6.32 (GND), U6.42 (GND), U6.47 (GND), U6.59 (GND), U6.72 (GND), U6.82 (GND), U6.84 (INPUT/OE1), X1.4 (GND); also elsewhere on the board
HSYNC: U6.51 (I/O); also elsewhere on the board
IOCS: U6.34 (I/O); also elsewhere on the board
JTAG_TCK: J7.1, U6.62 (I/O/TCK); also elsewhere on the board
JTAG_TDI: J7.9, R7.2, U6.14 (I/O/TDI)
JTAG_TDO: J7.3; also elsewhere on the board
JTAG_TDO1: U6.71 (I/O/TDO); also elsewhere on the board
JTAG_TMS: J7.5, R6.2, U6.23 (I/O/TMS); also elsewhere on the board
LATCH: U6.77 (I/O); also elsewhere on the board
LDS: U6.48 (I/O); also elsewhere on the board
MA0: U6.54 (I/O); also elsewhere on the board
MA1: U6.55 (I/O); also elsewhere on the board
MA2: U6.56 (I/O); also elsewhere on the board
MA3: U6.60 (I/O); also elsewhere on the board
MA4: U6.58 (I/O); also elsewhere on the board
MA5: U6.57 (I/O); also elsewhere on the board
MA6: U6.61 (I/O); also elsewhere on the board
MA7: U6.70 (I/O); also elsewhere on the board
MA8: U6.69 (I/O); also elsewhere on the board
MA9: U6.68 (I/O); also elsewhere on the board
MA10: U6.64 (I/O); also elsewhere on the board
MA11: U6.63 (I/O); also elsewhere on the board
MA12: U6.67 (I/O); also elsewhere on the board
MA13: U6.79 (I/O); also elsewhere on the board
MA14: U6.65 (I/O); also elsewhere on the board
MA15: U6.80 (I/O); also elsewhere on the board
MA16: U6.81 (I/O/GCLK3); also elsewhere on the board
RAMOE: U6.33 (I/O); also elsewhere on the board
ROMOE: U6.36 (I/O); also elsewhere on the board
ROMWE: U6.50 (I/O); also elsewhere on the board
RW: U6.45 (I/O/PD2); also elsewhere on the board
SYSRESET: U6.1 (INPUT/GCLR); also elsewhere on the board
UDS: U6.49 (I/O); also elsewhere on the board
VCC: C10.1, C11.1, C12.1, C13.1, C14.1, C15.1, C16.1, C17.1, C18.1, C19.1, J7.4, R6.1, R7.1, U6.3 (VCCINT), U6.13 (VCCIO), U6.26 (VCCIO), U6.38 (VCCIO), U6.43 (VCCINT), U6.53 (VCCIO), U6.66 (VCCIO), U6.78 (VCCIO), X1.1 (EN), X1.8 (Vcc); also elsewhere on the board
VPA: U6.27 (I/O); also elsewhere on the board
VSYNC: U6.15 (I/O); also elsewhere on the board
WEL: U6.76 (I/O); also elsewhere on the board
WEU: U6.75 (I/O); also elsewhere on the board
