bradgrantham/other-m68k/kicad/release/other-m68k.kicad_pcb

## KiCad design kicad/release/other-m68k.kicad_pcb (continued)

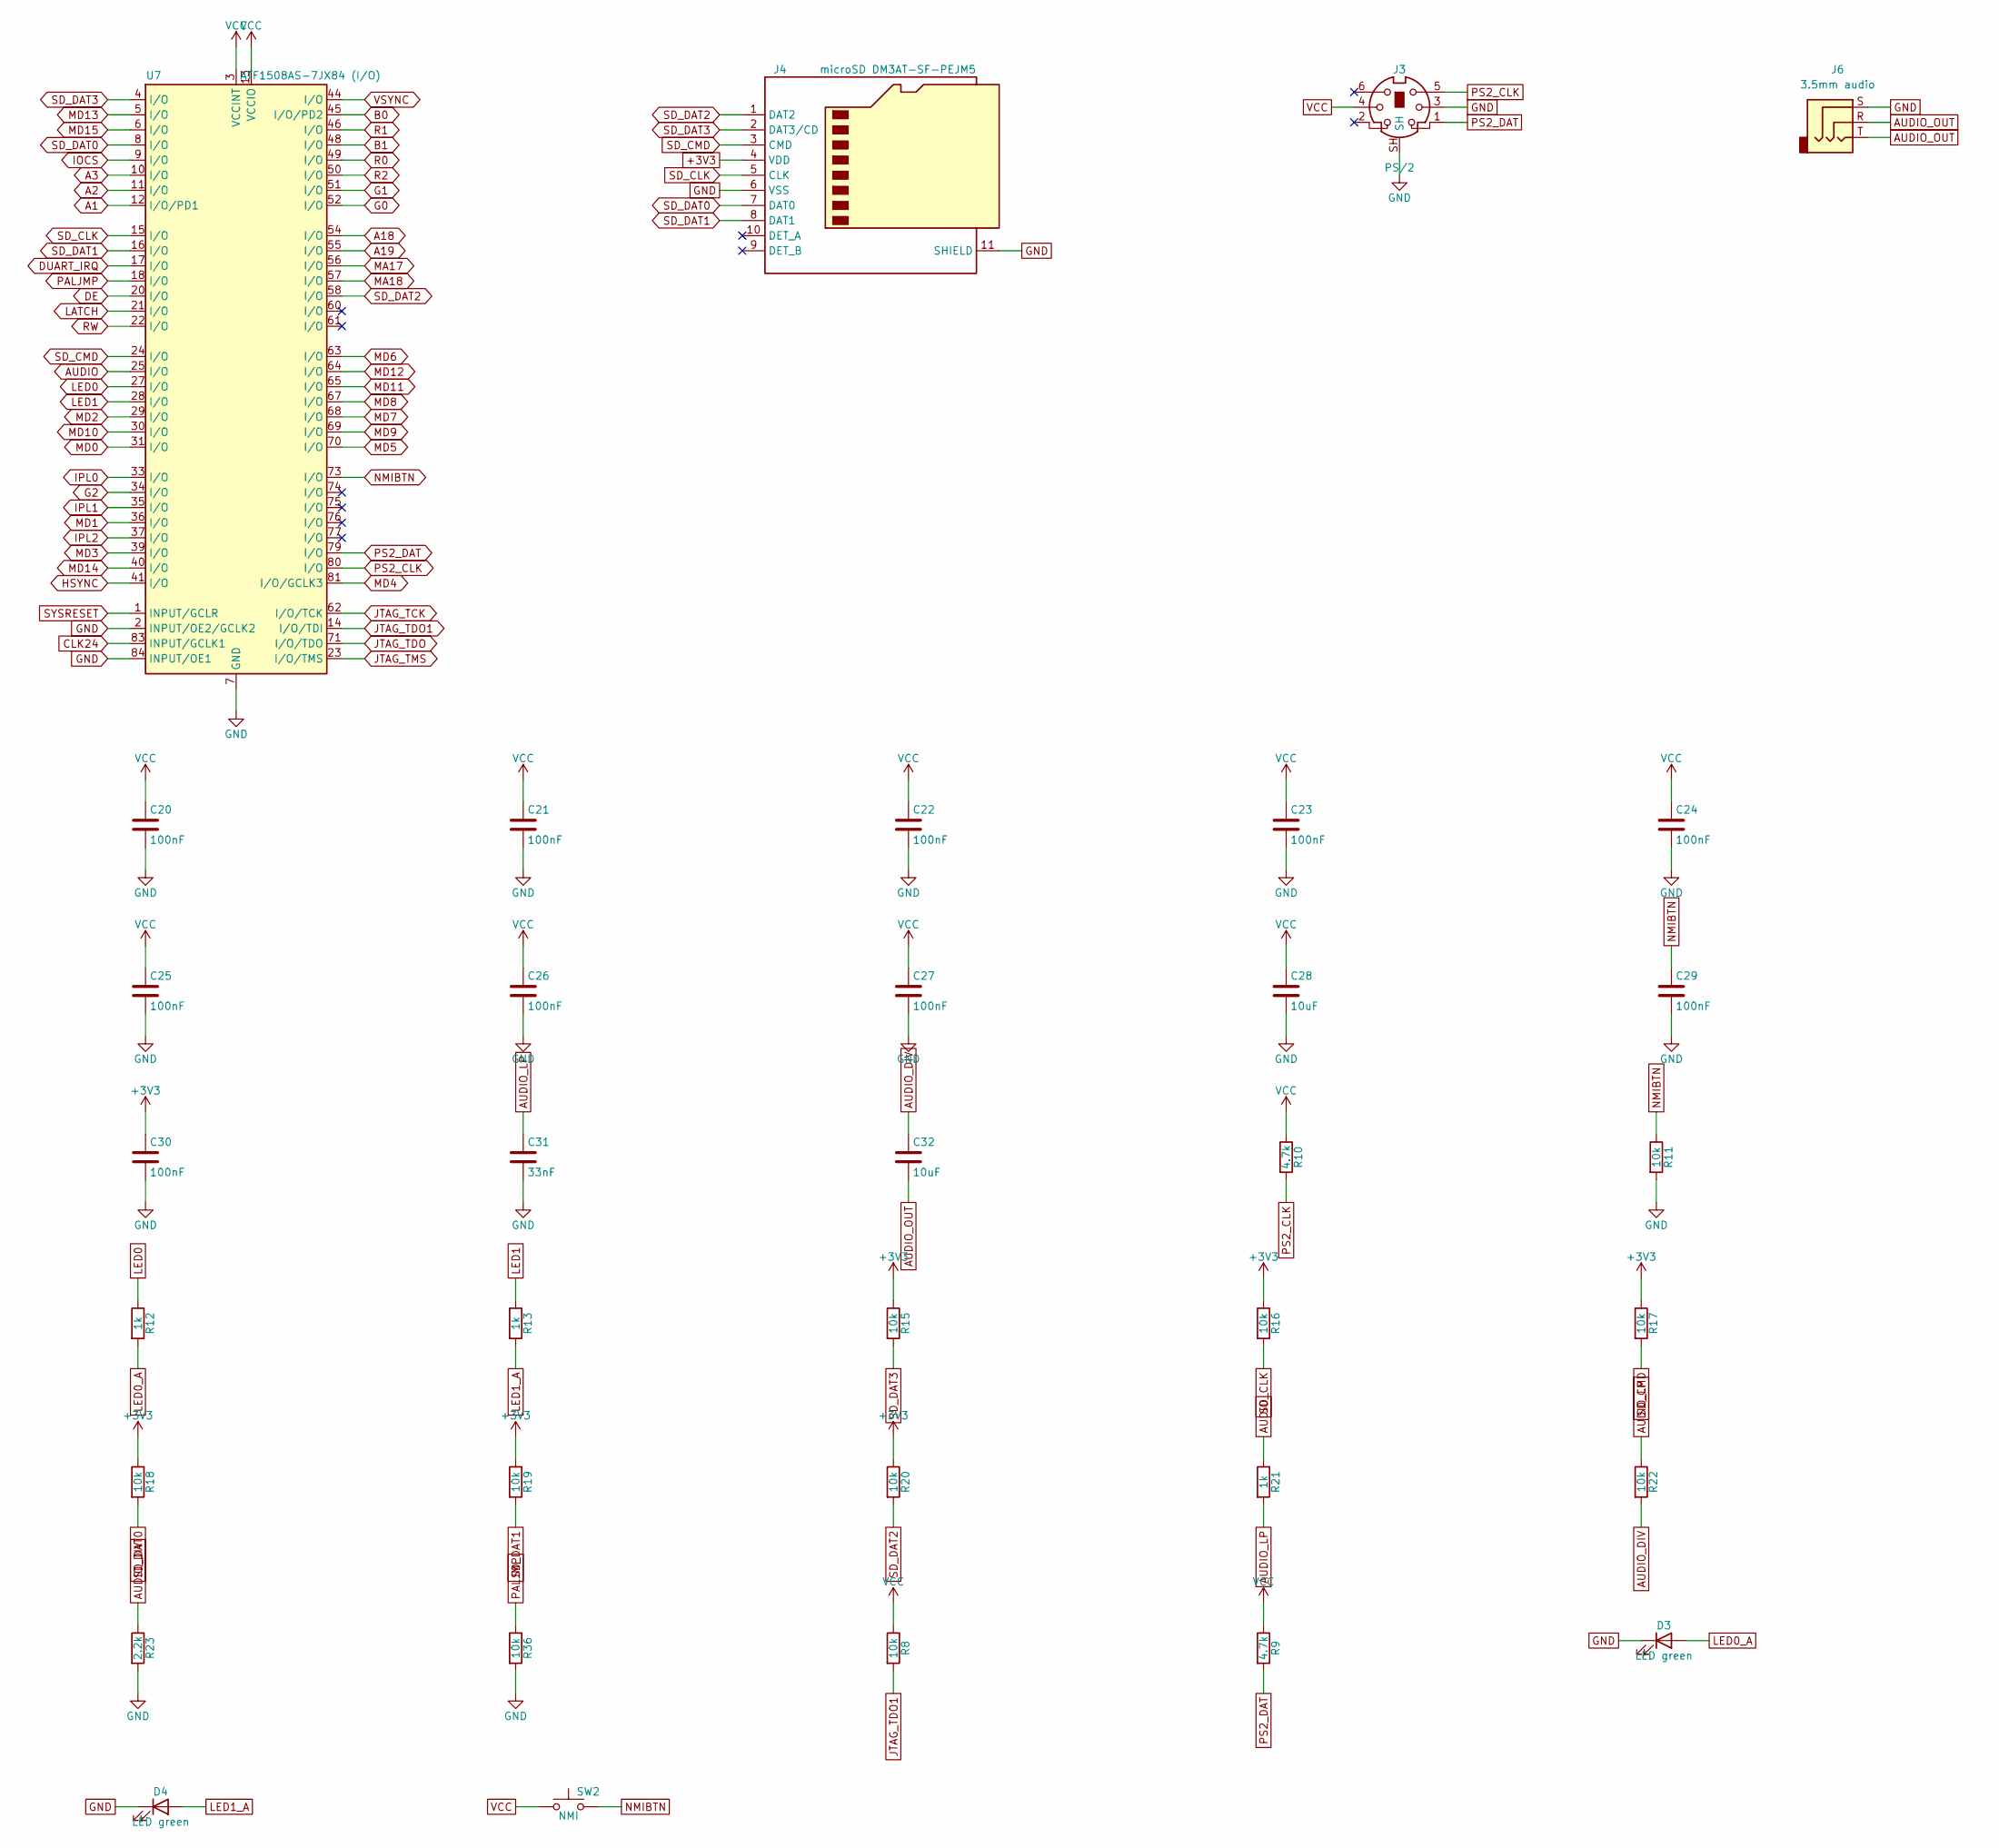
[picture p12: schematic other-m68k-cpld2.kicad_sch, cpld2]

Parts:
C20, C21, C22, C23, C24, C25, C26, C27, C29, C30: 100nF; C_0603_1608Metric; MPN CL10B104KB8NNNC; LCSC C1591
C28, C32: 10uF; C_0805_2012Metric; MPN CL21A106KAYNNNE; LCSC C15850
C31: 33nF; C_0603_1608Metric; MPN CL10B333KB8NFNC; LCSC C307488
D3, D4: LED green; LED_0805_2012Metric; MPN LTST-C171GKT
J3: PS/2; MiniDIN-6_CUI_MD-60SM_Horizontal; MPN MD-60SM
J4: microSD DM3AT-SF-PEJM5; microSD_HC_Hirose_DM3AT-SF-PEJM5; MPN DM3AT-SF-PEJM5
J6: 3.5mm audio; Jack_3.5mm_CUI_SJ1-3523N_Horizontal; MPN SJ1-3523N
R8, R11, R15, R16, R17, R18, R19, R20, R22, R36: 10k; R_0603_1608Metric; MPN RC0603FR-0710KL; LCSC C25804
R9, R10: 4.7k; R_0603_1608Metric; MPN RC0603FR-074K7L; LCSC C23162
R12, R13, R21: 1k; R_0603_1608Metric; MPN RC0603FR-071KL; LCSC C21190
R23: 2.2k; R_0603_1608Metric; MPN RC0603FR-072K2L; LCSC C4190
SW2: NMI; SW_PUSH_6mm; MPN B3F-1000
U7: ATF1508AS-7JX84 (I/O); PLCC-84_THT-Socket; MPN ATF1508AS-7JX84

Connections:
+3V3: C30.1, J4.4 (VDD), R15.1, R16.1, R17.1, R18.1, R19.1, R20.1; also elsewhere on the board
A1: U7.12 (I/O/PD1); also elsewhere on the board
A2: U7.11 (I/O); also elsewhere on the board
A3: U7.10 (I/O); also elsewhere on the board
A18: U7.54 (I/O); also elsewhere on the board
A19: U7.55 (I/O); also elsewhere on the board
AUDIO: R21.1, U7.25 (I/O)
AUDIO_DIV: C32.1, R22.2, R23.1
AUDIO_LP: C31.1, R21.2, R22.1
AUDIO_OUT: C32.2, J6.R, J6.T
B0: U7.45 (I/O/PD2); also elsewhere on the board
B1: U7.48 (I/O); also elsewhere on the board
CLK24: U7.83 (INPUT/GCLK1); also elsewhere on the board
DE: U7.20 (I/O); also elsewhere on the board
DUART_IRQ: U7.17 (I/O); also elsewhere on the board
G0: U7.52 (I/O); also elsewhere on the board
G1: U7.51 (I/O); also elsewhere on the board
G2: U7.34 (I/O); also elsewhere on the board
GND: C20.2, C21.2, C22.2, C23.2, C24.2, C25.2, C26.2, C27.2, C28.2, C29.2, C30.2, C31.2, D3.1 (K), D4.1 (K), J3.3, J3.SH, J4.6 (VSS), J4.11 (SHIELD), J6.S, R11.2, R23.2, R36.2, U7.2 (INPUT/OE2/GCLK2), U7.7 (GND), U7.19 (GND), U7.32 (GND), U7.42 (GND), U7.47 (GND), U7.59 (GND), U7.72 (GND), U7.82 (GND), U7.84 (INPUT/OE1); also elsewhere on the board
HSYNC: U7.41 (I/O); also elsewhere on the board
IOCS: U7.9 (I/O); also elsewhere on the board
IPL0: U7.33 (I/O); also elsewhere on the board
IPL1: U7.35 (I/O); also elsewhere on the board
IPL2: U7.37 (I/O); also elsewhere on the board
JTAG_TCK: U7.62 (I/O/TCK); also elsewhere on the board
JTAG_TDO: U7.71 (I/O/TDO); also elsewhere on the board
JTAG_TDO1: R8.2, U7.14 (I/O/TDI); also elsewhere on the board
JTAG_TMS: U7.23 (I/O/TMS); also elsewhere on the board
LATCH: U7.21 (I/O); also elsewhere on the board
LED0: R12.1, U7.27 (I/O)
LED0_A: D3.2 (A), R12.2
LED1: R13.1, U7.28 (I/O)
LED1_A: D4.2 (A), R13.2
MA17: U7.56 (I/O); also elsewhere on the board
MA18: U7.57 (I/O); also elsewhere on the board
MD0: U7.31 (I/O); also elsewhere on the board
MD1: U7.36 (I/O); also elsewhere on the board
MD2: U7.29 (I/O); also elsewhere on the board
MD3: U7.39 (I/O); also elsewhere on the board
MD4: U7.81 (I/O/GCLK3); also elsewhere on the board
MD5: U7.70 (I/O); also elsewhere on the board
MD6: U7.63 (I/O); also elsewhere on the board
MD7: U7.68 (I/O); also elsewhere on the board
MD8: U7.67 (I/O); also elsewhere on the board
MD9: U7.69 (I/O); also elsewhere on the board
MD10: U7.30 (I/O); also elsewhere on the board
MD11: U7.65 (I/O); also elsewhere on the board
MD12: U7.64 (I/O); also elsewhere on the board
MD13: U7.5 (I/O); also elsewhere on the board
MD14: U7.40 (I/O); also elsewhere on the board
MD15: U7.6 (I/O); also elsewhere on the board
NMIBTN: C29.1, R11.1, SW2.2, U7.73 (I/O)
PALJMP: R36.1, U7.18 (I/O)
PS2_CLK: J3.5, R10.2, U7.80 (I/O)
PS2_DAT: J3.1, R9.2, U7.79 (I/O)
R0: U7.49 (I/O); also elsewhere on the board
R1: U7.46 (I/O); also elsewhere on the board
R2: U7.50 (I/O); also elsewhere on the board
RW: U7.22 (I/O); also elsewhere on the board
SD_CLK: J4.5 (CLK), R16.2, U7.15 (I/O)
SD_CMD: J4.3 (CMD), R17.2, U7.24 (I/O)
SD_DAT0: J4.7 (DAT0), R18.2, U7.8 (I/O)
SD_DAT1: J4.8 (DAT1), R19.2, U7.16 (I/O)
SD_DAT2: J4.1 (DAT2), R20.2, U7.58 (I/O)
SD_DAT3: J4.2 (DAT3/CD), R15.2, U7.4 (I/O)
SYSRESET: U7.1 (INPUT/GCLR); also elsewhere on the board
VCC: C20.1, C21.1, C22.1, C23.1, C24.1, C25.1, C26.1, C27.1, C28.1, J3.4, R8.1, R9.1, R10.1, SW2.1, U7.3 (VCCINT), U7.13 (VCCIO), U7.26 (VCCIO), U7.38 (VCCIO), U7.43 (VCCINT), U7.53 (VCCIO), U7.66 (VCCIO), U7.78 (VCCIO); also elsewhere on the board
VSYNC: U7.44 (I/O); also elsewhere on the board

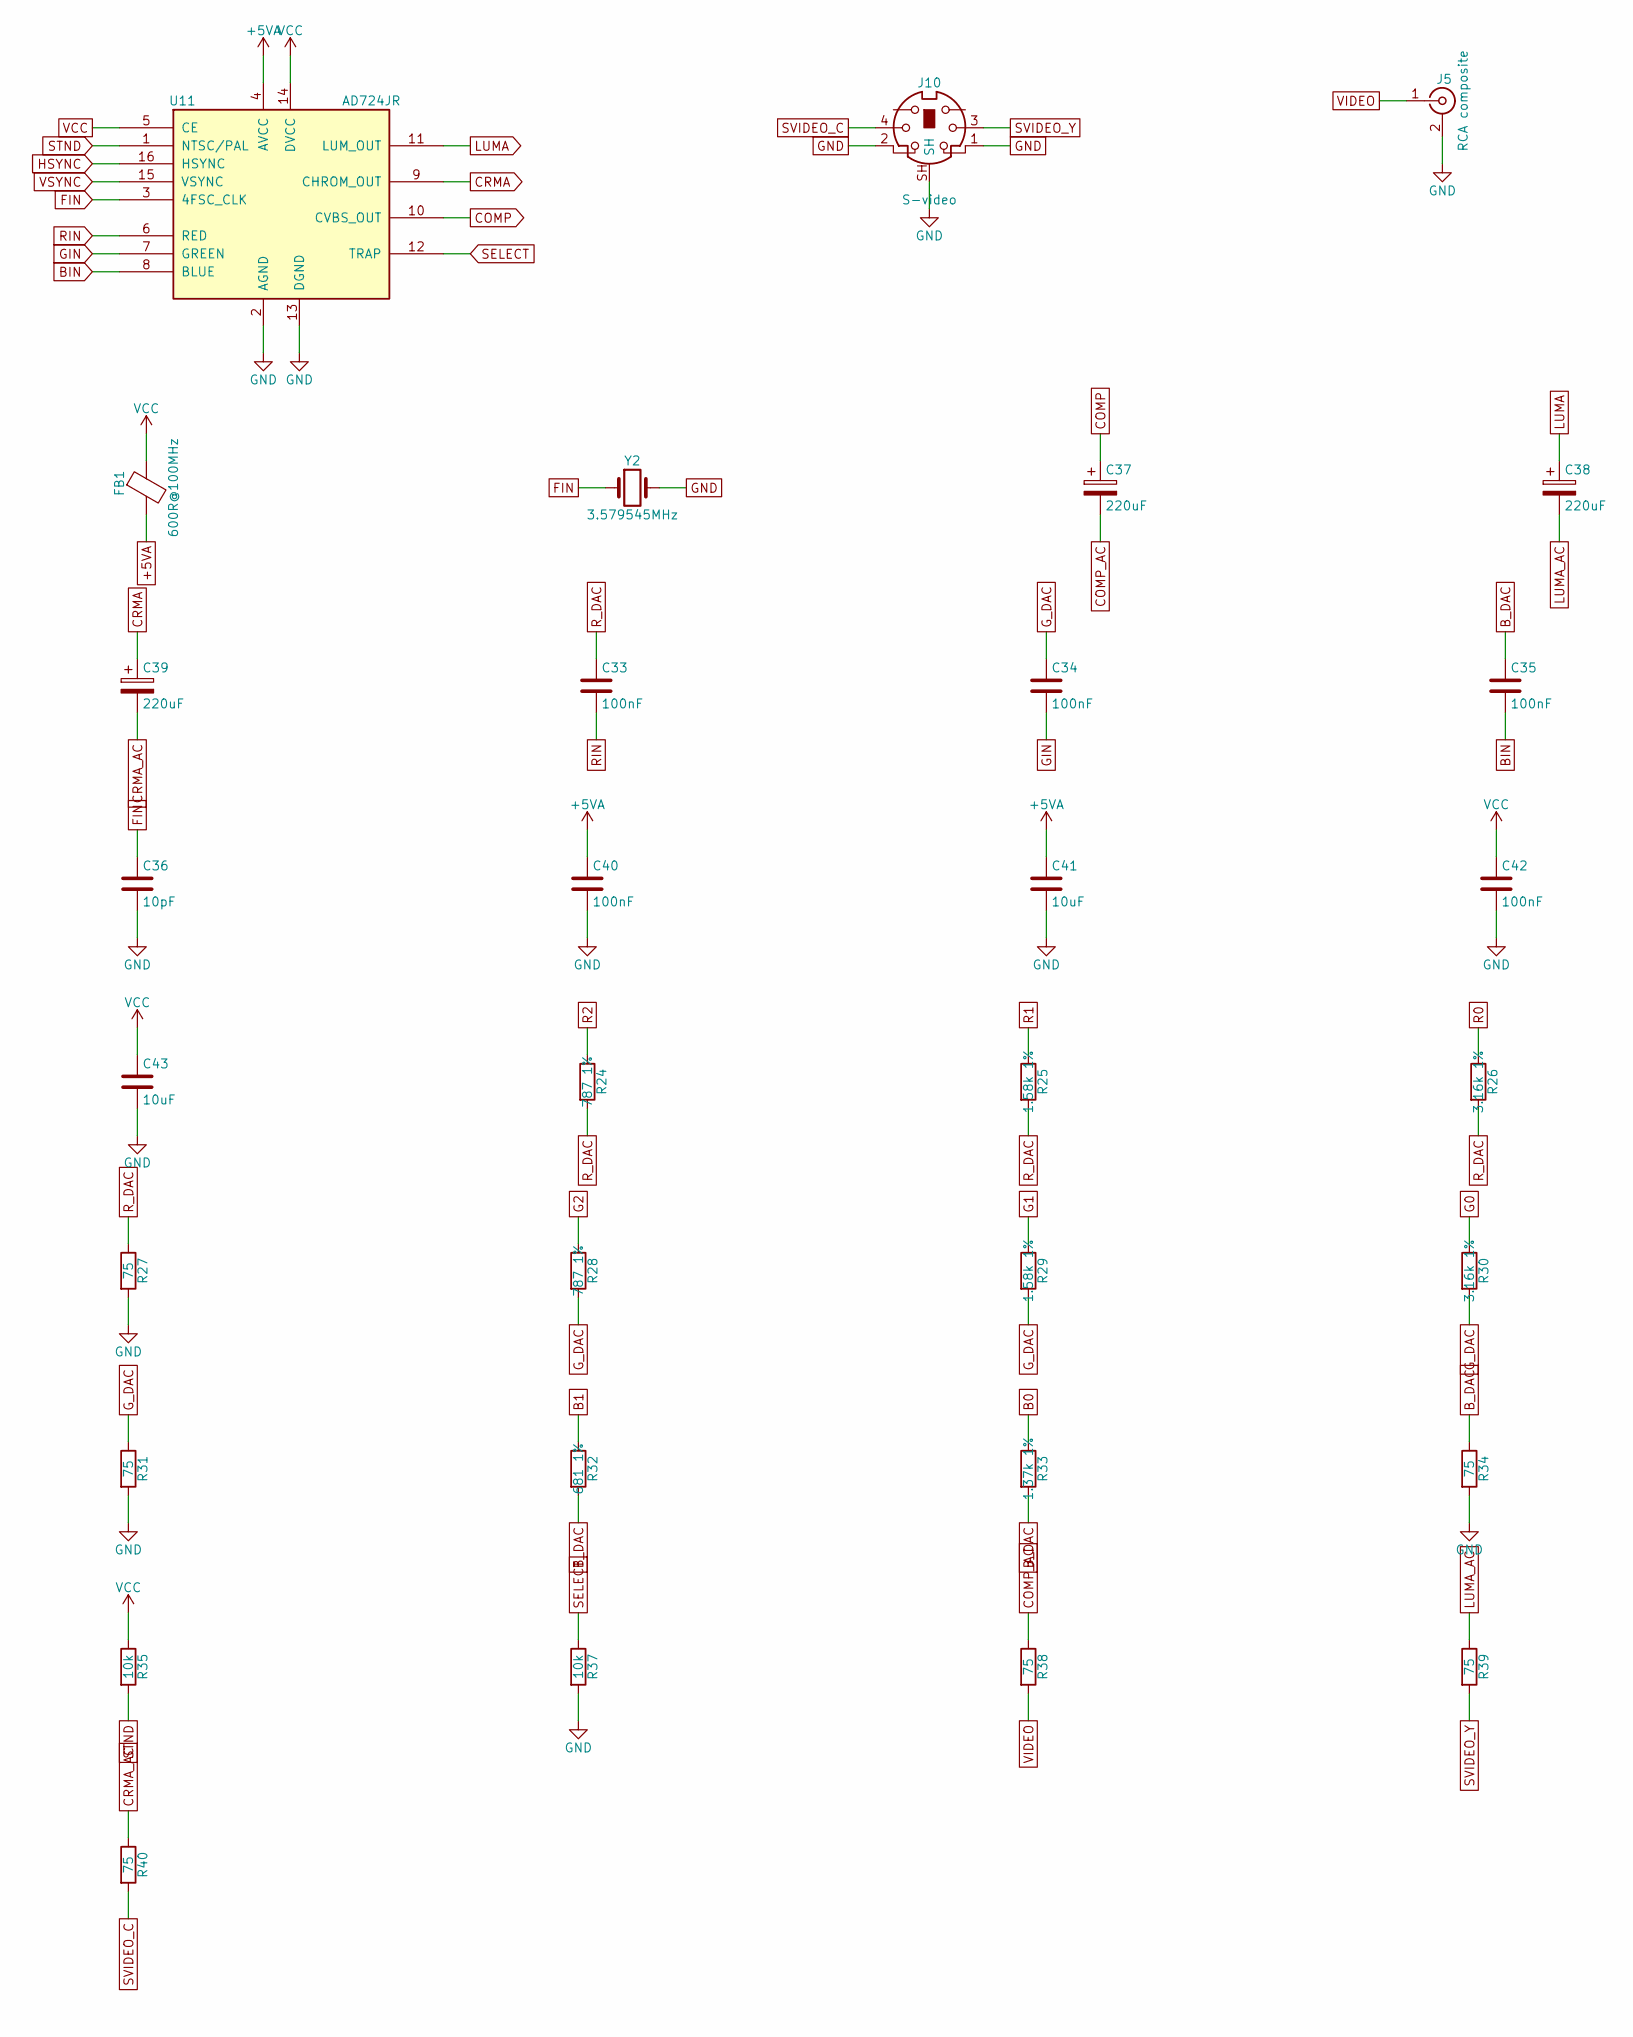
[picture p13: schematic other-m68k-video.kicad_sch, video]

Parts:
C33, C34, C35, C40, C42: 100nF; C_0603_1608Metric; MPN CL10B104KB8NNNC; LCSC C1591
C36: 10pF; C_0603_1608Metric; MPN CL10C100JB8NNNC; LCSC C32949
C37, C38, C39: 220uF; CP_Radial_D6.3mm_P2.50mm; MPN 16ZLH220MEFC6.3X11
C41, C43: 10uF; C_0805_2012Metric; MPN CL21A106KAYNNNE; LCSC C15850
FB1: 600R@100MHz; L_0603_1608Metric; MPN BLM18PG601SN1D
J5: RCA composite; RCA_CUI_RCJ-041_Horizontal; MPN RCJ-041
J10: S-video; MiniDIN-4_CUI_MD-40SM_Horizontal; MPN MD-40SM
R24, R28: 787 1%; R_0603_1608Metric; MPN RC0603FR-07787RL
R25, R29: 1.58k 1%; R_0603_1608Metric; MPN RC0603FR-071K58L
R26, R30: 3.16k 1%; R_0603_1608Metric; MPN RC0603FR-073K16L
R27, R31, R34, R38, R39, R40: 75; R_0603_1608Metric; MPN RC0603FR-0775RL
R32: 681 1%; R_0603_1608Metric; MPN RC0603FR-07681RL
R33: 1.37k 1%; R_0603_1608Metric; MPN RC0603FR-071K37L
R35, R37: 10k; R_0603_1608Metric; MPN RC0603FR-0710KL; LCSC C25804
U11: AD724JR; SOIC-16W_7.5x10.3mm_P1.27mm; MPN AD724JRZ
Y2: 3.579545MHz; Crystal_HC49-U_Vertical; MPN ECS-35-17-4X

Connections:
+5VA: C40.1, C41.1, FB1.2, U11.4 (AVCC)
B0: R33.1; also elsewhere on the board
B1: R32.1; also elsewhere on the board
BIN: C35.2, U11.8 (BLUE)
B_DAC: C35.1, R32.2, R33.2, R34.1
COMP: C37.1, U11.10 (CVBS_OUT)
COMP_AC: C37.2, R38.1
CRMA: C39.1, U11.9 (CHROM_OUT)
CRMA_AC: C39.2, R40.1
FIN: C36.1, U11.3 (4FSC_CLK), Y2.1
G0: R30.1; also elsewhere on the board
G1: R29.1; also elsewhere on the board
G2: R28.1; also elsewhere on the board
GIN: C34.2, U11.7 (GREEN)
GND: C36.2, C40.2, C41.2, C42.2, C43.2, J5.2 (Ext), J10.1, J10.2, J10.SH, R27.2, R31.2, R34.2, R37.2, U11.2 (AGND), U11.13 (DGND), Y2.2; also elsewhere on the board
G_DAC: C34.1, R28.2, R29.2, R30.2, R31.1
HSYNC: U11.16 (HSYNC); also elsewhere on the board
LUMA: C38.1, U11.11 (LUM_OUT)
LUMA_AC: C38.2, R39.1
R0: R26.1; also elsewhere on the board
R1: R25.1; also elsewhere on the board
R2: R24.1; also elsewhere on the board
RIN: C33.2, U11.6 (RED)
R_DAC: C33.1, R24.2, R25.2, R26.2, R27.1
SELECT: R37.1, U11.12 (TRAP)
STND: R35.2, U11.1 (NTSC/PAL)
SVIDEO_C: J10.4, R40.2
SVIDEO_Y: J10.3, R39.2
VCC: C42.1, C43.1, FB1.1, R35.1, U11.5 (CE), U11.14 (DVCC); also elsewhere on the board
VIDEO: J5.1 (In), R38.2; also elsewhere on the board
VSYNC: U11.15 (VSYNC); also elsewhere on the board

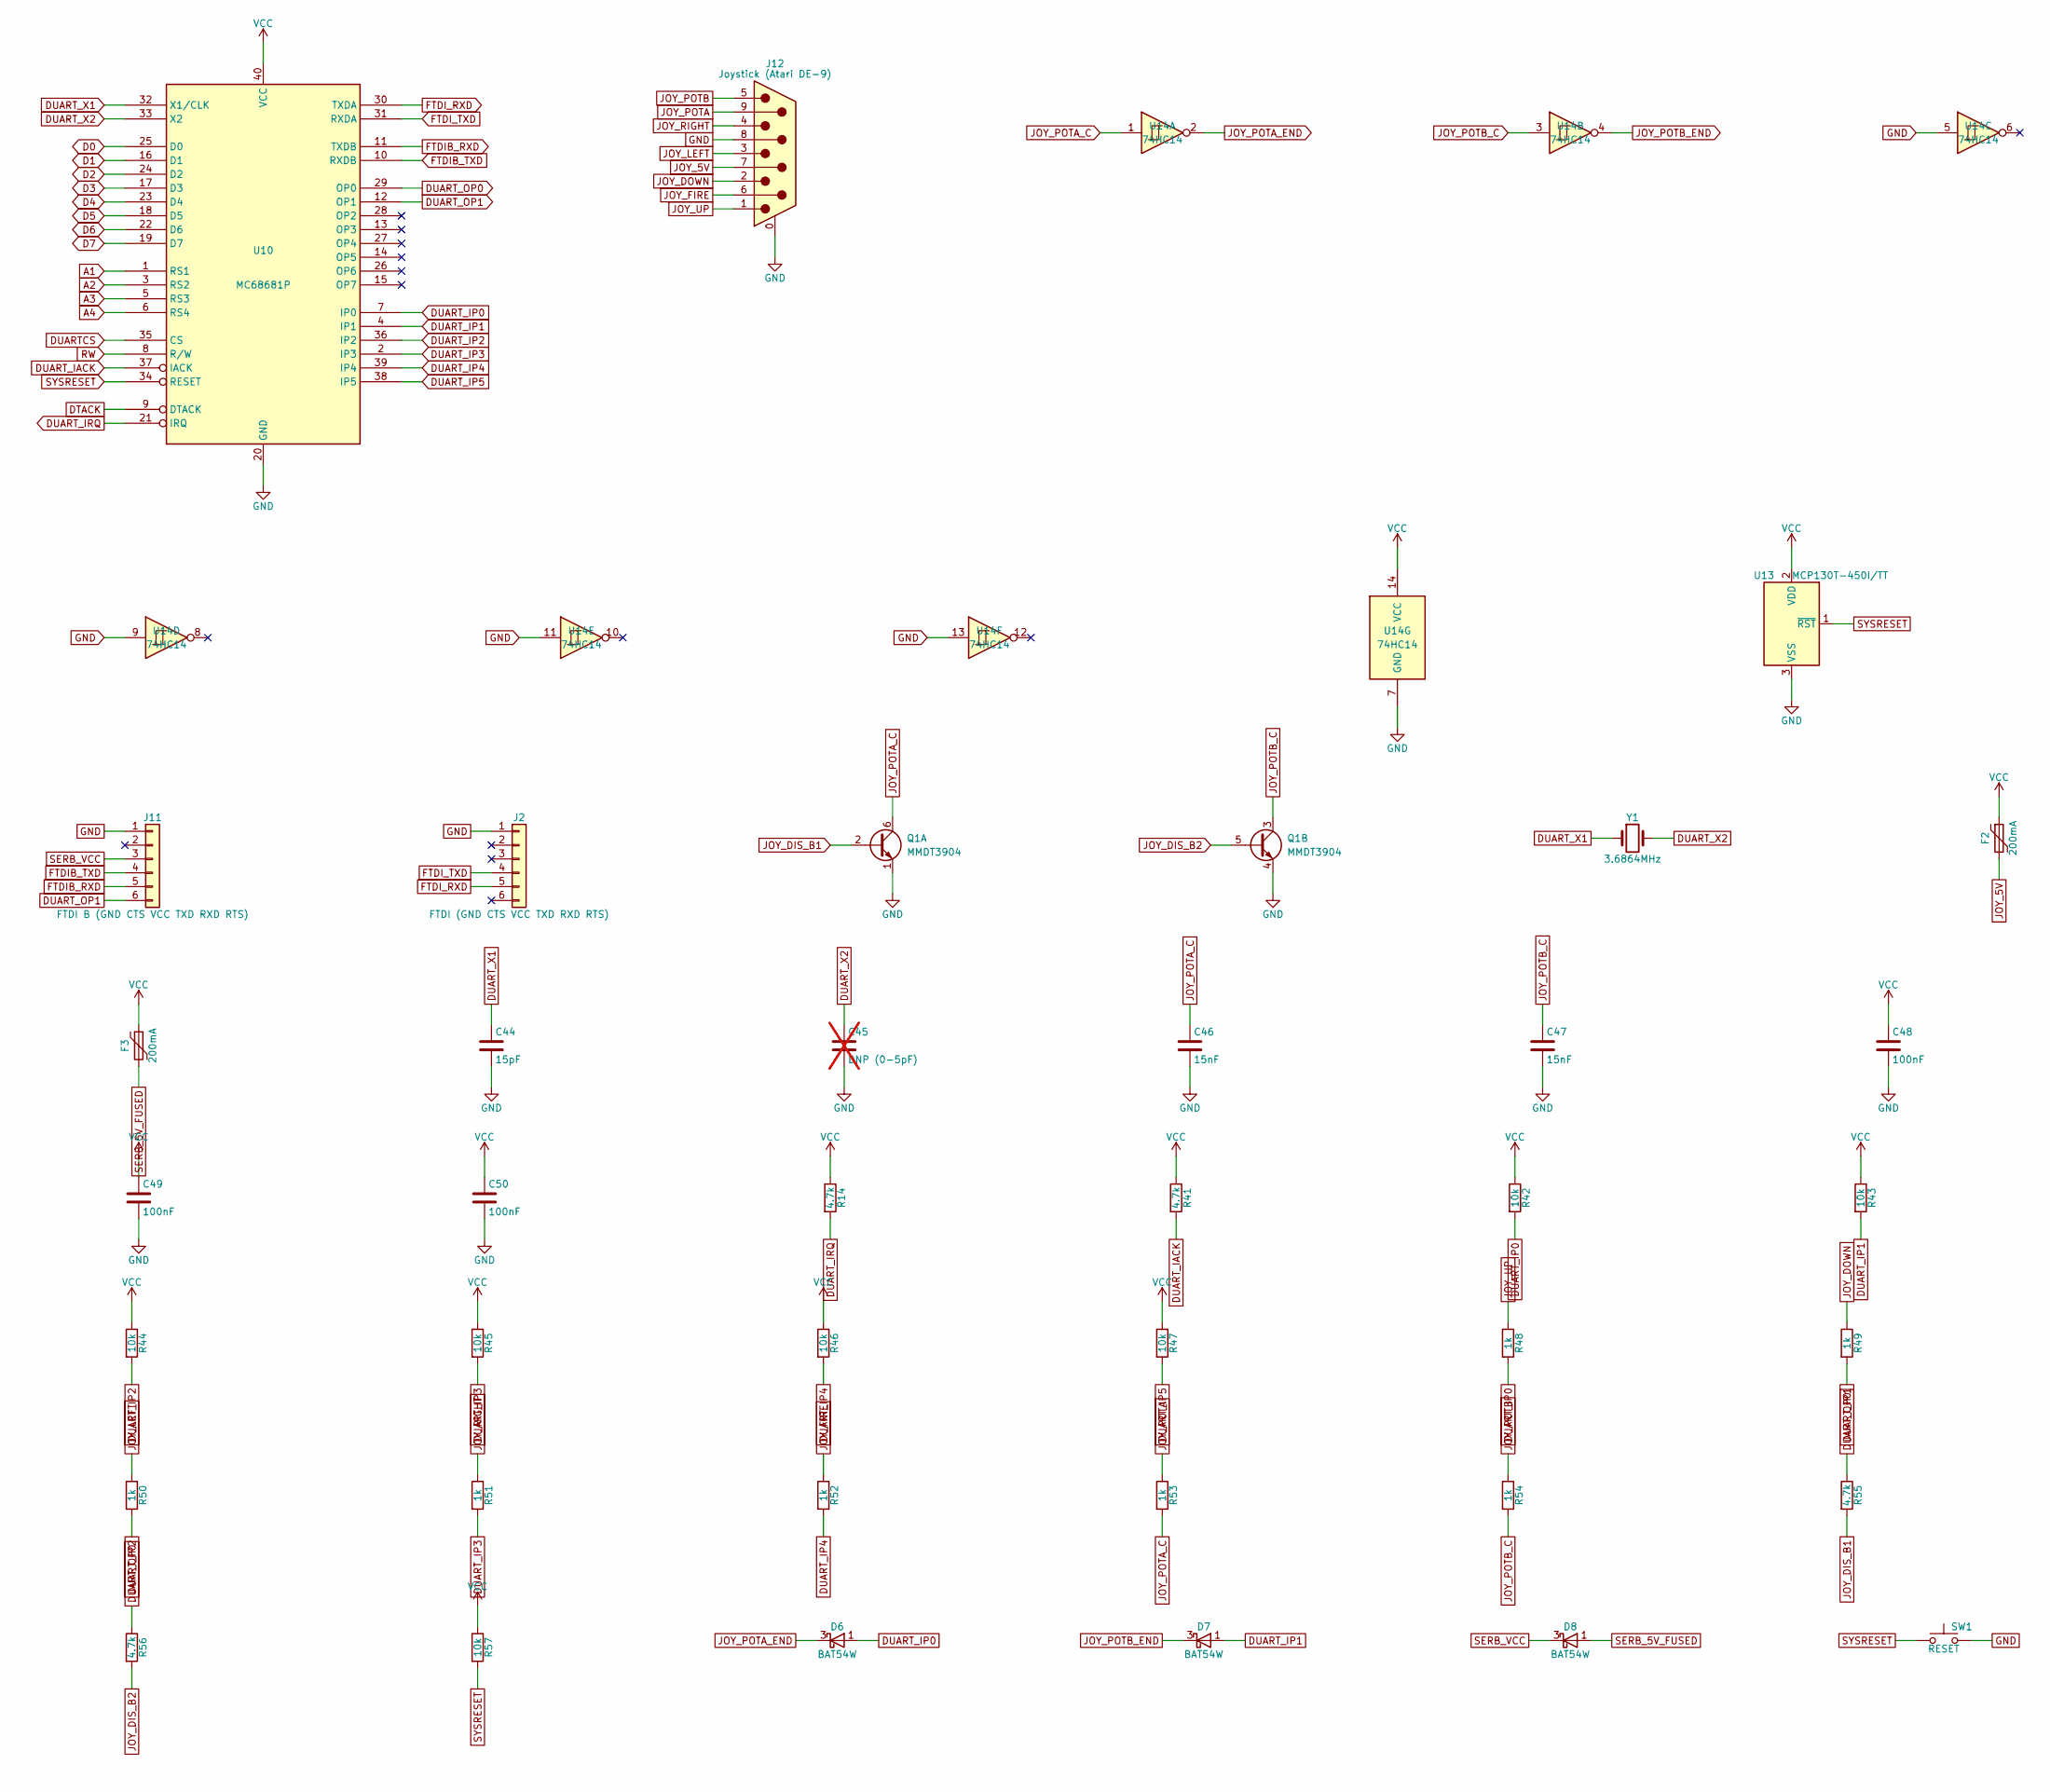
[picture p14: schematic other-m68k-io.kicad_sch, io]

Parts:
C44: 15pF; C_0603_1608Metric; MPN CL10C150JB8NNNC; LCSC C1644
C45: DNP (0-5pF); C_0603_1608Metric; not fitted
C46, C47: 15nF; C_0603_1608Metric; MPN CL10B153KB8NNNC
C48, C49, C50: 100nF; C_0603_1608Metric; MPN CL10B104KB8NNNC; LCSC C1591
D6, D7, D8: BAT54W; SOT-323_SC-70; MPN BAT54W,115; LCSC C8657
F2, F3: 200mA; Fuse_1206_3216Metric; MPN 1206L020YR
J2: FTDI (GND CTS VCC TXD RXD RTS); PinHeader_1x06_P2.54mm_Vertical; MPN PRPC006SAAN-RC
J11: FTDI B (GND CTS VCC TXD RXD RTS); PinHeader_1x06_P2.54mm_Vertical; MPN PRPC006SAAN-RC
J12: Joystick (Atari DE-9); DSUB-9_Pins_Horizontal_P2.77x2.84mm_EdgePinOffset7.70mm_Hou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; MPN L717SDE09PA4CH4F
Q1: MMDT3904; SOT-363_SC-70-6; MPN MMDT3904-7-F; LCSC C8706
R14, R41, R55, R56: 4.7k; R_0603_1608Metric; MPN RC0603FR-074K7L; LCSC C23162
R42, R43, R44, R45, R46, R47, R57: 10k; R_0603_1608Metric; MPN RC0603FR-0710KL; LCSC C25804
R48, R49, R50, R51, R52, R53, R54: 1k; R_0603_1608Metric; MPN RC0603FR-071KL; LCSC C21190
SW1: RESET; SW_PUSH_6mm; MPN B3F-1000
U10: MC68681P; DIP-40_W15.24mm_Socket; MPN MC68681P
U13: MCP130T-450I/TT; SOT-23; MPN MCP130T-450I/TT
U14: 74HC14; SOIC-14_3.9x8.7mm_P1.27mm; MPN 74HC14D,653; LCSC C5612
Y1: 3.6864MHz; Crystal_HC49-U_Vertical; MPN ECS-36-20-4XDN

Connections:
A1: U10.1 (RS1); also elsewhere on the board
A2: U10.3 (RS2); also elsewhere on the board
A3: U10.5 (RS3); also elsewhere on the board
A4: U10.6 (RS4); also elsewhere on the board
D0: U10.25 (D0); also elsewhere on the board
D1: U10.16 (D1); also elsewhere on the board
D2: U10.24 (D2); also elsewhere on the board
D3: U10.17 (D3); also elsewhere on the board
D4: U10.23 (D4); also elsewhere on the board
D5: U10.18 (D5); also elsewhere on the board
D6: U10.22 (D6); also elsewhere on the board
D7: U10.19 (D7); also elsewhere on the board
DTACK: U10.9 (DTACK); also elsewhere on the board
DUARTCS: U10.35 (CS); also elsewhere on the board
DUART_IACK: R41.2, U10.37 (IACK)
DUART_IP0: D6.1 (A), R42.2, R48.2, U10.7 (IP0)
DUART_IP1: D7.1 (A), R43.2, R49.2, U10.4 (IP1)
DUART_IP2: R44.2, R50.2, U10.36 (IP2)
DUART_IP3: R45.2, R51.2, U10.2 (IP3)
DUART_IP4: R46.2, R52.2, U10.39 (IP4)
DUART_IP5: R47.2, U10.38 (IP5)
DUART_IRQ: R14.2, U10.21 (IRQ); also elsewhere on the board
DUART_OP0: R55.1, R56.1, U10.29 (OP0)
DUART_OP1: J11.6, U10.12 (OP1)
DUART_X1: C44.1, U10.32 (X1/CLK), Y1.1
DUART_X2: C45.1, U10.33 (X2), Y1.2
FTDIB_RXD: J11.5, U10.11 (TXDB)
FTDIB_TXD: J11.4, U10.10 (RXDB)
FTDI_RXD: J2.5, U10.30 (TXDA)
FTDI_TXD: J2.4, U10.31 (RXDA)
GND: C44.2, C45.2, C46.2, C47.2, C48.2, C49.2, C50.2, J2.1, J11.1, J12.0 (PAD), J12.8, Q1.1 (E1), Q1.4 (E2), SW1.2, U10.20 (GND), U13.3 (VSS), U14.5, U14.7 (GND), U14.9, U14.11, U14.13; also elsewhere on the board
JOY_5V: F2.2, J12.7
JOY_DIS_B1: Q1.2 (B1), R55.2
JOY_DIS_B2: Q1.5 (B2), R56.2
JOY_DOWN: J12.2, R49.1
JOY_FIRE: J12.6, R52.1
JOY_LEFT: J12.3, R50.1
JOY_POTA: J12.9, R53.1
JOY_POTA_C: C46.1, Q1.6 (C1), R53.2, U14.1
JOY_POTA_END: D6.3 (K), U14.2
JOY_POTB: J12.5, R54.1
JOY_POTB_C: C47.1, Q1.3 (C2), R54.2, U14.3
JOY_POTB_END: D7.3 (K), U14.4
JOY_RIGHT: J12.4, R51.1
JOY_UP: J12.1, R48.1
RW: U10.8 (R/W); also elsewhere on the board
SERB_5V_FUSED: D8.1 (A), F3.2
SERB_VCC: D8.3 (K), J11.3
SYSRESET: R57.2, SW1.1, U10.34 (RESET), U13.1 (~RST); also elsewhere on the board
VCC: C48.1, C49.1, C50.1, F2.1, F3.1, R14.1, R41.1, R42.1, R43.1, R44.1, R45.1, R46.1, R47.1, R57.1, U10.40 (VCC), U13.2 (VDD), U14.14 (VCC); also elsewhere on the board

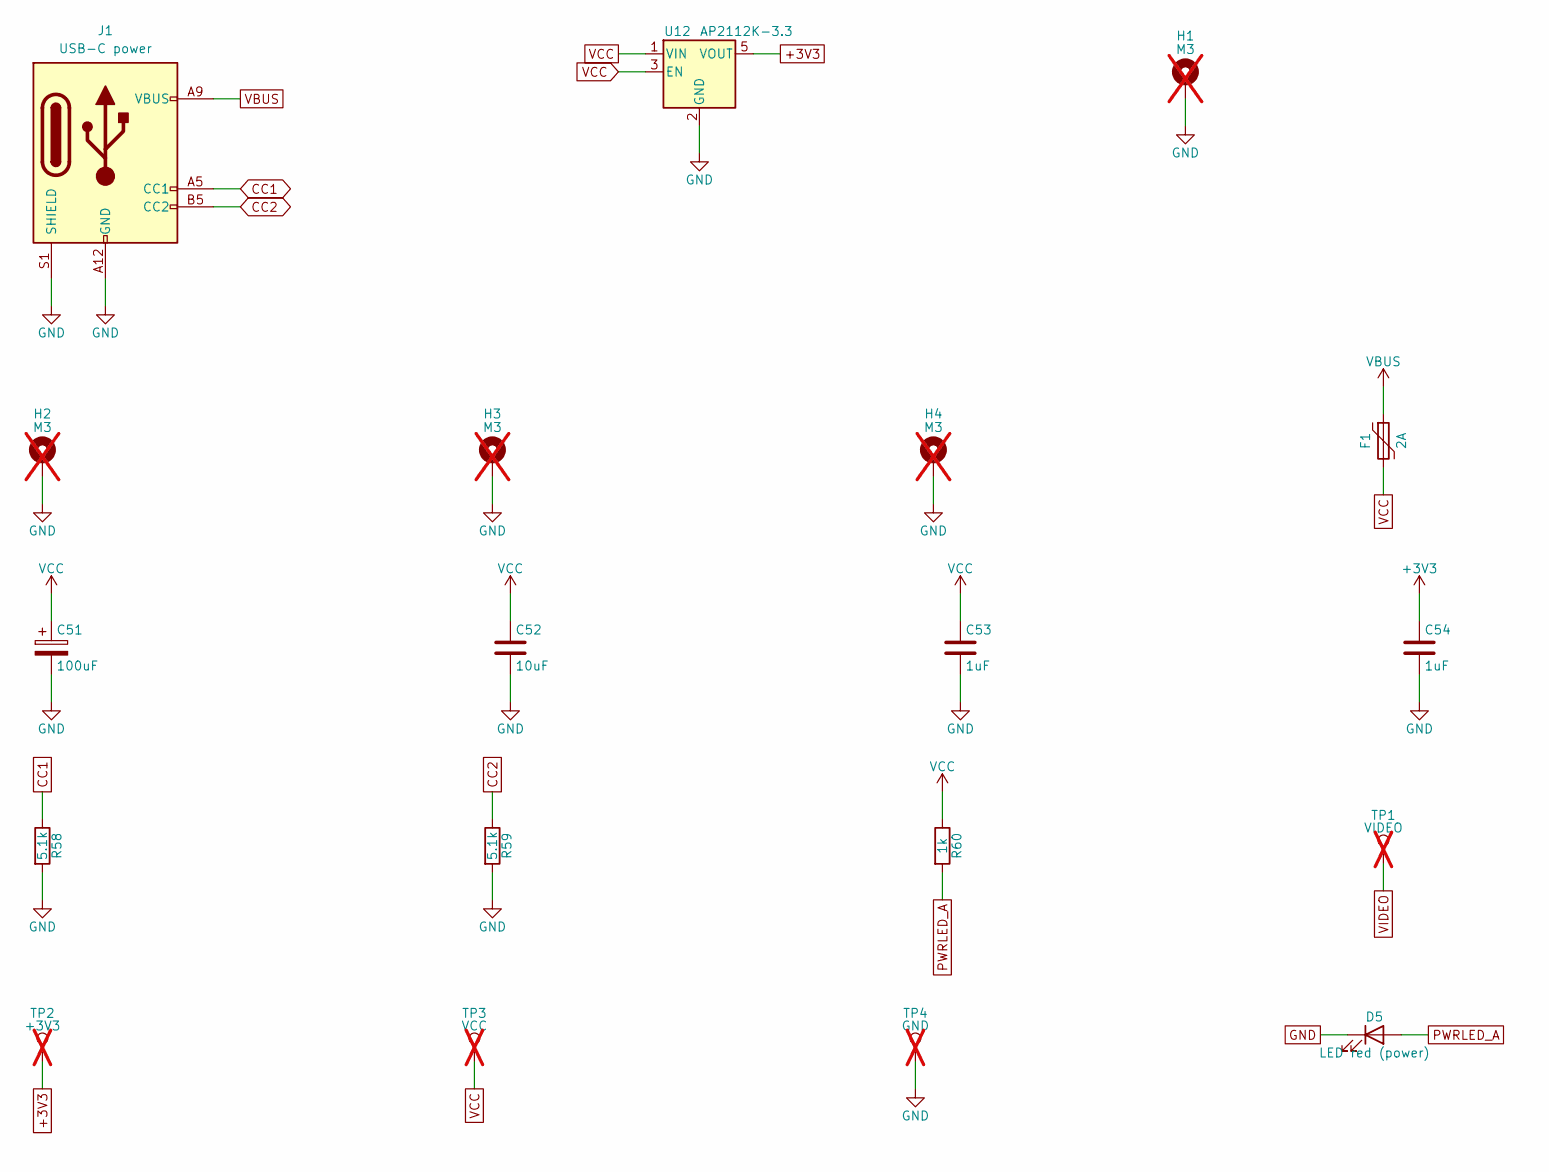
[picture p15: schematic other-m68k-power.kicad_sch, power]

Parts:
C51: 100uF; CP_Radial_D6.3mm_P2.50mm; MPN 35ZLH100MEFC6.3X11
C52: 10uF; C_0805_2012Metric; MPN CL21A106KAYNNNE; LCSC C15850
C53, C54: 1uF; C_0603_1608Metric; MPN CL10A105KB8NNNC; LCSC C15849
D5: LED red (power); LED_0805_2012Metric; MPN LTST-C171KRKT
F1: 2A; Fuse_1206_3216Metric; MPN 1206L200PR
H1, H2, H3, H4: M3; MountingHole_3.2mm_M3_Pad; not fitted
J1: USB-C power; USB_C_Receptacle_GCT_USB4125-xx-x_6P_TopMnt_Horizontal; MPN USB4125-GF-A-0190
R58, R59: 5.1k; R_0603_1608Metric; MPN RC0603FR-075K1L; LCSC C23186
R60: 1k; R_0603_1608Metric; MPN RC0603FR-071KL; LCSC C21190
TP1: VIDEO; TestPoint_Pad_D1.5mm; not fitted
TP2: +3V3; TestPoint_Pad_D1.5mm; not fitted
TP3: VCC; TestPoint_Pad_D1.5mm; not fitted
TP4: GND; TestPoint_Pad_D1.5mm; not fitted
U12: AP2112K-3.3; SOT-23-5; MPN AP2112K-3.3TRG1; LCSC C51118

Connections:
+3V3: C54.1, TP2.1, U12.5 (VOUT); also elsewhere on the board
CC1: J1.A5 (CC1), R58.1
CC2: J1.B5 (CC2), R59.1
GND: C51.2, C52.2, C53.2, C54.2, D5.1 (K), H1.1, H2.1, H3.1, H4.1, J1.A12 (GND), J1.B12 (GND), J1.S1 (SHIELD), R58.2, R59.2, TP4.1, U12.2 (GND); also elsewhere on the board
PWRLED_A: D5.2 (A), R60.2
VBUS: F1.1, J1.A9 (VBUS), J1.B9 (VBUS)
VCC: C51.1, C52.1, C53.1, F1.2, R60.1, TP3.1, U12.1 (VIN), U12.3 (EN); also elsewhere on the board
VIDEO: TP1.1; also elsewhere on the board

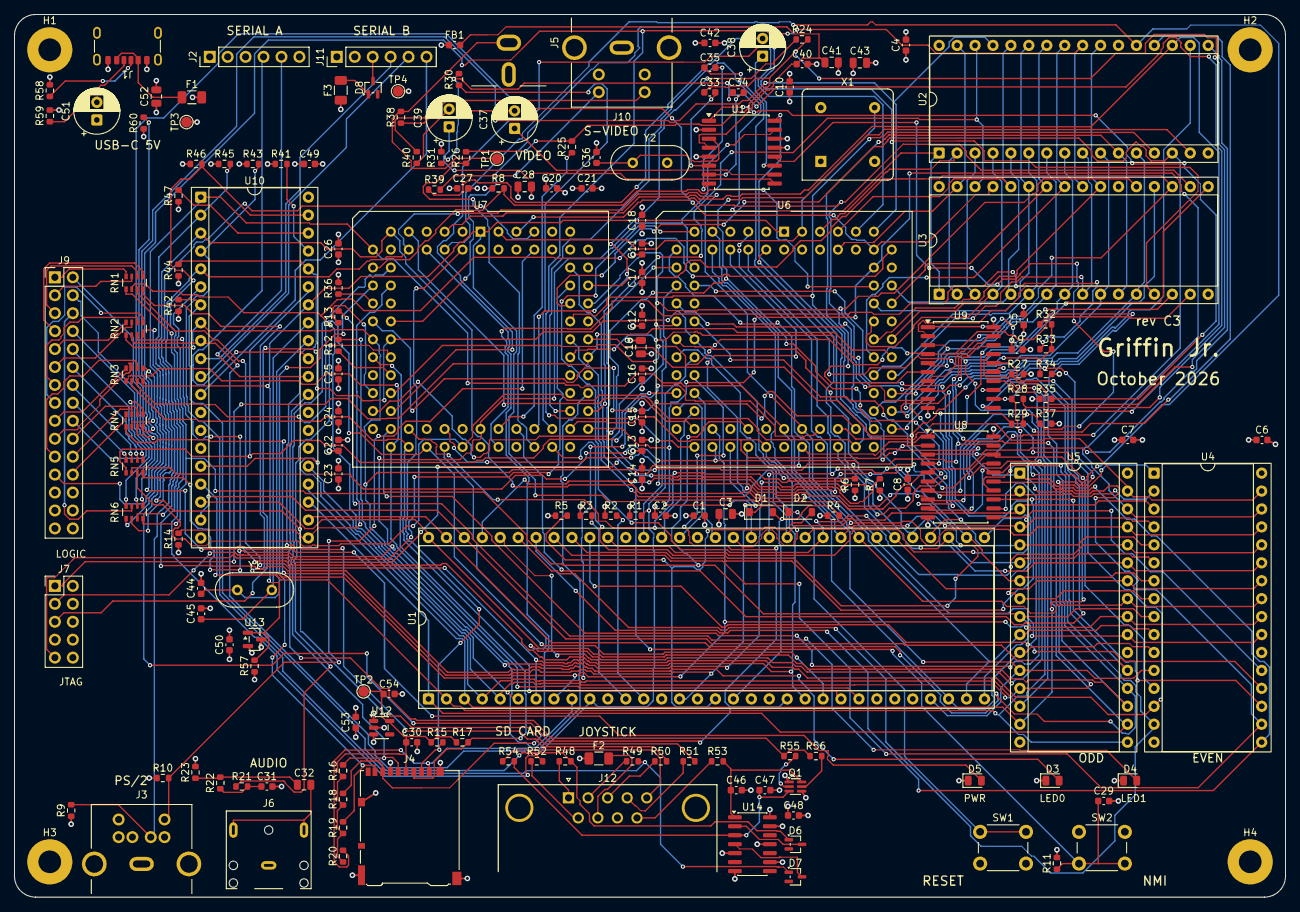
[picture p16: board other-m68k.kicad_pcb from above]

Board: 4 copper layers, 180.0 x 125.0 mm, 171 parts (0 on the bottom side), 216 nets.
