bradgrantham/other-m68k/emu/io.c

/* CPLD2 registers, interrupt controller, soft switches.
 *
 * Registers are 16 bits at IO_BASE + 2n (n = A1..A3, mirrored through the
 * region).  CPLD2 has no UDS/LDS, so byte accesses are undefined on the real
 * board; here a byte read returns its half of the word and a byte write
 * updates only that half of the shadow (the least surprising choice for
 * software).  INTEN, GPIO and AUDIO are write-only on the board (they read as 0);
 * the emulator keeps the written values as the pin state.  SDIO (spec rev 7) holds
 * six open-drain drive bits for the SD card lines and reads back the line levels,
 * the AND of the host's drive and the card's (sdcard.c).  Offset 12 (the old USERIO)
 * has no register.
 *
 * AUDIO (spec rev 5) loads an 8-bit rotating shift register whose bit 7 is the
 * audio pin.  CPLD2 rotates it left at the HSYNC leading edge and then every 24
 * bus slots (PDM_BIT_CLOCKS CPU clocks); the counter restarts at HSYNC, so the
 * 8th timed rotation never happens and the HSYNC rotation takes its place.  A
 * write replaces the register at once and suppresses a rotation at the same
 * cycle.  The shifter is evaluated lazily: rotations are applied in time order
 * up to each write and up to each line start / frame end, emitting an edge to
 * the audio renderer whenever bit 7 changes.
 */
#include <stdio.h>
#include <string.h>

#include "hw.h"
#include "emu_map.h"
#include "m68k.h"
#include "emu.h"
#include "io.h"
#include "video.h"
#include "duart.h"
#include "sdcard.h"
#include "audio.h"

static uint16_t flags;          /* INTSTAT bits that are flags */
static uint16_t inten;
static uint16_t sdio;
static uint16_t gpio;
static uint16_t ps2data;
static int nmi_held;
static int cur_ipl = -1;
static int pending_page;
static int pending_pal;

#define FLAG_MASK (INTSTAT_VBLANK | INTSTAT_HSYNC | INTSTAT_PS2RDY | INTSTAT_PS2ERR)
#define W1C_MASK  (INTSTAT_VBLANK | INTSTAT_HSYNC | INTSTAT_PS2ERR)
#define INTEN_MASK (INTEN_VBLANK | INTEN_HSYNC | INTEN_PS2 | INTEN_DUART)
#define SDIO_OUT_MASK (SDIO_DAT3 | SDIO_CLK | SDIO_CMD | SDIO_DAT0 | SDIO_DAT1 | SDIO_DAT2)
#define GPIO_MASK (GPIO_PS2CLK | GPIO_PS2DAT | GPIO_LED0 | GPIO_LED1)   /* bit 2 retired in rev 5 */

/* PDM audio shifter */
#define PDM_BIT_CLOCKS (24 * SLOT_CPU_CLOCKS)   /* 96 CPU clocks per bit, 8 bits per line */
static uint8_t  pdm_reg;
static uint64_t pdm_line;       /* start cycle of the current line (HSYNC leading edge) */
static int      pdm_k;          /* timed rotations applied so far in this line (0..7) */
static int      pdm_valid;      /* a line start has been seen */

static void io_trace(const char *what, uint32_t offset, uint16_t val)
{
    fprintf(stderr, "m68k-emu: io: %10llu PC=%06X %s %-7s %04X\n", (unsigned long long)emu_cycles(),
            m68k_get_reg(NULL, M68K_REG_PPC) & 0xFFFFFF, what,
            emu_io_reg_names[(offset & 0xE) >> 1], val);
}

void io_reset(void)
{
    flags = 0;
    inten = IO_INTEN_RESET;
    sdio = IO_SDIO_RESET;
    gpio = IO_GPIO_RESET;
    ps2data = 0;
    pending_page = 0;
    pending_pal = 0;
    cur_ipl = -1;
    pdm_reg = 0;
    pdm_k = 0;
    pdm_valid = 0;
    sd_bus(sdio);
    io_update_ipl();
}

/* ---- interrupt controller ---------------------------------------------- */

int io_current_ipl(void)
{
    int level = 0;
    if ((flags & INTSTAT_VBLANK) && (inten & INTEN_VBLANK) && level < IRQ_VBLANK_LEVEL)
        level = IRQ_VBLANK_LEVEL;
    if ((flags & INTSTAT_PS2RDY) && (inten & INTEN_PS2) && level < IRQ_PS2_LEVEL)
        level = IRQ_PS2_LEVEL;
    if (duart_irq() && (inten & INTEN_DUART) && level < IRQ_DUART_LEVEL)
        level = IRQ_DUART_LEVEL;
    if ((flags & INTSTAT_HSYNC) && (inten & INTEN_HSYNC) && level < IRQ_HSYNC_LEVEL)
        level = IRQ_HSYNC_LEVEL;
    if (nmi_held)
        level = IRQ_NMI_LEVEL;
    return level;
}

void io_update_ipl(void)
{
    int level = io_current_ipl();
    if (level != cur_ipl) {
        cur_ipl = level;
        m68k_set_irq((unsigned)level);
        /* Musashi only samples IPL at m68k_execute() entry and on SR writes;
         * end the slice so the change is seen after this instruction. */
        m68k_end_timeslice();
    }
}

void io_set_flag(uint16_t mask)
{
    flags |= mask & FLAG_MASK;
    io_update_ipl();
}

int io_flag_set(uint16_t mask)
{
    return (flags & mask) != 0;
}

void io_set_nmi(int held)
{
    nmi_held = held;
    io_update_ipl();
}

void io_ps2_deliver(uint8_t byte, int frame_error)
{
    ps2data = byte;
    flags |= INTSTAT_PS2RDY;
    if (frame_error)
        flags |= INTSTAT_PS2ERR;
    io_update_ipl();
}

int io_ps2_ready(void)
{
    return (flags & INTSTAT_PS2RDY) != 0;
}

uint16_t io_gpio(void)
{
    return gpio;
}

int io_pending_page(void)
{
    return pending_page;
}

int io_pending_pal(void)
{
    return pending_pal;
}

/* ---- registers ---------------------------------------------------------- */

static uint16_t intstat_value(void)
{
    uint16_t v = flags;
    if (duart_irq())
        v |= INTSTAT_DUARTIRQ;
    if (nmi_held)
        v |= INTSTAT_NMIBTN;
    /* PS/2 lines are open-drain with pull-ups: high unless the GPIO drives
     * them low (the keyboard is idle between frames). */
    if (gpio & GPIO_PS2CLK)
        v |= INTSTAT_PS2CLK;
    if (gpio & GPIO_PS2DAT)
        v |= INTSTAT_PS2DAT;
    if (opts.pal_jumper)
        v |= INTSTAT_PALJMP;
    v |= video_live_pins();
    return v;
}

uint16_t io_peek16(uint32_t offset)
{
    switch (offset & 0xE) {
    case IO_INTSTAT_OFFSET: return intstat_value();
    case IO_INTEN_OFFSET:   return 0;                   /* write-only */
    case IO_SDIO_OFFSET:    return (uint16_t)(sdio & sd_lines());  /* line levels */
    case IO_GPIO_OFFSET:    return 0;                   /* write-only */
    case IO_AUDIO_OFFSET:   return 0;                   /* write-only */
    case IO_PS2DATA_OFFSET: return ps2data;
    case IO_ID_OFFSET:      return IO_ID_RESET;
    default:                return 0;                   /* unassigned: no register */
    }
}

uint16_t io_read16(uint32_t offset, int lanes)
{
    (void)lanes;    /* a byte read still performs the full register read */
    uint16_t v = io_peek16(offset);
    if (opts.io_trace)
        io_trace("rd", offset, v);
    switch (offset & 0xE) {
    case IO_PS2DATA_OFFSET:
        if (flags & INTSTAT_PS2RDY) {
            flags &= (uint16_t)~INTSTAT_PS2RDY;
            io_update_ipl();
        }
        break;
    default:
        break;
    }
    return v;
}

static uint16_t lane_merge(uint16_t old, uint16_t val, int lanes)
{
    uint16_t mask = (uint16_t)(((lanes & 2) ? 0xFF00 : 0) | ((lanes & 1) ? 0x00FF : 0));
    return (uint16_t)((old & ~mask) | (val & mask));
}

static void gpio_write(uint16_t val)
{
    gpio = val & GPIO_MASK;
}

/* ---- PDM audio shifter ----------------------------------------------------- */

static void pdm_rotate(uint64_t t)
{
    uint8_t n = (uint8_t)((pdm_reg << 1) | (pdm_reg >> 7));
    if ((n ^ pdm_reg) & 0x80)
        audio_edge(t, (n >> 7) & 1);
    pdm_reg = n;
}

/* Apply the timed rotations that fall strictly before `until`. */
void io_pdm_advance(uint64_t until)
{
    if (!pdm_valid)
        return;
    while (pdm_k < 7) {
        uint64_t t = pdm_line + (uint64_t)(pdm_k + 1) * PDM_BIT_CLOCKS;
        if (t >= until)
            break;
        pdm_rotate(t);
        pdm_k++;
    }
}

void io_pdm_line_start(uint64_t cycle)
{
    io_pdm_advance(cycle);          /* whatever the previous line still owed */
    pdm_line = cycle;
    pdm_k = 0;
    pdm_valid = 1;
    pdm_rotate(cycle);              /* the HSYNC-edge rotation */
}

static void pdm_write(uint8_t val)
{
    uint64_t now = emu_cycles();
    io_pdm_advance(now);
    /* a rotation due at exactly this cycle is suppressed by the write */
    while (pdm_valid && pdm_k < 7 && pdm_line + (uint64_t)(pdm_k + 1) * PDM_BIT_CLOCKS == now)
        pdm_k++;
    if ((val ^ pdm_reg) & 0x80)
        audio_edge(now, (val >> 7) & 1);
    pdm_reg = val;
}

uint8_t io_pdm_reg(void)
{
    return pdm_reg;
}

void io_write16(uint32_t offset, uint16_t val, int lanes)
{
    if (opts.io_trace)
        io_trace(lanes == 3 ? "wr" : (lanes == 2 ? "wrU" : "wrL"), offset, val);
    switch (offset & 0xE) {
    case IO_INTSTAT_OFFSET:
        val = lane_merge(0, val, lanes);
        if (val & W1C_MASK) {
            flags &= (uint16_t)~(val & W1C_MASK);
            io_update_ipl();
        }
        break;
    case IO_INTEN_OFFSET:
        inten = lane_merge(inten, val, lanes) & INTEN_MASK;
        io_update_ipl();
        break;
    case IO_SDIO_OFFSET:
        sdio = lane_merge(sdio, val, lanes) & SDIO_OUT_MASK;
        sd_bus(sdio);
        break;
    case IO_GPIO_OFFSET:
        gpio_write(lane_merge(gpio, val, lanes));
        break;
    case IO_PS2DATA_OFFSET:
        break;                      /* read only */
    case IO_AUDIO_OFFSET:
        pdm_write((uint8_t)lane_merge(pdm_reg, val, lanes));
        break;
    case IO_ID_OFFSET:
        break;                      /* read only */
    default:
        break;                      /* unassigned: ignored */
    }
}

void io_switch_write(uint32_t offset)
{
    if (opts.io_trace)
        fprintf(stderr, "m68k-emu: io: %10llu PC=%06X switch %s\n", (unsigned long long)emu_cycles(),
                m68k_get_reg(NULL, M68K_REG_PPC) & 0xFFFFFF, emu_switches_reg_names[(offset & 6) >> 1]);
    switch (offset & 6) {
    case SW_PAGE0_OFFSET: pending_page = 0; break;
    case SW_PAGE1_OFFSET: pending_page = 1; break;
    case SW_NTSC_OFFSET:  pending_pal = 0;  break;
    case SW_PAL_OFFSET:   pending_pal = 1;  break;
    }
}
