bradgrantham/other-m68k/(commit log)

2026-10-20 Spec, architecture doc, and generator for the 68000 board
    Single-source spec/board.json drives headers, linker scripts, Verilog
    parameters, syscall stubs/dispatch, emulator tables and HARDWARE.md.
    docs/architecture.md fixes the slot-based SRAM time-slicing scheme.
    Claude-Session: https://claude.ai/code/session_019bbFLKMxhKXGW6aABP44Z1
2026-10-20 Firmware and SDK build scaffolding; correct alignment table in architecture doc
    Firmware/SDK sources are not written yet; see fw/STATUS.md.
    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
    [mkrom.py]
2026-10-20 AD724 application notes for the schematic
    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
2026-10-20 KiCad 9 schematic/PCB generation spike: gen_sch.py, gen_pcb.py, netlist checker
    Generates .kicad_sch from a Python board description using global labels,
    verified with kicad-cli ERC (0 violations), netlist round-trip, PDF export,
    pcbnew netlist import, DRC, and freerouting via DSN/SES.
    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
2026-10-20 Emulator: Musashi-based SDL2 emulator with full peripheral model and self-test
    Memory map with reset overlay and 68000 group-0 bus-error frames, CPLD2
    registers and interrupt controller, NTSC/PAL frame timing, bit-banged
    serial decoder, PS/2 keyboard, SPI-mode SDHC card, 1-bit audio, tracing.
    make -C emu test runs a 26-check test ROM headless.
    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
    [audio.c, audio.h, bus.c, bus.h, emu.h, io.c, io.h, m68kcpu.h]
2026-10-20 gen: emit video constants in hw.inc; fix frame cycle count in architecture doc
    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
2026-10-20 CPLD Verilog for MMU and I/O chips with system testbench; doc fixes from the HDL audit
    cpld1_mmu.v and cpld2_io.v implement docs/architecture.md; tb_system.v
    runs the whole board (bus master with datasheet delays, 70 ns SRAM model,
    transceivers, EPROM) through 12 tests including a full NTSC frame pixel
    compare and a bus-contention checker. Alignment table corrected (E2 case
    is 7 clocks), RAMOE release documented, TAS noted as unsupported.
    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
    [cpld1_mmu.v, cpld2_io.v, tb_m68k_bus.v, tb_sram.v, tb_system.v]
2026-10-20 Firmware stage 1 (POST, BIOS, console, PS/2, serial, monitor, syscalls) and SDK with newlib shim and examples; add ATF15xx fitting guidance
    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
2026-10-20 CPLD fitter flow (fit.sh) and real ATF1508AS fits; restructure CPLD2 for the fitter
    CPLD1 fits at 98/128. CPLD2 refits at 127/128 after dropping the hardware serial
    TX, making control registers write-only, counting UART samples in slots with a
    5-bit upcounter and using a sentinel shifter for PS/2; measured ladder of further
    cuts in hdl/README.md. -DNO_PS2HW / -DNO_SERHW build options (both ~105/128)
    await a design decision. Monitor prints the INTEN shadow.
    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
2026-10-20 HDL for spec rev 2: DUART chip select and open-drain DTACK in CPLD1, DUART IRQ in CPLD2, serial engine removed; harvested pin blocks; both chips fit pass 1 (103 and 104 of 128)
    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
2026-10-20 hdl: commit the schematic pin maps (pins_<chip>.json)
    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
2026-10-20 gen: emit DUART mode/command values and register reset values into hw.h/hw.inc; firmware uses them
    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
    [duart.h]
2026-10-20 Emulator for spec rev 2: register-level MC68681 model (both channels, FIFOs, counter/timer, IRQ), CPLD serial model removed, write-only IO registers; self-test 44 checks
    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
2026-10-20 Firmware stage 2: bit-banged SD (SDHC/SDSC), FatFs R0.15 FAT32, filesystem/SD syscalls, ELF loader with argv, run/dir/cat/sd monitor commands; SDK argv crt0, fcntl flag translation, ls/cat/fstest exa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
2026-10-20 SDIO reset value 0x0001 (SPI clock idles low)
    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
    [cpld2_io.v, tb_system.v]
2026-10-20 KiCad board rev B: full schematic and 4-layer PCB, ZIF sockets, placement checks, PCBWay assembly package
    Schematic (board.py on the gen_sch API): 7 sheets, 153 parts, 196 nets, ERC 0, netlist
    checked exactly against the description. Pin numbers from the data sheets and the fitter's
    pin maps (hdl/pins_*.json). 68681 DUART with channel A on the FTDI header and channel B on
    the expansion header; AD724 with resistor DACs; USB-C power with 2 A polyfuse; MCP130T-450
    SOT-23 supervisor (4.5 V, the USB minimum is 4.75 V); NTSC only (STND pulled up, PALJMP
    pulled down, no jumper); 74AHCT245 in SOIC-20; J9 2x15 logic-analyzer header with gusmanb's
    LogicAnalyzer pinout behind 100 ohm arrays; test pads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
2026-10-20 fab: zip only the routed board's Gerbers, clear the fab directory first, drop the stale JP1 shunt BOM line
    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
2026-10-20 parts: all BOM part numbers verified against distributor listings; 0805 Lite-On LEDs, YC164 arrays, 35 V 100 uF, Mill-Max 110-43 sockets, ECS-36-20-4XDN; schematic depends on parts.json
    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
2026-10-21 Flash ROM (rev 3): CPLD1 ROMOE/ROMWE strobes (pin 50, 111/128 cells), SST39SF040 flash model and tests in the testbench, firmware flashid/flash/reboot with a RAM-resident programmer, emulator flash m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
    [bios.h, bus.c, bus.h, cpld1_mmu.v, emu.h, flash.c, flash.h, flash_layout.h]
2026-10-21 KiCad rev B2: SST39SF040 flash in DIP-32 sockets replaces the EPROM ZIFs; ROMOE/ROMWE wired; rerouted (0 unrouted, DRC 0); fab package and ORDER.md regenerated
    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
    [board.py]
2026-10-21 spec rev 4: RAM is 2x AS6C4008-55PCN (1 MB); framebuffer pages move to the top (0xED400/0xDA800); CPLD2 drives MA17/MA18 (pins 56/57) from A18/A19 (pins 54/55) and FB_PAGE_HI during the video fetch; 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
2026-10-21 Firmware/emulator rev 4: 1 MB RAM; POST RAM test rewritten (address, inverted address, byte-lane sweeps, ~4 s at 12 MHz, catches stuck WEU or WEL); flash staging no longer forces page 0; header depen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
    [bus.c, flash.c]
2026-10-21 KiCad rev B3: 2x AS6C4008-55PCN (1 MB) in the DIP-32 sockets; MA17/MA18 from CPLD2 pins 56/57, A18/A19 to pins 54/55; rerouted (0 unrouted, DRC 0, 514 vias); PCBWay supplies all four memory chips; fa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
2026-10-21 kicad: make release snapshots the routed KiCad project, schematic PDF, SVGs and fab package into kicad/release/ (tracked) so other machines can review and upload without rerouting
    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
    [other-m68k-bom.csv, other-m68k-cpu.kicad_sch, other-m68k-customer-parts.csv, other-m68k-io.kicad_sch, other-m68k-jlcpcb-bom.csv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]
2026-10-21 monitor: an unknown command word runs NAME.ELF from the card with the rest of the line as arguments (bmpview adobe2.bmp); only a missing file falls through to 'unknown command'
    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
    [monitor.c]
2026-10-21 ORDER.md: no consignment; U11 AD724JRZ is PCBWay-sourced with hand-soldering as the fallback; 5 boards, 1 assembled
    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
2026-10-21 KiCad rev B4: USB-C, PS/2 and RCA jacks moved flush with the board edge (were 4.4, 2.5 and 2.0 mm inside); U4 nudged 0.5 mm; rerouted (0 unrouted, DRC 0); fab package and release snapshot regenerated
    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
    [other-m68k-pcbway-centroid.csv, other-m68k.kicad_pcb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]
2026-10-21 docs: rev C ideas (S-video, monochrome switch, Fsc-locked 28.636 MHz clocking, 640-pixel 4 bpp and 1 bpp modes)
    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
2026-10-21 docs: rev C VGA direction (25 MHz, CPU at 12.5 MHz, modes on the one-word-per-slot bus; 320x240x8 needs two words per slot)
    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
2026-10-21 spec rev 5: AUDIO register (offset 10) feeds an 8-bit rotating PDM shifter in CPLD2 (8 bits per line, ~126 kHz); GPIO bit 2 retired; audio_write syscall (30) queues 8-bit samples for the BIOS HSYNC p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
2026-10-21 hdl rev 5: 8-bit rotating PDM audio shifter in CPLD2 (AUDIO register, rotate at HSYNC edge and every 24 slots, write wins); GPIO bit 2 unused; tb test 14 for the shifter (15 tests pass); fit 119/128 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
    [cpld2_io.v, tb_system.v]
2026-10-21 fw/sdk rev 5 audio: audio_write syscall with a 4 KB sample queue encoded through a 64 KB ROM PDM table, level-4 handler in asm (254 clocks per line, self-disabling when the queue empties), beep via I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
2026-10-21 fw/sdk: review fixes (ACR docs, error codes, time functions, sleep rounding, pointer checks)
    - duart.S/duart.h/README/STATUS: ACR is SERIAL_ACR_VALUE = 0x00 (baud-rate set 1, in
    which CSR 0xCC is 38400), not 0x80 / set 2
    - fw README/STATUS: bad user pointers give E_FAULT, non-8.3 names E_NAMETOOLONG
    - newlib_shim: map every ABI E_* to errno (E_NAMETOOLONG -> ENAMETOOLONG, E_FAULT ->
    EFAULT, E_NODEV -> ENODEV, E_ACCES -> EACCES, E_ROFS -> EROFS, E_NOSYS -> ENOSYS);
    sdk/README errno list updated
    - newlib_shim: times()/clock() count milliseconds (CLOCKS_PER_SEC 1000) and
    gettimeofday() uses the real frame length (NTSC 764x262 / PAL 768x312 clocks, picked
    from video_info.standard) inst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
    [duart.h, sd.c, syscall.c]
2026-10-21 spec rev 6: audio streaming by buffer hand-off (audio_start/audio_next/audio_last, 3 BIOS buffers of up to 512 pattern bytes, optionally blocking); audio_write and the ROM encoder table are gone, PDM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
2026-10-21 fw/sdk rev 6 audio: buffer hand-off stream (audio_start/next/last, three 512-byte BIOS buffers, blocking next paces the program); PDM encoding moves to the SDK (pdm_init 0.4 s via add/addx, pdm_encod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
2026-10-21 docs/programmers-guide: spec rev 6 audio (buffer hand-off stream audio_start/next/last, syscalls 30-32; SDK pdm_init/pdm_encode); arp.c rewritten for the stream and run in the emulator (40,960 AUDIO 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
2026-10-21 fw: the BIOS only switches vector 28 while it still points at one of its own level-4 handlers, so a program's replacement vector survives INTEN recomputes; exit restores it (audio_reset_vector). Spec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
    [audio.c, audio.h, irq.c]
2026-10-21 docs: rev C note on 4-bit SD (board wiring, CMD divider, fitter result: needs USERIO dropped)
    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
2026-10-21 spec rev 7: native 4-bit SD bus bit-banged through SDIO (six open-drain lines CLK/CMD/DAT0..3 with read-back, reset 0x3F, 10 k pull-ups to 3.3 V, no level dividers); INTSTAT.SDMISO and the USERIO reg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
2026-10-21 docs: architecture and README for spec rev 7 (4-bit open-drain SD bus, USERIO removed, PDM audio chain)
    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
2026-10-21 hdl rev 7: CPLD2 drives the native 4-bit SD bus (six open-drain lines DAT3/CLK/CMD/DAT0..2 with pin read-back in SDIO, reset 0x3F, sd_dat1 pin 16, sd_dat2 pin 58); USERIO/UIO and INTSTAT.SDMISO remov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
    [cpld2_io.v, tb_system.v]
2026-10-21 KiCad rev C1: native 4-bit SD bus (CLK, CMD, DAT0..3 straight from CPLD2 with 10 k pull-ups to 3.3 V, the three 1.8k/3.3k dividers removed, DAT1/DAT2 on CPLD2 pins 16/58), UIO0..3 removed from J8 (pi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
    [other-m68k-bom.csv, other-m68k-cpu.kicad_sch, other-m68k-io.kicad_sch, other-m68k-jlcpcb-bom.csv, other-m68k-memory.kicad_sch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]
2026-10-21 docs: rev C notes mark 4-bit SD as done (spec rev 7, board C1)
    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
2026-10-21 fw rev 7: SD driver for the native 4-bit bus. sd4.S bit-bangs the six open-drain SDIO lines (CRC7 command frames and responses, 4-bit block read at 86.5 clocks/byte = 3.7 ms, block write at 112 clock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
    Claude-Session: https://claude.ai/code/session_019b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
2026-10-21 docs/programmers-guide: spec rev 7 / board rev C1. Native 4-bit SD bus: SDIO is now six open-drain lines with read-back (fields, semantics, reset 0x3F), INTSTAT.SDMISO and USERIO/UIO gone (register m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
    Co-Au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
2026-10-21 spec rev 8: serial port A is released after the POST; programs claim it as /dev/ttya
    The BIOS mirrors the console to DUART channel A only for the POST report and the banner
    (console_serial in main.c). After that console output is video only and console input is
    the keyboard only; the RX interrupt keeps filling the 512-byte ring, which sys_serial_getc
    and reads of /dev/ttya drain. The monitor's `srec` command reads the port itself (ESC on
    the keyboard or the port aborts); the S-record auto-detect on the command line is gone.
    /dev/ttya (spec serial.devices): fs_open gives device descriptors from the same slot
    table, no card needed; read blocks for one byte and returns what else is queued, wri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
2026-10-21 docs: programmer's guide for spec rev 8 (serial A released, /dev/ttya, srec, --text-dump); fix what the pass found
    Guide: console is screen + keyboard after the banner, new "Serial port A is yours: /dev/ttya"
    subsection with a stdio example run in the emulator, emulator recipes use --text-dump, srec
    workflow, syscall table rows 1-6/11-15, 2.11 BIOS use of the port, 2.14 dependency table,
    appendix timings re-measured without the serial wait (console ~2,600-3,000 clocks/char, 40 ms
    scroll). Fixes from the pass: the SDK shim's fstat now reports /dev/ descriptors as character
    devices so newlib line-buffers them (measured: a line reaches the port without fflush); spec
    serial.console names the fla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
2026-10-21 rev C1: audio low-pass 33 nF (C31); sys_read may fill a held BIOS audio buffer
    Board: the 1 k / 10 nF low-pass (16 kHz corner, which passed the PDM sigma-delta hiss above
    8 kHz) becomes 1 k / 33 nF (4.8 kHz). Same 0603 footprint and nets, so the routed board is
    unchanged except C31's value: fab package and release snapshot regenerated from it (DRC 0,
    0 unrouted). parts.json: Samsung CL10B333KB8NFNC, LCSC C307488. In the emulator
    reconstruction of the tune example the power above 8 kHz relative to the music band drops
    from -14 dB to -20.5 dB. ORDER.md names the B4 hand change.
    Firmware (spec rev 8 wording): sys_read accepts a destination inside the BIOS audio buffers
    while a stream is open (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
    [other-m68k-bom.csv, other-m68k-jlcpcb-bom.csv, other-m68k-pcbway-bom.csv, other-m68k.kicad_pcb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]
2026-10-22 spec rev 9: 768 KB FAT12 volume in the flash as drive C:, long file names, directories, scripts, clock
    The ROM image grows to 256 KB (ROM_IMAGE_SIZE 0x40000) and the remaining 768 KB of the
    flash window hold a FAT12 volume the BIOS mounts as drive C:; the SD card is D:. BIOS RAM
    (SYSDATA) grows to 31 KB, so USER_BASE is 0x8000.
    Firmware: FatFs with LFN (63 chars), relative paths and two volumes ("C:"/"D:" prefixes);
    fs.c gains stat/unlink/rename/mkdir/chdir/getcwd/copy/mkfs; flashdisk.c is the C: block
    layer with one 8 KB erase-sector cache, written back by flashram.S op 2 (interrupts masked,
    VBLANK flags counted so ticks and the clock stay right); clock.c keeps seconds since 1970
    from the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
2026-10-22 docs: programmer's guide for spec rev 9 (drives C:/D:, long names, scripts, clock); fix what the pass found
    The guide's rev 9 pass (sections 1.1-1.3, 1.6-1.8, 1.10-1.11, 2.1-2.2, 2.10, 2.12, 2.14,
    appendix) and the fw/sdk README and STATUS updates. Fixes from the two review passes: the
    SDK shim provides _rename (newlib's own rename() calls it; defining rename collided with
    libc), getcwd with len 0 returns E_INVAL as the spec says, the spec describes rename's new
    name the way FatFs resolves it (against the volume's current directory, drive letter
    ignored) and quotes the emulator's 150 ms sector write beside the data-sheet 100 ms, the
    flash RAM routine's op dispatch uses named labels (the firs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
    [syscall.c]
2026-10-22 monitor: line editor with history and Tab completion; quoted arguments; wildcard expansion for programs
    lineedit.c: Left/Right, Home/End (^A/^E), Backspace and Delete (^D) anywhere, ^K/^U/^W kills,
    lines wrapping over several rows, a 32-line history on Up/Down (`history` lists it; script
    lines and repeats are not recorded) and Tab completion through a callback: the monitor
    completes the first word against its commands and the NAME.ELF/NAME.CMD files on the search
    path (shadowed duplicates listed once), later words against the directory typed so far; one
    Tab inserts the unique match or the common prefix, the next Tab lists the choices.
    args.c: arguments split on blanks with double quotes gro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
2026-10-22 board rev C2 (spec rev 10): front and back edges, S-video jack, serial B header, dedication silkscreen
    The rev B4 order was stopped; rev C2 is what goes to PCBWay. The sheet's bottom edge is the
    machine's front: J3 PS/2, J6 audio, J4 microSD (LDO behind it), then SW1 RESET and SW2 NMI
    with the LEDs D5 PWR, D3 LED0, D4 LED1 behind them, all labelled. The top edge is the back:
    J1 USB-C, J2 serial A, J11 serial B (a second FTDI-pinout header on DUART channel B; it
    replaces the 2x8 expansion header J8, which carried only channel B and the rails after spec
    rev 7), J5 composite, J10 S-video (CUI MD-40SM mini-DIN 4 on the AD724's LUMA and CRMA
    outputs through 220 uF and 75 ohm each; new footprint a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
    [other-m68k-bom.csv, other-m68k-cpu.kicad_sch, other-m68k-io.kicad_sch, other-m68k-jlcpcb-bom.csv, other-m68k-pcbway-bom.csv, other-m68k-pcbway-centroid.csv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]
2026-10-22 emu: model the audio RC low-pass and anti-alias before sampling; the emulator no longer hisses at idle
    The renderer box-averaged the PDM pin straight into 48 kHz samples, which let the 63 kHz
    idle tone (the 0xAA pattern) and the sigma-delta noise above 24 kHz alias into the audio
    band at about -14 dB: a 14.8 kHz whine at idle (-26 dBFS) and hiss under music that the
    board's 1 k / 33 nF filter never passes. Now the pin waveform goes through that RC exactly
    (AUDIO_LP_R_OHM / AUDIO_LP_C_NF, new spec fields under "audio", generated into hw.h),
    is integrated over 240 kHz sub-samples, low-passed at 20 kHz by a 95-tap windowed-sinc
    FIR standing in for a sound card's anti-alias filter, and decimated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
    [audio.c]
2026-10-22 spec rev 11 / board rev C3: Atari joystick and paddle port on the DUART's I/O pins
    Hardware: J12, a DE-9 male with the Atari pinout on the front edge. The five switches go
    through 1 k into DUART inputs IP0..IP4 (up, down, left, right, fire), which already have
    10 k pull-ups. Paddles: each pot charges, through 1 k, a 15 nF capacitor; a 74HC14 gate
    (U14) pulls the up (A) or down (B) line low through a BAT54W when the capacitor passes its
    threshold, so those lines double as end-of-charge signals (a joystick has no pots, paddles
    no up/down switches); a dual NPN (Q1) on OP0 shorts both capacitors (pin high = shorted,
    the reset state); +5 V through a 200 mA polyfuse. Paddle A's button is on pin 4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
    [other-m68k-bom.csv, other-m68k-cpu.kicad_sch, other-m68k-io.kicad_sch, other-m68k-jlcpcb-bom.csv, other-m68k-pcbway-bom.csv, other-m68k-pcbway-centroid.csv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]
2026-10-23 rev C3 BOM: the six joystick-port part numbers checked against distributor listings; DE-9 footprint matched to Amphenol's .318 backset family
    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
2026-10-23 rev C3 release: BOM regenerated with the verified part descriptions
    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
    [other-m68k-bom.csv, other-m68k-io.kicad_sch, other-m68k-jlcpcb-bom.csv, other-m68k-pcbway-bom.csv]
2026-10-23 spec rev 12 / board rev C3: serial header B powers its device; OP1 on its RTS pin
    J11 pin 3 carries 5 V through F3 (200 mA polyfuse) and D8 (BAT54W, so a 5 V FTDI cable
    plugged in there cannot back-feed the board) for the serial-mouse MAX232 adapter; pin 6
    (RTS) is DUART OP1 so firmware can switch the mouse's RTS/DTR power and provoke its
    identification byte. J2 keeps GND, TXD, RXD only. Routed with the optimizer off after
    moving the analyser's resistor arrays 1.5 mm from the header: 0 DRC violations, 0
    unrouted; fab package and release regenerated. Spec, KiCad README, ORDER.md, architecture
    and the programmer's guide (2.11 channel B) describe it; no firmware change.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
    [other-m68k-bom.csv, other-m68k-cpu.kicad_sch, other-m68k-io.kicad_sch, other-m68k-jlcpcb-bom.csv, other-m68k-pcbway-bom.csv, other-m68k-pcbway-centroid.csv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]
2026-10-23 rev C3 BOM: in-stock substitutes from the PCBWay quote: ECS-2200B-240 oscillator, Assmann PLCC-84 and DIP-40 sockets, generic DIP-64 socket acceptable
    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
    [other-m68k-bom.csv, other-m68k-cpu.kicad_sch, other-m68k-io.kicad_sch, other-m68k-jlcpcb-bom.csv, other-m68k-pcbway-bom.csv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]
2026-10-23 rev C3 BOM: the SRAM, flash and AD724 leave the assembly BOM (we buy and fit them); ORDER.md gets the order-form substitution note
    PCBWay quoted $281 of parts for the B4 bill, $170 of it the five chips (AD724 $77,
    two AS6C4008 $31, two SST39SF040 $9.76) plus $60 for two machined sockets. The chips
    are now Assembly=customer / Chip_Supply=customer: the sockets ship empty, U11 is
    hand-soldered here, and nothing is consigned. ORDER.md gains the socket and substitute
    wording for the order form and the list of connectors to keep on the named part.
    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
    [other-m68k-bom.csv, other-m68k-customer-parts.csv, other-m68k-jlcpcb-bom.csv, other-m68k-memory.kicad_sch, other-m68k-pcbway-bom.csv, other-m68k-pcbway-centroid.csv, other-m68k-video.kicad_sch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]
2026-10-23 BOM: PCBWay descriptions carry only the part and its substitution rule; our sourcing remarks move to a Note field in parts.json, the KiCad BOM and the customer-parts list
    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
    [other-m68k-bom.csv, other-m68k-cpu.kicad_sch, other-m68k-customer-parts.csv, other-m68k-io.kicad_sch, other-m68k-memory.kicad_sch, other-m68k-pcbway-bom.csv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]
2026-10-23 PCBWay BOM: the DIP-64 socket row asks for any 0.9 in dual-wipe socket with the Mill-Max as fallback, the oscillator row drops the pin 1 explanation; ORDER.md carries the short order-form remark inst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
    [other-m68k-bom.csv, other-m68k-cpu.kicad_sch, other-m68k-jlcpcb-bom.csv, other-m68k-pcbway-bom.csv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]
2026-10-23 rev C3 silkscreen: drop the third dedication line, revision text reads "rev C3"
    Edited in placement.json and directly in the routed board (text only, no reroute); DRC 0.
    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
    [other-m68k.kicad_pcb]
2026-10-23 rev C3 silkscreen: ODD and EVEN under the flash sockets U5 and U4
    Text only, placed in the 1.5 mm strip between the socket outlines and the LED
    reference designators (size 1.2 mm); edited in placement.json and the routed board, DRC 0.
    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
    [other-m68k.kicad_pcb]
2026-10-23 plasma: tabulate the sine terms per frame, 4-byte palette words, constant stride; -O2
    12 VBLANKs a frame (5 fps) at -Os before; 6 at -Os and 5 at -O2 (12 fps) now, measured
    with a 300-frame copy on the emulator. The inner loop compiles to 12 instructions at -O2.
    The programmer's guide records the measurement.
    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
